jeffglousher/garden-auger-technic/README.md

# Garden auger

A printable housing for a continuous-rotation servo, with an auger for digging in the dirt. Print the parts, add the servo, and hook it up to power and controls.

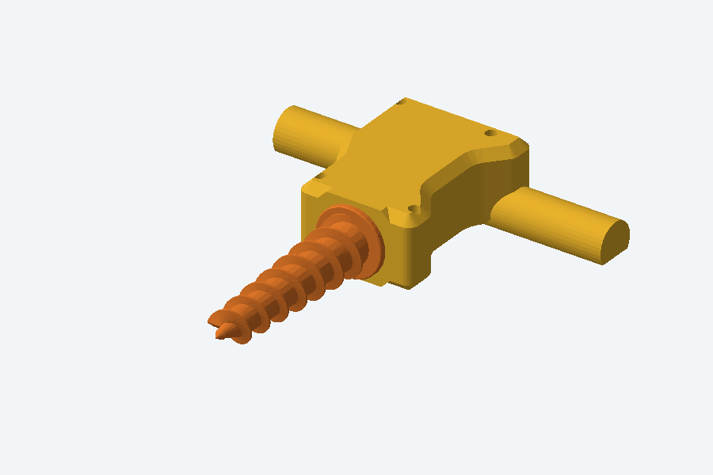
[picture p1: docs/images/turntable.gif]
Garden auger turning, with the auger rotating


## The parts

- A two-piece housing that holds the servo and drive assembly, secured with four screws.
- Rounded handles with flat bases for printing.
- A square drive adapter and replaceable wear bushing.
- A rotating dirt shield at the housing opening.
- Flush color lettering for part labels and hardware details inside the housing.
- Reinforcement around the screw holes and drive adapter.

The housing, auger and adapter use PETG. The bushing uses PLA.

## Inside the housing

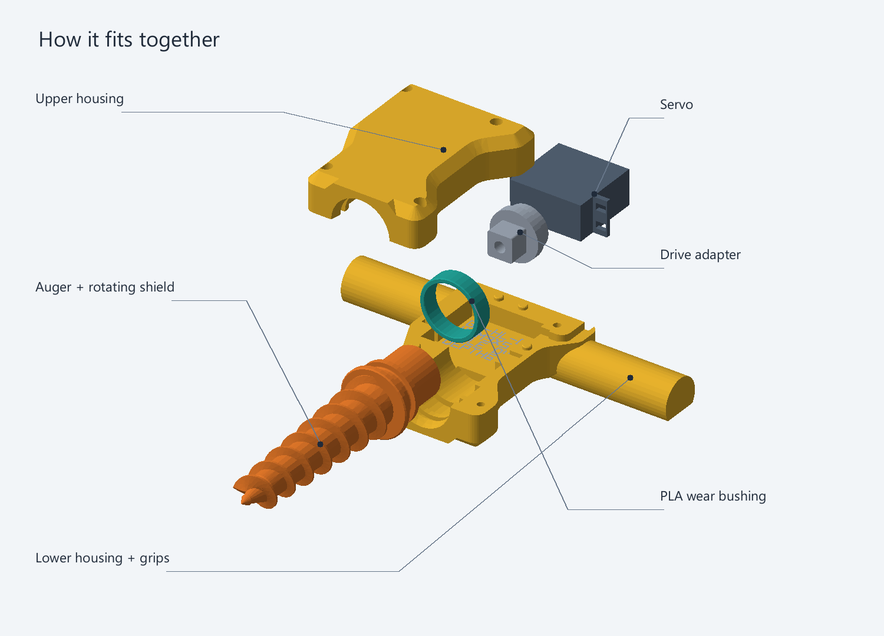
[picture p2: docs/images/exploded.png]
Exploded assembly with part labels


<details>
<summary>Watch it come apart with the drive turning</summary>

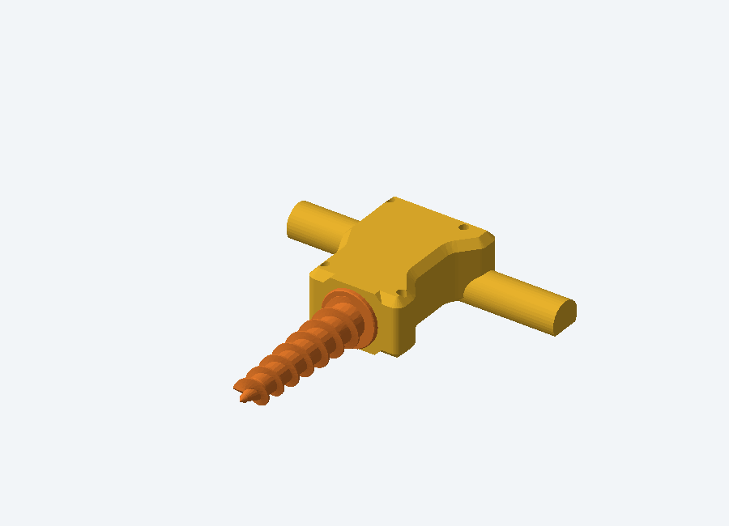
[picture p3: docs/images/exploding-drive.gif]
The housing opens while the auger and adapter rotate


</details>

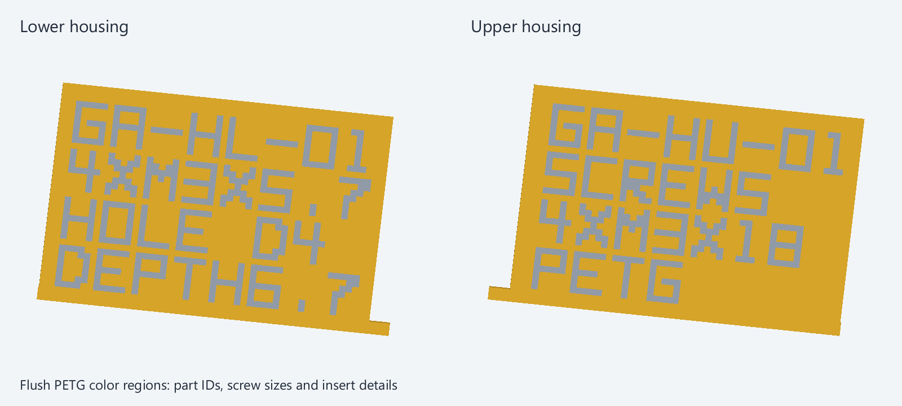
[picture p4: docs/images/inside-labels.png]
Flush part IDs and hardware details inside both housing halves


## How we made it

We designed and refined the assembly in **[Limo CAD](https://github.com/limo-cad/Limo-CAD)**, exported the parts, then prepared the print plates and local reinforcement for Bambu Studio. The CAD model and print settings are included so you can adapt the design to your own setup.

## Print plates

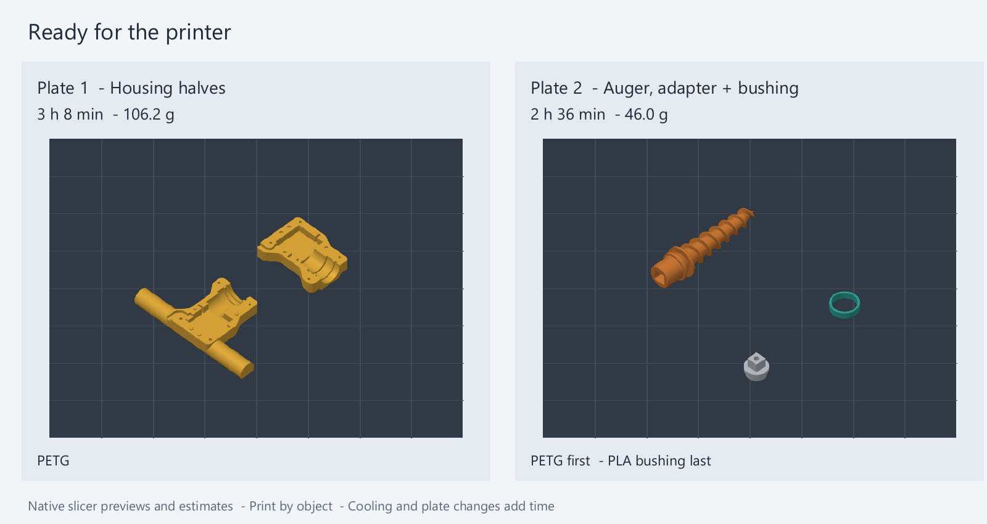
[picture p5: docs/images/print-plates.png]
Both print plates with their native slicing estimates


## Make your own

- [Editable Limo CAD model](garden-auger.limo)
- [Bambu Studio print project](print/garden-auger.3mf) · [Single-color textured lettering](print/garden-auger-single-color.3mf)
- [Individual STL files](print/parts/)
- [Larger lettering test coupons](docs/lettering-coupons.md)

[Assembly notes](docs/assembly.md) · [Design and print workflow](docs/workflow.md)
