jeffglousher/garden-auger-technic/docs/design-decisions.md

# Current design decisions

5 November 2026: [owner review feedback](../source/references/owner-design-review-20261105.json) confirms the **servo-to-adapter connection is proven and complete**. Do not reopen that acceptance from older provisional CAD reports. No new numerical torque rating or dimensions are inferred. The owner approved local reinforcement around the inserts and adapter hub, retained the matched locator fit, and declined the proposed relieved/slot locator arrangement. The current [local-strength print](../garden-auger-local-strength-assembly.3mf) uses five walls and 100% zig-zag infill in nine explicit modifier regions, with the three-wall/15% global baseline elsewhere. Both original housing shapes, all locating diameters/positions and the proven drive interface remain exact. Fresh native cylindrical witnesses and mesh sections confirm the chunky Ø5 x2.8 mm pins and at least 2.6 mm selected socket side stock. [Verification](../local-strength-verification.json) includes native modifier roundtrip, emitted local extrusion, unchanged print meshes and two-plate sequencing. Earlier drive-fit uncertainty is historical; broader joint durability and dirty trials stay in their existing issues.

30 October 2026: the owner clarified that only the orange rotating shield should shrink. Reduce its disc from 40 mm to 38 mm, preserving the current yellow housing and all other components. Nominal opening overlap is 2.2 mm; the existing 0.5 mm radial-offset allowance leaves 1.7 mm. Conditional axial clearance remains 1.1 mm. [Native before/after evidence](../disc38-review.json) compares against the committed 40 mm baseline. This is geometric coverage, not a proven dirt seal.

29 October 2026, printing simplicity requirement: prioritize simple printable solids, robust sections, continuous flat bed lands and controlled vertical bevels. Every extra lip, pocket or seal stage must justify its support and cleanup cost. [The simpler print revision](simple-print-review.md) removes the redundant fixed nose ring and shrinks the rotating flange to a plain 40 mm x3 mm disc with one0.6 mm front chamfer. It sits closer to the direct housing nose; use both matching new halves and auger because the closer disc clashes with older projecting rings. The nominal rear gap remains1.6 mm; opening overlap is3.2 mm. Horizontal auger print height drops48 to40 mm. Fitted internals, grips, flat bases, broad45-degree housing rims, hardware, cable route, adapter and bushing remain. Native support/time/material comparison uses identical saved settings; physical printing and dirty use remain qualification gates.

29 October 2026, auger entrance follow-up: [the integral rotating flange](ingress-flange-review.md) adds a ?48 mm shield ahead of the fixed yellow ridge, 3.4 mm maximum-radius overhang and 1.6 mm nominal rear clearance. A native wraparound-skirt trial trapped the upper lip during closure and was rejected. The final forward flange preserves normal clamshell closure; the housing, flight, adapter, bushing and existing fitted dimensions remain. Only the auger core gains a new revolve. This is noncontact protection, with ingress resistance and packed-soil behavior still requiring the dirty trial. Both print-by-object plates are resliced for the larger horizontal auger height; saved materials, supports, strengths and object order remain.

29 October 2026: [controlled vertical bevels](chamfer-envelope-review.md) supersede the broad R5 face rounds with **5 mm equal-leg, 45-degree chamfers** on both pocket-up housing halves. Retain rounded plan-view transitions; the vertical section controls the print underside. The circular bearing jacket also changes to flat bed lands and 45-degree shoulders so it does not retain a shallow circular underside start. Its original functional cuts, fixed bearing cover and drive datum remain. The complete D grips already start at a 56.63-degree underside tangent and remain rounded for comfort. Both sequential-print plates, materials, fitted cavities, hardware, locators and rear cable route remain; use both matching chamfered halves. Physical qualification is still open.

20 October 2026: the owner confirmed removing material from both broad top/bottom outer faces and left/right walls, while absorbing the plan-view cheek steps. [The rounded-envelope revision](rounded-envelope-review.md) uses R5 outer-face rounds, a slimmer side outline with long blended transitions and an integral bearing jacket protecting the 2.8 mm entry roof. It removes 4.80 cm³ /2.07% net housing volume while retaining fitted features, lower D grips, flat print bases, hardware, cable exit and materials. Body X envelope reduces from77 to75.3 mm; the central41.2 mm depth remains constrained by the fixed bearing seat/cover. Selected wall/contact checks and full functional/native-slice checks accompany the matching CAD/print project. No cosmetic seam scallops are restored; physical strength and fit remain open.

18 October 2026, closed-frame correction: the owner rejected curved cutouts along the inside/seam of the assembled frame. [The continuous-frame revision](solid-frame-review.md) suppresses all eight cosmetic shoulder cuts and rebuilds only the R6 outside front corners. Side walls now meet continuously; the D grips, flat print bases, locating pins, cavities, screw stacks, cable exit, materials and drive components remain. Preserve rounding on exterior corners and profiles; do not reintroduce cosmetic seam recesses. Use the matching solid-frame CAD and complete project listed in the review. Physical acceptance remains open.

18 October 2026, D-grip follow-up: [the new grip review](child-d-grip-review.md) supersedes the large paired handles and preceding layout. Both complete radius-12 D grips belong to the lower housing: 24 mm wide, 18.6 mm high, 20.04 mm flat bed land and 55 mm clear length per side across a 187 mm span. The upper is a central cover; four Ø4/Ø4.3 locators move into the case, and a local rear cheek preserves the existing cable route. Fixed internals and four screw stacks remain. Both plates now pass native by-object slicing at saved clearances, approximately 8 h 42 min /232.0 g total. The 24 mm choice needs an actual hand comfort check; a separate sample is supplied. Physical clamped stiffness, root strength, fit and dirty testing remain open. Earlier statements about handle height, locator locations and by-layer housing layout describe prior revisions.

18 October 2026: [two-plate geometry review](two-plate-geometry-review.md) supersedes the preceding full-print layout. The matching housing plate stays by layer after two native by-object collision rejections. Plate 2 uses verified sequential toolpaths, the rear auger separated from short front objects, and a wait for 55 C before the final PLA bushing. All three design areas were reviewed: R12.5 exterior relief, local X accommodation in the two outer locator sockets, retained drive/bushing fits, and four clear driver approaches. Fixed servo datums, continuous bed floors, cable route and materials remain. Physical stiffness, tightened fit, shaft engagement, threads and dirty trial remain pending.

The owner's latest direction treats the teal part as a **bushing derived from the fixed journal and housing**, releasing its former length as a requirement. The [replacement bushing](constraint-bushing-review.md) retains the radial interfaces, shortens to9.80 mm with0.55 mm end room on each side, and adds inner/outer chamfers at both ends. Housing, shaft, adapter, locating features, screws and cable route remain locked. The new single-part PLA project is the replacement candidate; earlier sleeve measurements and audits remain historical evidence rather than a requirement to preserve that sleeve's length.

On 14 October the owner requested a ring tolerance check and rounder housing sides. The [rounded candidate and audit](rounded-housing-review.md) retain functional dimensions and the sleeve: native ?28.60 bore /?34.00 outside /10.40 length agree with the existing STL. Nominal clearances are0.60 mm to the journal diameter,1.60 mm to the housing diameter and0.50 mm total axial freedom. The owner subsequently confirmed the teal sleeve seems to prevent closure. The [closure audit](../sleeve-closure-review.json) found no seat shrinkage across current CAD or scaling in the six sparse projects. The functional-bushing direction above supersedes preserving the old sleeve length; physical fit of the replacement is the next check. R4 grips/tips, R6 front corners and R9.5 side relief replace sharper exterior features. Use the separately named rounded CAD and matching print projects; earlier candidates remain evidence.

Use these decisions when rebuilding or reviewing the current assembly. On 8 October 2026 the owner reported successful physical fit and assembly of all current parts. The first dirty trial and loaded performance remain pending. Historical alternatives in Git and supplier reference files do not select a different design.

- The owner [reports that the fitment tests succeed and all current parts assemble](../source/references/servo-assembly-fit-feedback-20261008.json), superseding the earlier lower-half-only report. This resolves [physical-fit failure #2](https://github.com/jeffglousher/garden-auger-technic/issues/2); track the first dirty trial in [issue #3](https://github.com/jeffglousher/garden-auger-technic/issues/3). Keep the reviewed geometry and both matching sparse halves as the current baseline. The authorized detail revision is separate from this successful fit baseline. Assembly success does not establish loaded strength, torque, creep, wear, actual shaft engagement or usable screw thread depth.
- The owner explicitly authorized the CAD revision on 8 October 2026 after lifting the machine-use hold. The [detail revision report](clamshell-detail-review.md) records four alternating chamfered handle locators with provisional 0.30 mm diametral clearance, four identical M3 x18 housing screws and unchanged RX-M3x5.7 insert pilots, side/depth shoulder relief and a fixed external auger-entry deflector. Preserve all fitted component cavities and drive/auger/sleeve geometry. The owner tested handle flex while holding the halves together by hand; screwed-joint performance was not tested. New locator fit, hardware engagement and dirty performance remain physical gates. Both detail halves must be used together; the snug-nest pair remains the successful physical baseline.
- The [sparse upper-half Bambu copy](../garden-auger-upper-servo-sparse-test.3mf) is exported directly from the reviewed snug-nest CAD, with the same 0.28 mm layers, 0.50 mm lines, two walls, 5% rectilinear infill, three top/bottom layers, no support or prime tower. Global settings are byte-identical to the [sparse lower-half copy](../garden-auger-lower-servo-sparse-test.3mf); no conflicting object strength overrides are added. Native CAD checks the upper's pocket-up bed placement, and [native Bambu slicing](../servo-upper-sparse-print-verification.json) estimates 1 h 15 min /45.9 g with no supports. Individual bridge-quality and clearance measurements were not separately reported. Preserve original slice reports as dated evidence; the later physical assembly feedback is separate. The CAD typed metadata inspector still rejects rectilinear, so native Bambu results are the process evidence.

- The owner's [caliper readings](../source/references/servo-caliper-readings.json) supersede the drawing for this hardware: **27 mm ear underside to rear case and 38 mm main case length**. The drawing's 41.5 mm tip-to-rear, 37.5 mm case height, 20 mm width, 56 mm ear span and 2.7 mm ear thickness remain source references, not new physical readings. Measurement 4 is unavailable. Do not shift the ear/drive datum from the 27 mm reading alone: it does not establish shaft-to-ear position. Use the [snug-nest CAD test](../experiments/garden-auger-servo-snug-test.limo) and [lower-half test project](../garden-auger-lower-servo-snug-test.3mf). The rear wall remains Y194.0; centred ear slots tighten to Y162.65–165.65; rear-stop-to-wall space is 28.35 mm. Preserve the conservative 41.3 mm case plan bay pending case-to-shaft offset confirmation. It supplies clearance; the ear tips locate X and the clamshell capture faces locate Z. [Source provenance](../source/references/provenance.json) retains the original drawing unchanged.
- One PETG adapter seats directly on the servo's metal shaft, retained by its compatible center screw. Its round pilot has no printed spline teeth. There is no separate metal horn or M4 mounting pattern.
- The pilot is provisionally Ø5.70 ×3.70 mm. Select the diameter from the four physical fit coupons. The [Hitec H25T depth reference](../source/references/hitec-horn-spline-2026.pdf), printed page 75, supplies the 3.70 mm design depth; it is not a universal servo standard.
- Keep the 14 mm rounded square peg, 14.4 mm socket, Ø24 adapter boss, Ø28 ×5 mm flange and full loose PLA sleeve. The clamshell alone captures the collar and sleeve. No ring lock or clip is needed.
- Use the current test housing with its shared entrance taper, **3.00 mm axial ear slot, 56.40 mm ear-tip span and 20.40 mm case/ear capture width**. Nominal total servo movement is 0.30 mm axial and 0.40 mm in each other direction, conditional on source hardware sizes and manufactured fit. The rear adapter chamber ends at Y153.6. Preserve the screw seats and four Ø4.00 ×6.70 mm insert pilots for ruthex RX-M3×5.7 inserts. Add no geometry features or separate servo-retaining hardware.
- Use a continuous flat exterior bed face under both halves. The tightened test's servo floor is 10.40 mm, bearing floor 2.80 mm nominal, and ear-tip side stock is 4.10 mm at the native sampled centre section. Tangent native arcs blend around the ears; do not restore stepped ear bulges or the suspended 2.80 mm floor relief. Handles have 11.50 mm bed lands and 45-degree shoulders, with their rear edge aligned to the body. Their assembled depth is 41.20 mm. The model still has 71 active entries. Nominal or sampled dimensions are not global wall or strength certification.
- Preserve saved Bambu global printer, material, strength, support and purge settings. Set support generation off only for the two housing objects; the upper screw-recess roofs must bridge and need physical print verification. A native automatic-support probe confirms the lower geometry needs no supports. The housing plate requires purge-tower X180/Y142; this is a layout correction, not a process-profile change. The lower-half test file keeps its independently checked single-half tower location.
- The current entrance is Ø33.6 to Ø31.2 in the existing revolve. Check ±0.50 mm tolerance-extreme auger travel separately from ±0.30 mm nominal travel. Native envelope samples also cover the nominal servo-pocket diagonal offset of 0.566 mm. [Consistency audit](design-audit.md) records the prior validation failure and the limits of this coverage.
- Installed flange allowance is ±0.50 mm from the actual front chassis thrust face: 0.20 ear gap +0.10 ear stop +0.10 seat-to-flange +0.10 datum transfer. The conservative square stack gives 8.80–11.20 mm engagement, at least 0.80 mm tip gap and 0.50 mm hub-to-flange gap. These are conditional inspection limits, not native GD&T certification or measured print capability.
- Engage the square before nesting the assembly. The auger and loose sleeve must follow the servo drive axis. Common housing-axis clearance does not certify relative square misalignment; a native 0.30 mm independent-offset control collided. Inspect free axial sliding, alignment and rotation.
- CAD design colors and saved slicer spool colors have distinct purposes; both remain explicit in [README](../README.md). The Bambu project contains current object overrides. Portable 3MF exports carry geometry and material metadata; STLs carry only geometry.

The earlier physical failure was explained by insufficient rear space for the measured 27 mm ear-to-rear distance. The [feedback audit](../servo-fit-feedback-20261007.json) preserves the investigation before caliper readings arrived. The [rear-extension evidence](../servo-27mm-test-verification.json) reproduces the old collision and tests the separate rear extension with a conservative envelope. A native intersection also located a small rear-pad corner that refilled the enlarged pocket; the existing case cut was reordered after both rear pad joins, before the cable and fastener cuts. Add no geometry features. The auger, adapter and sleeve native meshes and materials are unchanged. The revised snug-nest assembly now passes owner fit testing, while shaft-to-ear/front-face datums remain drawing references. The drawing's 37.5 mm case height and its catalog 40.5 mm height remain inconsistent source values; the test reference is explicitly a clearance envelope, not a fully measured servo. Preserve the owner's modified lower-half Bambu template and its object/process settings. Dirty-trial behavior, usable screw depth, shaft engagement, loaded torque, creep and wear remain unconfirmed. The redundant rear-extension print and abandoned horn STEP/PDF were removed with recovery recorded in [cleanup history](../release-cleanup.json); keep older CAD and templates that still support rebuilds or evidence.

The separate CAD application team owns the 3MF feature work tracked in [Limo-CAD issues #312–#316](https://github.com/jackControls/Limo-CAD/issues/312). This repository continues to use its existing export and Bambu preparation scripts until those capabilities are implemented and verified.

New experiment findings are filed as [assembly animation #346](https://github.com/jackControls/Limo-CAD/issues/346), [named-view camera #347](https://github.com/jackControls/Limo-CAD/issues/347), [hole inference #348](https://github.com/jackControls/Limo-CAD/issues/348), [cable routing #349](https://github.com/jackControls/Limo-CAD/issues/349), [wall thickness #350](https://github.com/jackControls/Limo-CAD/issues/350) and [fit stacks #351](https://github.com/jackControls/Limo-CAD/issues/351). Our own packaging script's reset of user object settings is [project issue #1](https://github.com/jeffglousher/garden-auger-technic/issues/1); the related user feedback is attached to [3MF handoff #316](https://github.com/jackControls/Limo-CAD/issues/316#issuecomment-6035859200). The [issue index](../experiments/upstream-issue-index.json) records evidence, categories and links. Keep findings in issues. As requested by the owner on 8 October 2026, repository changes now go through PRs and are merged immediately after validation. CAD application implementation still waits until the owner confirms [Bevy finalization](https://github.com/jackControls/Limo-CAD/issues/38). Observed application bugs need reproduction against that finalized build before a fix is claimed; current experiments remain external project tooling.

The cable exits the rear face toward the controls through a 6 ×8 mm split-seam route with one tangent R8 trial bend. The side outlet and its exterior bulge are superseded by the user's rear-routing preference. The rear outlet is centered at X28/Y206.5 and clears the screw at X16/Y196.8. The old straight route ended inside a handle, and a later pad join partly filled its boot bay. Reuse and reorder the existing cable cut after all housing joins. Keep the connector outside. Bundle, boot, seam entry and minimum bend radius remain trial assumptions requiring physical fit. The [native cable experiment](../cable-route-verification.json) tests continuous Ø4/Ø5 swept envelopes and rejects Ø6.2, without adding a cable to print exports or claiming flexible-wire mechanics.
