jeffglousher/garden-auger-technic/docs/servo-fit-review.md

# Servo fit review — 7 October 2026

## Current snug-nest test

**Next physical print uses [the matching sparse upper-half copy](../garden-auger-upper-servo-sparse-test.3mf).** The owner [reports the lower half seems OK](../source/references/servo-lower-fit-feedback-20261007.json) and requests the other side with the same dimensions. This upper is exported directly from body 26 of the reviewed snug-nest CAD; no CAD geometry is modified. It uses the lower sparse project's identical saved global process, printer and filament bytes: 0.28 mm layers, 0.50 mm lines, two walls, 5% rectilinear and three top/bottom layers, no supports or prime tower. Native CAD checks one pocket-up upper half on its outer bed face and native Bambu estimates **1 h 15 min /45.9 g**, with zero support toolpaths or filament changes. [Upper verification](../servo-upper-sparse-print-verification.json) records native export/placement equality, a closed connected solid, package hashes and preserved files. Inspect screw-recess bridges physically; matching-half closure and complete assembly fit remain pending.

The [sparse lower-half copy](../garden-auger-lower-servo-sparse-test.3mf) preserves every model/bed-transform byte from the stronger reviewed lower copy and removes strength overrides so Global settings apply. Native Bambu estimates 1 h 12 min /45.3 g with no support or prime tower. The same lower geometry's stronger profile estimates 3 h 26 min /109.2 g. [Lower native slice proof](../servo-sparse-print-verification.json) records these results and the CAD inspector's unsupported-rectilinear limitation. Native slicing also found and verified a correction to the helper's OPC relationship serialization; this changed package spelling only.

The previous review checked clearance but allowed unnecessary movement. Independent native probes using the measured 38 mm case length and 27 mm rear length showed about 0.90 mm total X travel, 0.80 mm Z travel and 0.40 mm Y travel in the rear-extension test, conditional on the drawing's ear envelope and shaft-to-case offset. The 41.30 mm body clearance bay does not itself locate the smaller case. Ear outer ends and clamshell capture faces must do that job.

The [current CAD test](../experiments/garden-auger-servo-snug-test.limo) reuses its two existing pocket cuts:

- Axial ear slots: **3.00 mm**, Y162.65–165.65 around source ear faces Y162.8–165.5. Nominal total axial movement is **0.30 mm**.
- Ear outer-tip capture: **56.40 mm**, X−38.2 to +18.2 around the source 56 mm span. Nominal total lateral movement is **0.40 mm**.
- Case/ear capture between halves: **20.40 mm**, Z±10.2 around the source 20 mm width. Nominal total capture movement is **0.40 mm**. The continuous flat floor gains 0.20 mm stock, becoming **10.40 mm** locally; exterior/handle geometry is unchanged.
- Rear ear stop to rear wall: **28.35 mm**, leaving **1.35 mm** behind the measured 27 mm rear length at the rearward stop. The rear wall remains Y194.0. Keep the case cut after both rear pad joins so they cannot refill its corner.
- The conservative 41.30 mm case plan bay remains clearance space. Its 3.30 mm excess over the measured 38 mm case is not the servo's travel allowance. A tighter body bay would require the actual case-to-shaft/ear offset; do not invent that datum.

Native exact checks clear the independent solid-ear probe at X/Z±0.19 mm and Y±0.14 mm, and reject X/Z±0.21 mm and Y±0.16 mm. Separate principal-axis angular samples about the ear-centre pivot clear ±0.1° and reject ±1°; they do not establish maximum angular play or a combined six-DOF contact envelope. Nine coupled assembly offset poses and 24 auger rotation/end-float samples pass. The lower half is one closed connected native-export mesh. The print presentation matches its Bambu bed placement and passes native envelope preflight. The available section tool returns material intervals excluding voids; this is sampled geometry, not a strength or global minimum-wall calculation.

The [raw native review](../servo-snug-review.json) retains face keys, tool outputs, build hashes, settings inspection and limitations. [Ear-nest section](../renders/servo-snug-ear-nest.svg), [floor section](../renders/servo-snug-servo-floor.svg), [square socket](../renders/servo-snug-square-socket.svg), [adapter seat](../renders/servo-snug-adapter-seat.svg) and [PLA bushing](../renders/servo-snug-pla-bushing.svg) are unmodified native section diagrams.

The square remains 14.0/R1 into 14.4/R1.2, with 10 mm nominal engagement, 2 mm tip room and 1.6 mm flange gap. Journal/bushing remain Ø28/Ø28.6; the full PLA ring is Ø34 in a Ø35.6 housing chamber. Collar end float remains 0.6 mm; sleeve end float remains 0.5 mm. Four native insert pilots remain Ø4.0×6.7 mm for RX-M3×5.7 inserts. The adapter retains its Ø5.7×3.7 trial pilot, Ø24 boss, Ø28 flange, 2.6 mm seat-to-head-seat stack and Ø3.4/Ø6.4 passage/access. Native faces confirm these values, and all four non-housing body meshes are unchanged. Retain the conservative existing installed-position acceptance limits; their hardware datums still need physical confirmation.

**Print next: [the matching sparse upper-half Bambu test](../garden-auger-upper-servo-sparse-test.3mf).** Pair it with the revised sparse lower half already tested by the owner. The [stronger-profile lower copy](../garden-auger-lower-servo-snug-test.3mf) has the same reviewed lower geometry with its saved strength overrides retained. All three test projects were natively sliced; their estimates and package hashes are recorded above. The owner's saved [original lower-half template](../garden-auger-lower-fit-test.3mf), preserved in commit `fb259e4`, contains historical geometry that failed fit. File names and modification times do not select a print candidate. Final capture requires both matching revised halves. These small clearances are trial design values, not measured printer capability. Only 27 and 38 mm are new hardware readings; measurement 4 is unavailable, and 41.5 mm remains a drawing reference. The 20 mm width, 56 mm ear span, 2.7 mm ear thickness and shaft offsets also remain source references. The reference deliberately remains a clearance envelope rather than a fully measured servo. No clip, separate servo clamp or new hardware is introduced.

## Physical feedback before further prints

Record the exact project printed and report these observations in [project issue #2](https://github.com/jeffglousher/garden-auger-technic/issues/2):

1. Servo seating and play: does the rear case clear the wall and do both ears seat fully? Describe axial, lateral and across-seam movement separately.
2. Matching-half closure: with a revised upper half, do the mating faces close fully without forcing the servo? A lower-half-only test leaves this check pending; an older upper half does not verify revised capture.
3. Adapter alignment and seating: does the square engage and slide freely with the adapter seated on the servo? Actual shaft engagement and usable screw thread depth remain unconfirmed; report them separately from housing fit.
4. Auger rotation: does the assembled auger turn freely and retain collar/sleeve end float without binding?
5. Cable routing: does the actual boot and bundle fit the rear exit without pinching when the halves close, with the connector outside?

Keep issue #2 open pending physical feedback. Obtain that feedback before declaring production ready or printing dense replacements. Native checks are sampled geometry evidence; they do not establish manufactured fit, strength or complete GD&T compliance. Request additional calipers only when an observed problem requires them, using clearly numbered marked images and without inventing shaft-relative offsets or measurement uncertainty.

## Earlier corrections — historical

**Physical-test update: the owner measures 27 mm ear underside to rear case, versus 24.7 mm in the drawing.** The production housing has only 26.0 mm from its rear ear stop to its rear wall. The correction below is historical. The [original feedback audit](../servo-fit-feedback-20261007.json), [caliper readings](../source/references/servo-caliper-readings.json) and [rear-clearance checks](../servo-27mm-test-verification.json) preserve the measured failure and first separate 2.3 mm rear-extension test. That test is superseded by the snug-nest test above.

The model was wrong. The 24.7 mm dimension in your diagram starts at the **underside/rear face of the mounting ear**. The servo reference and housing used its opposite face, moving the ears and pockets 2.7 mm rearward. The same error in both parts made the previous clearance check falsely pass.

Seating the drawing-dimensioned servo in those old pockets placed its rear face 1.2 mm beyond the cavity. That correction restored the drawing datums, cleared the larger catalog case length and accounted for the resulting adapter-position stack. **The auger, square adapter, PLA sleeve and four fit coupons remained byte-identical to that previous release. The new physical fit failure requires further investigation before reprinting either housing half.**

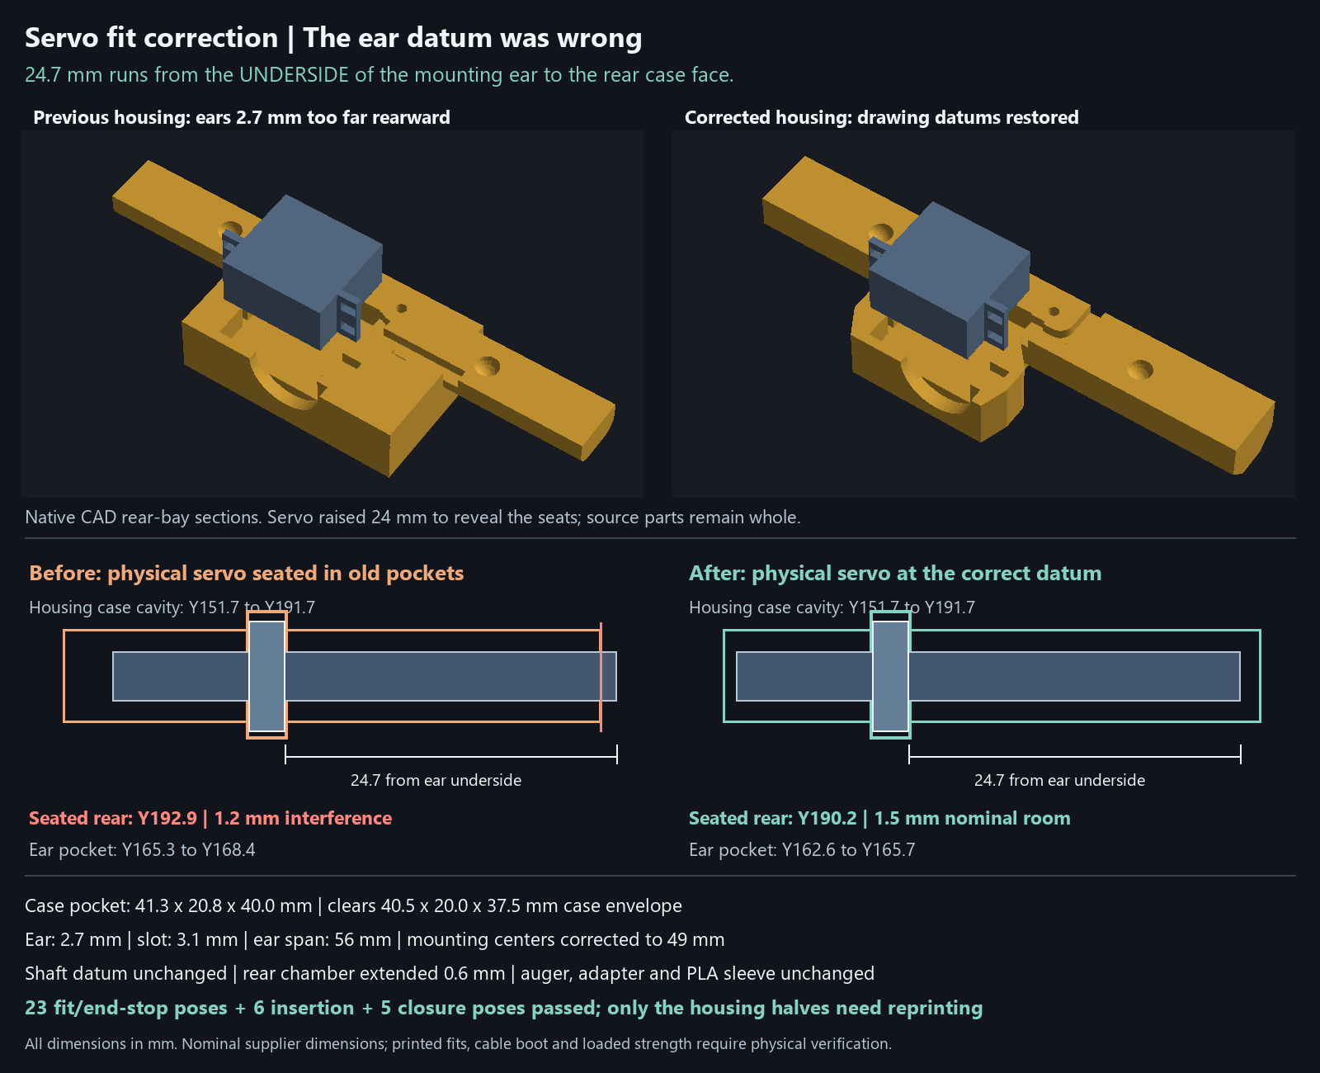
[picture p19: renders/housing-preprint-review.png]
Native CAD and dimensioned before/after comparison


## Dimensional authority and correction

The [original supplied image](../source/references/user-servo-fit-diagram.png) is retained unchanged with its SHA-256 in [source provenance](../source/references/provenance.json). It labels the 270° variant; the retained 360° supplier image has the same mechanical datums. The requested INJS035-360 drive remains the selected servo. The detailed mechanical drawing controls axial datums; the catalog's separate 40.5 ×20 ×40.5 summary does not override the explicitly drawn 37.5 mm case height and 41.5 mm tip-to-rear distance.

Every shown mechanical dimension was checked:

- Case plan: drawing 40 ×20 mm; the larger 40.5 mm catalog length is used conservatively. The cavity is **41.3 ×20.8 mm**, giving 0.4 mm clearance on each side of the larger case envelope.
- Shaft tip to rear case: **41.5 mm**; case axial height **37.5 mm**. Their difference is **4.0 mm nominal tip-to-case-front separation**. The reference contains no invented stationary nose.
- Ear underside to rear case: **24.7 mm**; ear thickness **2.7 mm**. With the shaft tip at world Y148.7, case faces are Y152.7/Y190.2 and ear faces are **Y162.8/Y165.5**.
- Corrected housing ear pockets: **Y162.6–165.7**, 3.1 mm wide axially, with 0.2 mm nominal clearance on each ear face. Previous pockets were Y165.3–168.4.
- Case cavity axial span: **Y151.7–191.7**, 40.0 mm. This already had sufficient total length at the correct datum: 1.0 mm nominal front room and **1.5 mm nominal rear room**, or 1.3 mm rear room at the nominal rearward ear-travel limit. Moving the ear seat restores the available length behind it from 23.5 to **26.2 mm**, exceeding the required 24.7 mm.
- Ear overall span: **56 mm**. Reference mounting-slot centers corrected from 52 to **49 mm** apart. The shaft is **10 mm from the right case edge**, centered across the 20 mm width. Slot widths/radii are not dimensioned; their conservative reference cut envelopes are retained. The fit inspection fills the ears solid, so those holes cannot hide a collision.

The two housing halves receive the same corrected case and ear cuts. The existing cut features are reused; no extra retaining hardware or grooves are added. The later exterior-thinning revision reuses these corrected pockets and removes eight obsolete entries, leaving **73 active history entries**. Materials, colors and assembly poses are preserved.

## Mating surfaces and tolerance stack

The adapter, auger and sleeve are unchanged. The existing Ø29.6 rear chamber ends at **Y153.6**, 0.6 mm farther rearward, to accommodate the corrected installation allowance. Adapter rear clearance is **1.2 mm nominal /0.5 mm conditional minimum** under the audited allowance below. Boss radial clearance is 2.8/2.2 mm; flange radial clearance is 0.8/0.2 mm.

The consistency audit adds the omitted **0.10 mm datum-transfer allowance** to the former 0.40 mm budget. Inspect the installed flange **27.40 ±0.50 mm behind the actual front chassis thrust stop**: 0.20 mm ear gap +0.10 mm ear-stop extrema +0.10 mm seat-to-flange extrema +0.10 mm transfer to the printed thrust face. World Y141.1 is the nominal CAD flange location, not a physical inspection datum. Common drive-axis radial offset must be no more than 0.50 mm; relative square alignment is a separate requirement.

Critical printed dimensions and functional-face extrema require ±0.10 mm acceptance; this includes surface form at the contact extrema. Collar/sleeve length and capture-span controls also apply. These are inspection requirements, not measured printer capability, supplier tolerances or native GD&T certification. The audited conservative square stack gives **8.8–11.2 mm engagement**, **at least 0.8 mm peg-tip clearance**, and **at least 0.5 mm hub-to-flange clearance**. The 14 mm/R1 peg and 14.4 mm/R1.2 socket retain at least 0.10 mm flat clearance per side under the profile controls only when their mating datums align. Engage the square first and let the auger and loose sleeve follow the servo axis before closing the housing.

The integral collar retains both thrust stops and 0.6 mm nominal total end float, conditional 0.4–0.8 mm. The loose PLA sleeve retains 0.5 mm nominal float, conditional 0.3–0.7 mm. The [consistency audit](design-audit.md) widens only the entrance end of the existing flight taper from Ø33.2 to **Ø33.6** to cover the full axial tolerance budget and diagonal offsets. The Ø31.2 collar-stop opening stays unchanged. The split-seam cable path is now 6 mm wide ×8 mm high with one tangent trial R8 turn to the rear face toward the controls. [Routing evidence](../cable-route-verification.json) checks assumed cable envelopes; cable-boot dimensions and acceptable bend radius are not shown in the diagram.

## Hardware and materials

- Four **ruthex RX-M3×5.7** heat-set inserts, Ø4.6 ×5.7 mm, use unchanged **Ø4.00 ×6.70 mm** pilots. The full cable-boot bay leaves at least **3.07 mm sampled surrounding wall after allowance** at the closest rear insert. Install flush with the split face.
- Housing screws remain **two M3×12 front and two M3×18 rear**. Nominal insert engagement is 4.0/5.3 mm. Passages and insert mouths remain open.
- The adapter retains its **Ø5.70 ×3.70 mm trial pilot**, Ø24 boss, Ø28 ×5 flange, 2.60 mm seating web, Ø3.4 center passage and Ø6.4 head access. The nominal trial center screw is **M3×6**, with 3.4 mm nominal insertion and 3.1–3.7 mm conditional insertion. A usable shaft-hole depth of at least 4.0 mm is required; internal thread depth and factory screw length are not shown in the diagram. Native printed-part screw clearance is verified; actual bottoming and thread engagement remain physical checks.
- CAD/portable export: housing **PETG yellow #E5AE3C**, auger **PETG orange #D57E37**, adapter **PETG gray #BEC3CA**, sleeve **PLA teal #37AAA1**.
- Bambu's saved spool palette remains **#034638, #FF671F, #FFFFFF, #DCF478** with PETG Basic /PLA Glow profiles. Housing: 6 walls, 30% gyroid, 6 top/bottom layers. Auger: 6 walls, 40% gyroid, 6 top/bottom layers. Adapter: 6 walls, 100% infill. Existing tree supports and PLA interfaces are retained.

## Evidence and delivery

The subsequent [direct CAD tool review](cad-tool-validation.md) distinguishes native tool results from separately derived tolerance bounds. Its [inspection project](../garden-auger-fit-inspection.limo) contains associative nominal measurements; its [raw results](../cad-tool-validation.json) retain the tool's warnings and limitations.

The [independent servo fit regression](../servo-fit-verification.json) recreates the old failure from literal drawing dimensions, rather than reusing production parameters. It confirms the old erroneous reference passed, while the correct envelope collided with both halves. The corrected native solids pass **23 fit/end-stop checks**, **6 lower-half insertion poses** and **5 upper-half closure poses**. The two beyond-limit poses correctly encounter the ear stops. The final document contains no inspection probe or temporary screw body.

The [component review](../preprint-review.json) separates **45 nominal housing-only motion poses** from five native conservative flight-envelope samples at +0.50 mm travel and six full coupled assembly poses. It retains the intentionally failed 0.30 mm relative-square-offset control. The [adapter review](../adapter-housing-verification.json) checks nine installed-position samples. Canonical meshes, closed connected print solids, native schema-7 desktop round trips, material/pose preservation and the seven unchanged non-housing STLs are recorded in [release verification](../direct-drive-verification.json), [nesting verification](../housing-nesting-verification.json) and [Bambu layout verification](../bambu-latest-verification.json). [Native Bambu slice verification](../bambu-slice-verification.json) records the refreshed four-plate check. These checks do not replace a native motion sweep or GD&T validator, which the available tool does not provide.

These historical artifacts are retained for provenance: [earlier editable CAD](../garden-auger-direct-drive.nbcad), [complete Bambu project](../garden-auger-bambu-latest.3mf), [lower housing STL](../print-parts/direct-drive/petg-housing-lower.stl) and [upper housing STL](../print-parts/direct-drive/petg-housing-upper.stl). Their housing geometry failed physical fit. [All-part CAD views](../renders/direct-drive-all-parts.png) and [exploded assembly](../renders/direct-drive-exploded.png) show that earlier assembly. Use the reviewed snug-nest CAD and matching sparse upper-half project at the top of this review for the next test.

The corrected geometry matches the shown mechanical dimensions. Physical verification still applies to unshown cable-boot and thread details, actual printed fits, and loaded torque/creep/wear. Those checks do not reopen the confirmed dimensions in your drawing.

The current exterior revision restores a continuous printable floor, blends the ear exterior and supports the grips from the bed. Case/ear pockets, drive seats and screw-head planes remain unchanged. The updated native fit checks use this saved source. See [print evidence and bridge limits](../housing-print-verification.json).
