jeffglousher/garden-auger-technic/source/horn-1906-0025-0032/spec-sheet.pdf

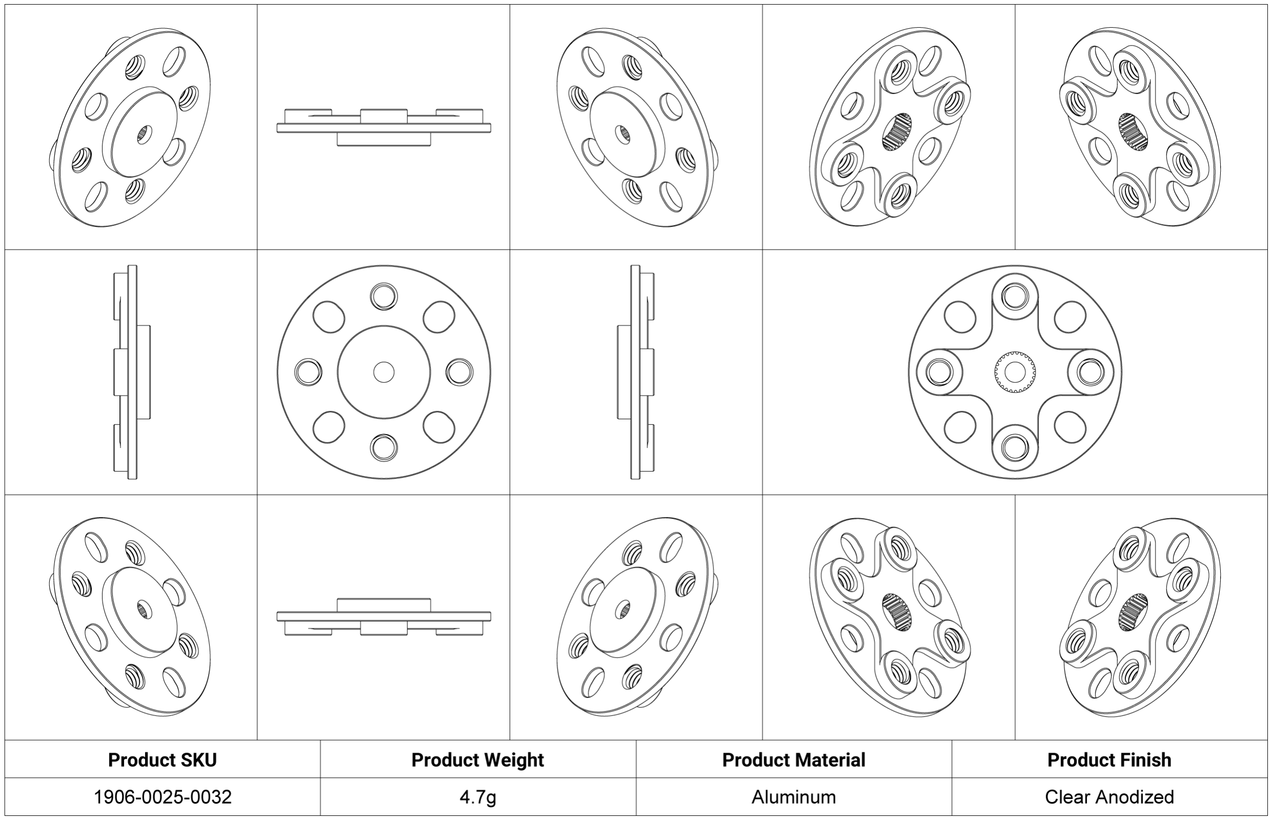
[picture p23: page 1]
