jeffglousher/garden-auger-technic/renders/auger-exploded.png

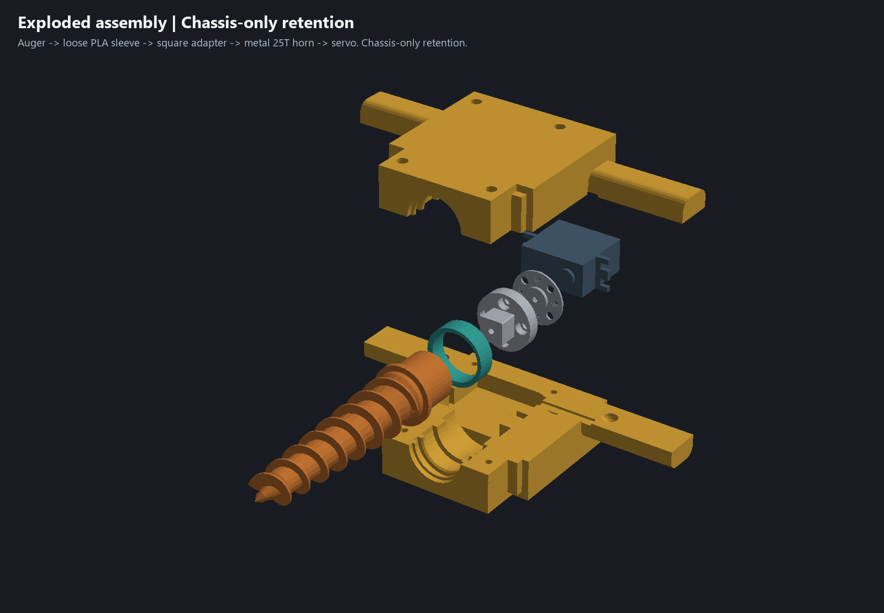
renders/auger-exploded.png
