jeffglousher/garden-auger-technic/renders/bambu-studio-latest.jpg

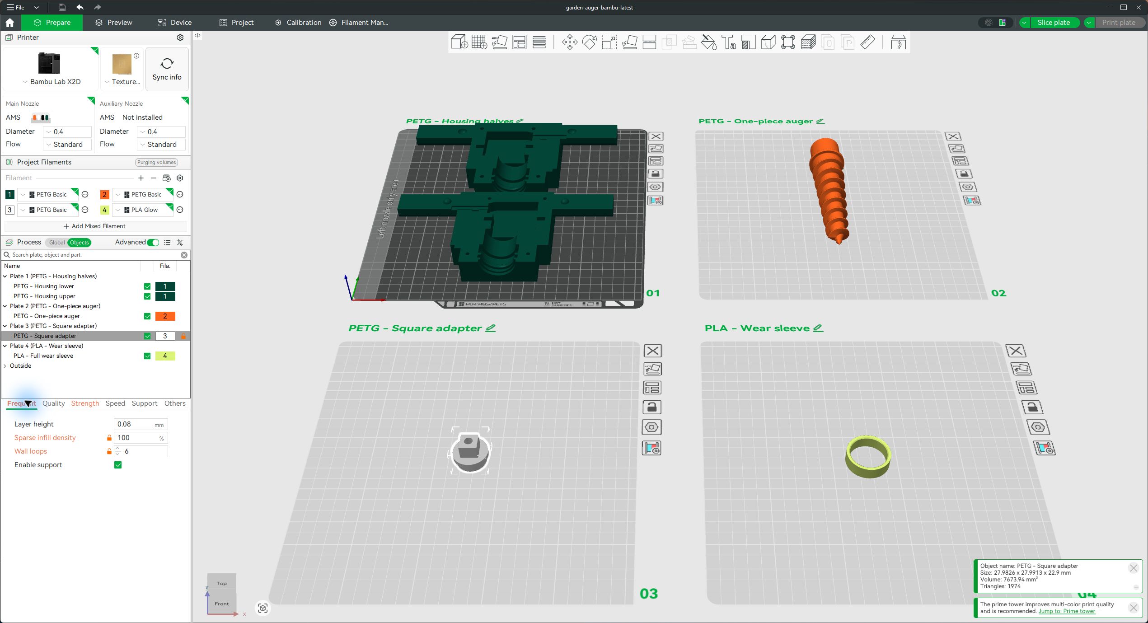
renders/bambu-studio-latest.jpg
