jeffglousher/garden-auger-technic/renders/bambu-studio-review.jpg

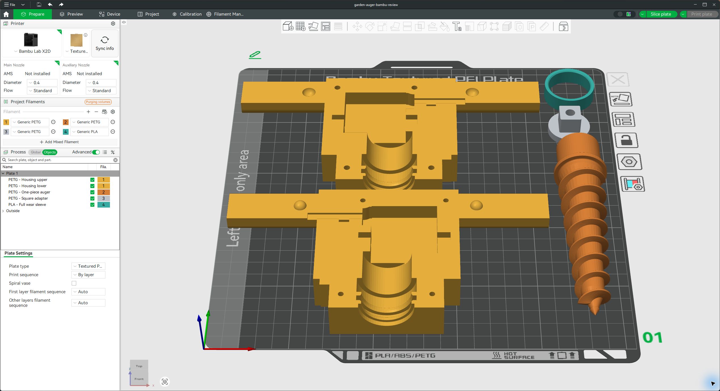
renders/bambu-studio-review.jpg
