jeffglousher/garden-auger-technic/renders/cad-cable-route-isometric.png

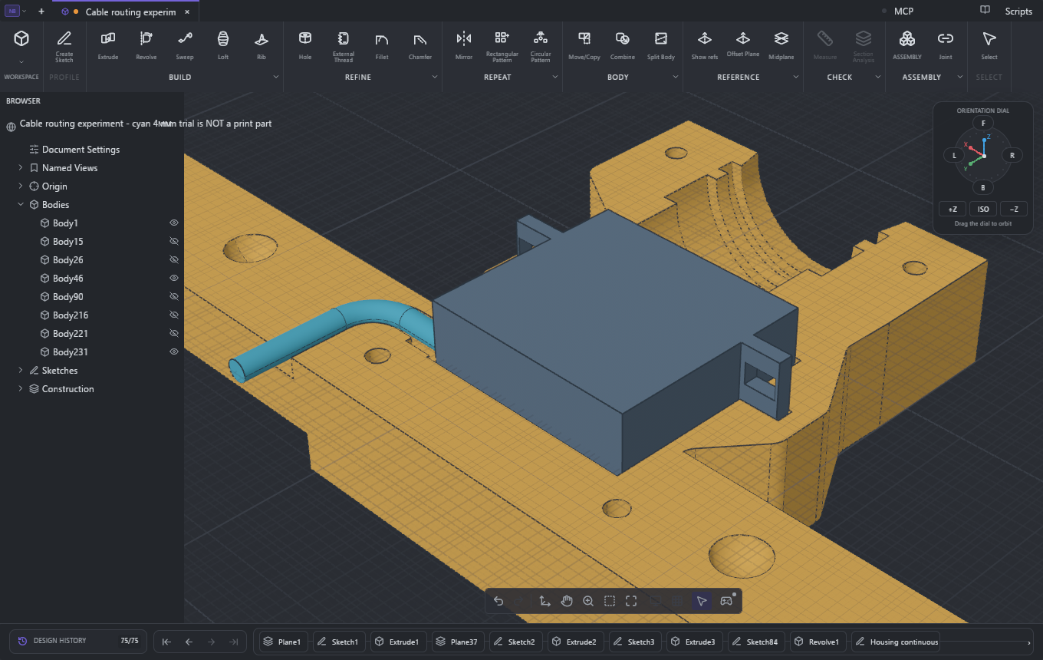
renders/cad-cable-route-isometric.png
