jeffglousher/garden-auger-technic/renders/cad-cable-route-top.png

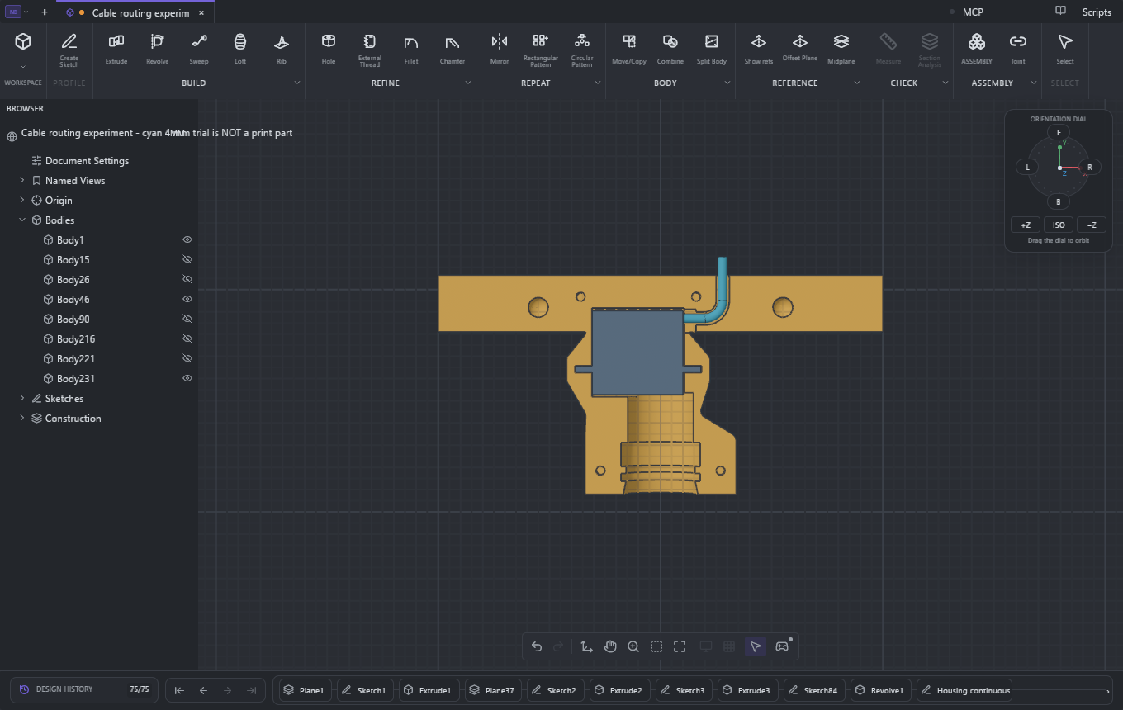
renders/cad-cable-route-top.png
