jeffglousher/garden-auger-technic/renders/cad-depth/adapter-front.png

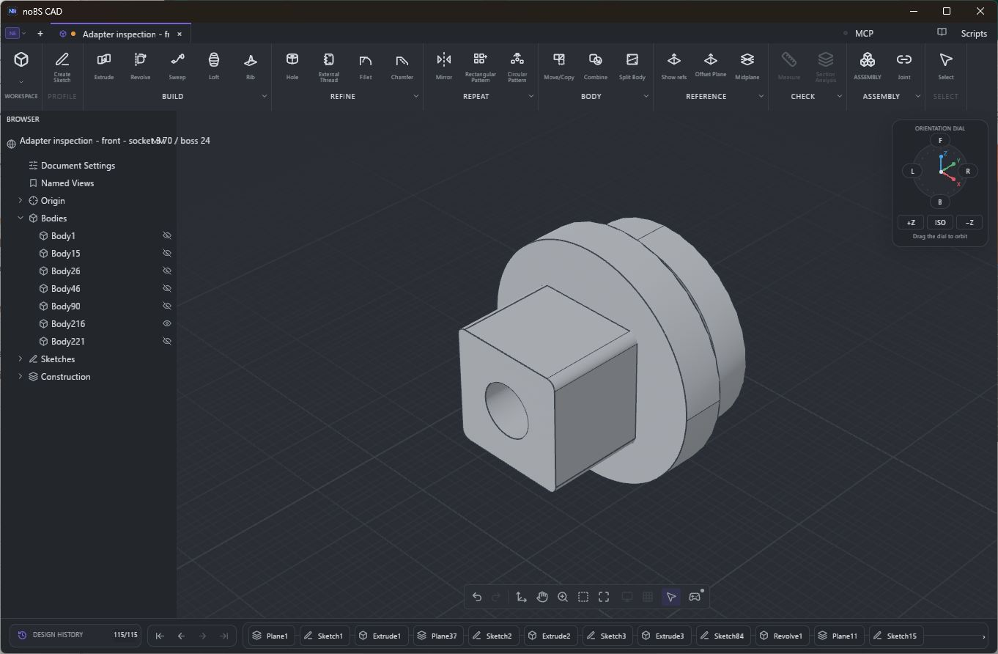
renders/cad-depth/adapter-front.png
