jeffglousher/garden-auger-technic/renders/cad-depth/adapter-rear.png

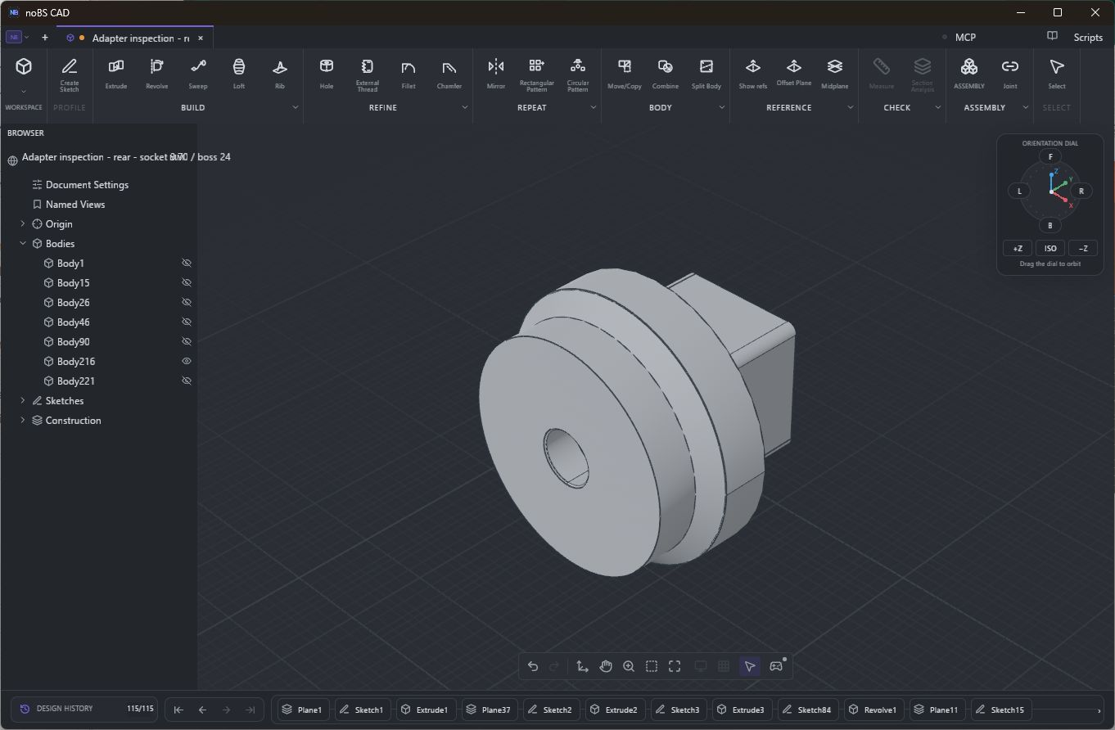
renders/cad-depth/adapter-rear.png
