jeffglousher/garden-auger-technic/renders/cad-depth/adapter-revision.png

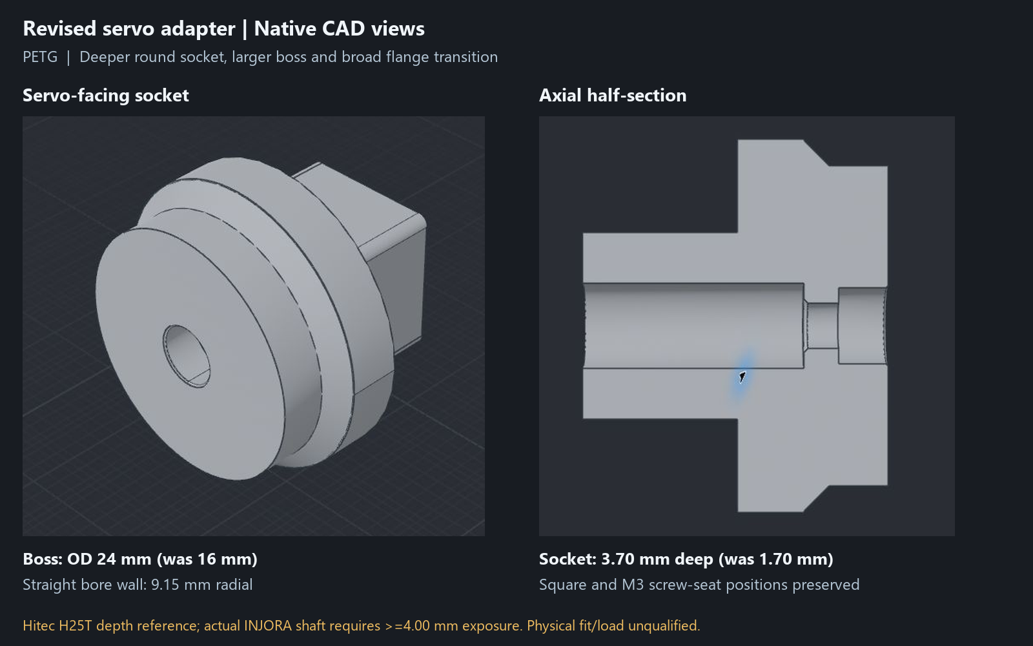
renders/cad-depth/adapter-revision.png
