jeffglousher/garden-auger-technic/renders/cad-depth/adapter-section.jpg

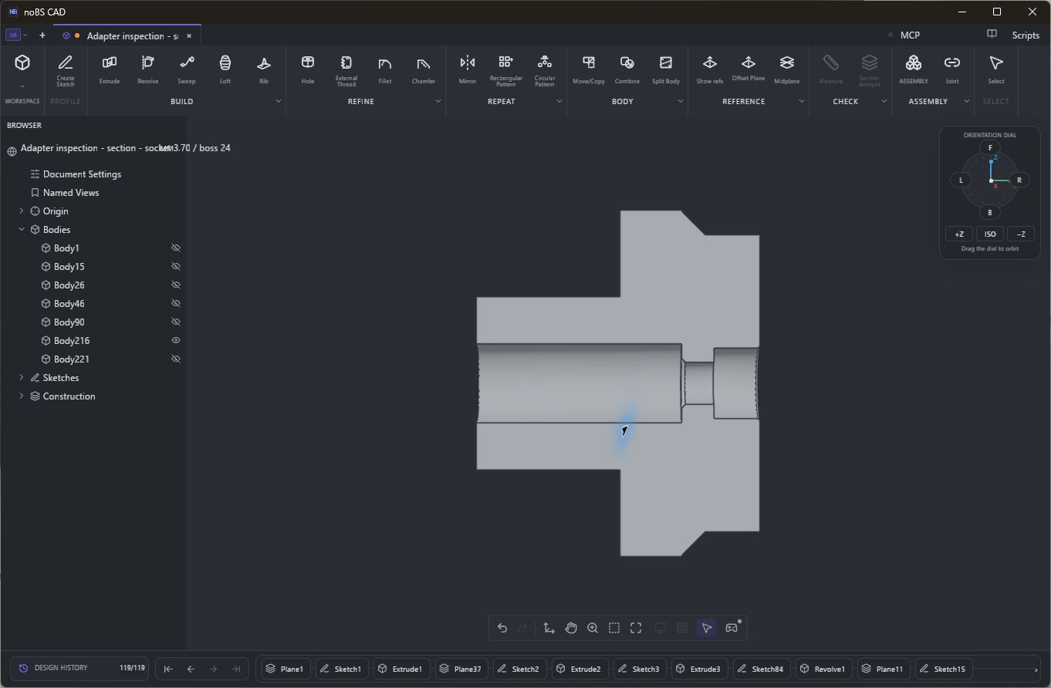
renders/cad-depth/adapter-section.jpg
