jeffglousher/garden-auger-technic/renders/cad-exploded.png

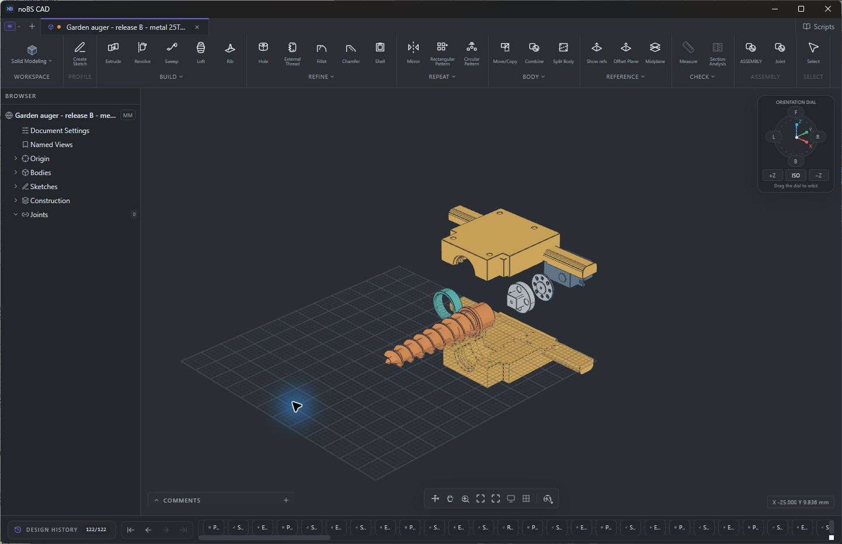
renders/cad-exploded.png
