jeffglousher/garden-auger-technic/renders/cad-housing-underside.png

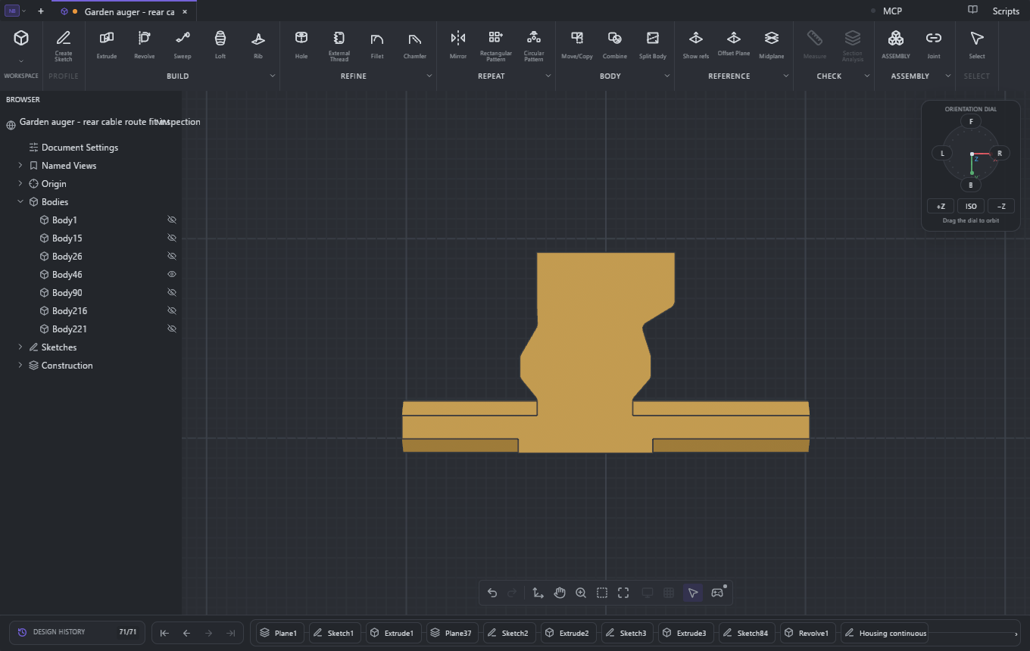
renders/cad-housing-underside.png
