jeffglousher/garden-auger-technic/renders/cad-mating/01-square-drive.png

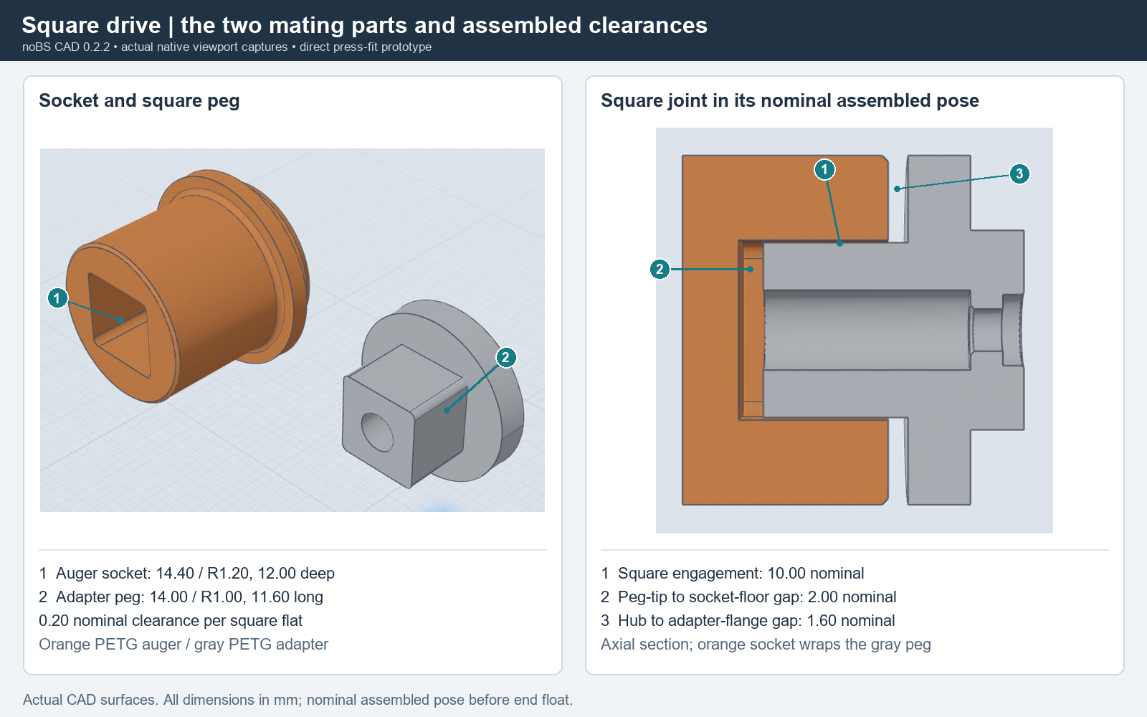
renders/cad-mating/01-square-drive.png
