jeffglousher/garden-auger-technic/renders/cad-mating/02-servo-and-screw.png

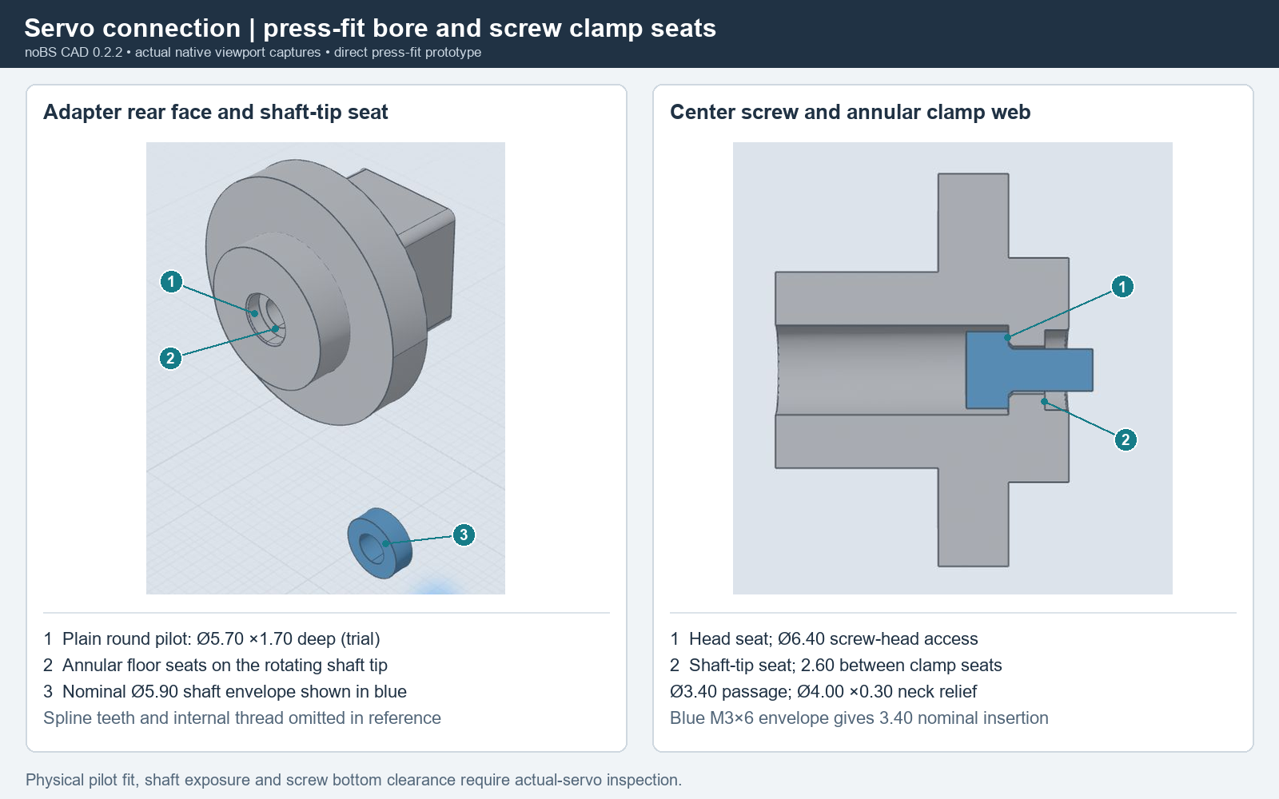
renders/cad-mating/02-servo-and-screw.png
