jeffglousher/garden-auger-technic/renders/cad-mating/03-bearing-and-capture.png

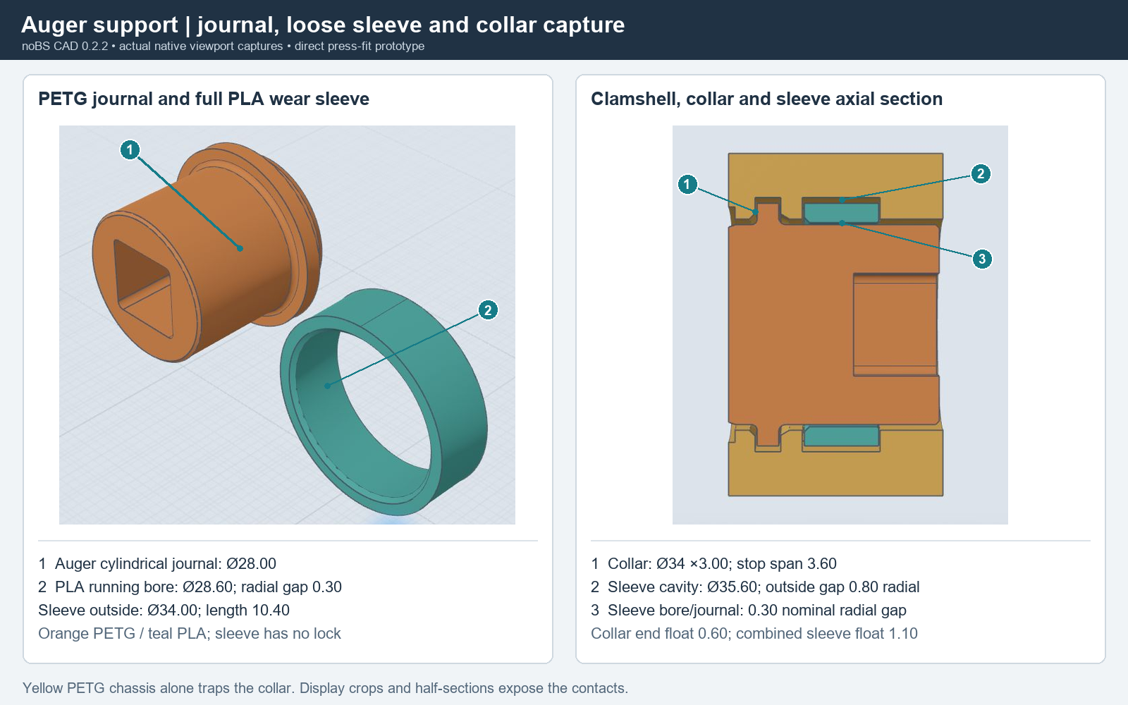
renders/cad-mating/03-bearing-and-capture.png
