jeffglousher/garden-auger-technic/renders/cad-mating/04-clamshell-and-inserts.png

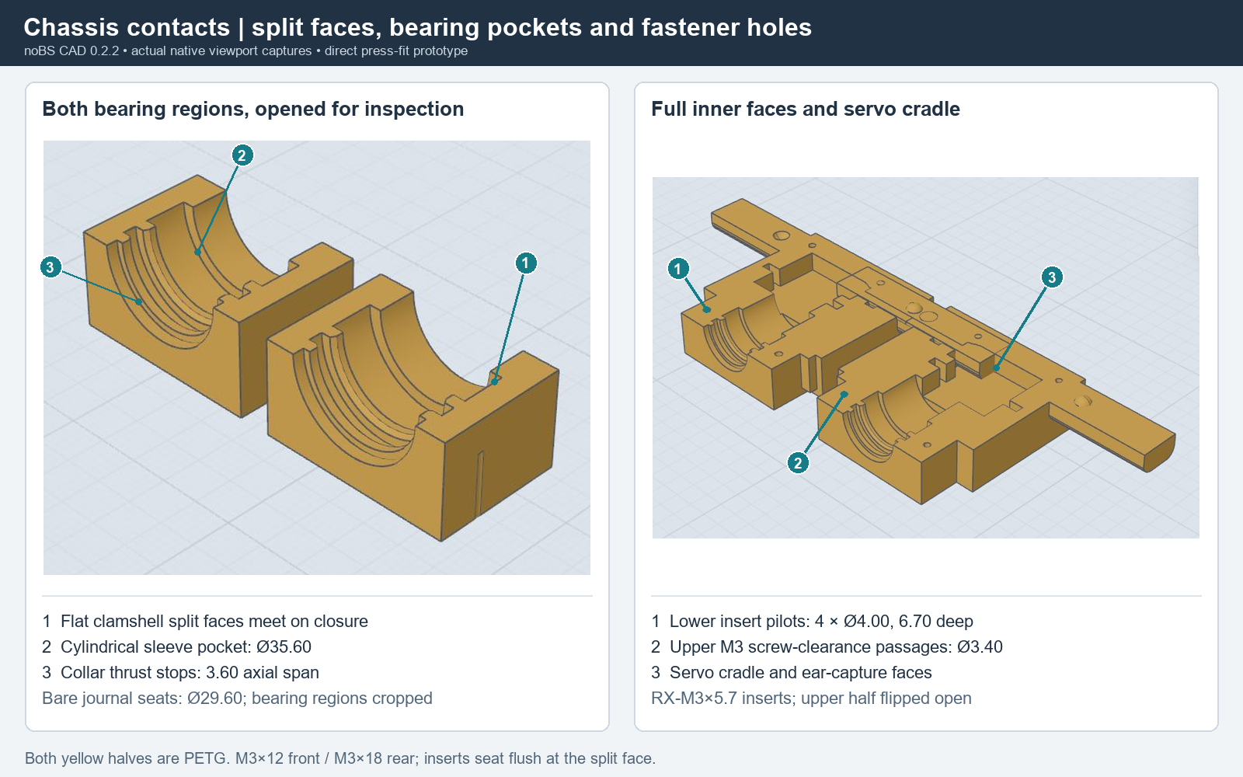
renders/cad-mating/04-clamshell-and-inserts.png
