jeffglousher/garden-auger-technic/renders/cad-mating/capture-native.png

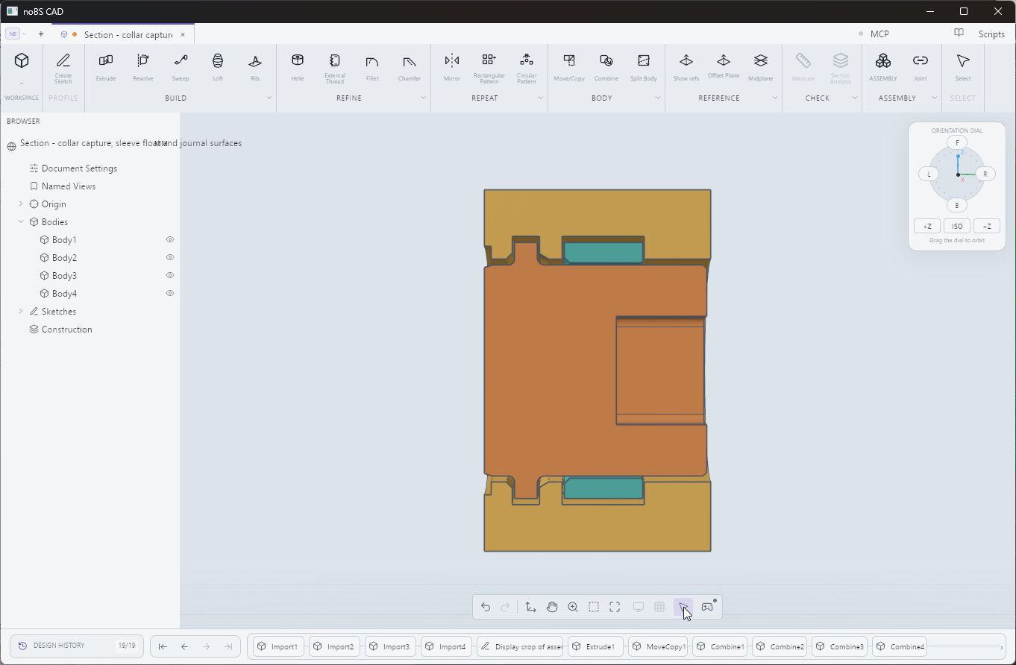
renders/cad-mating/capture-native.png
