jeffglousher/garden-auger-technic/renders/cad-mating/chassis-native.png

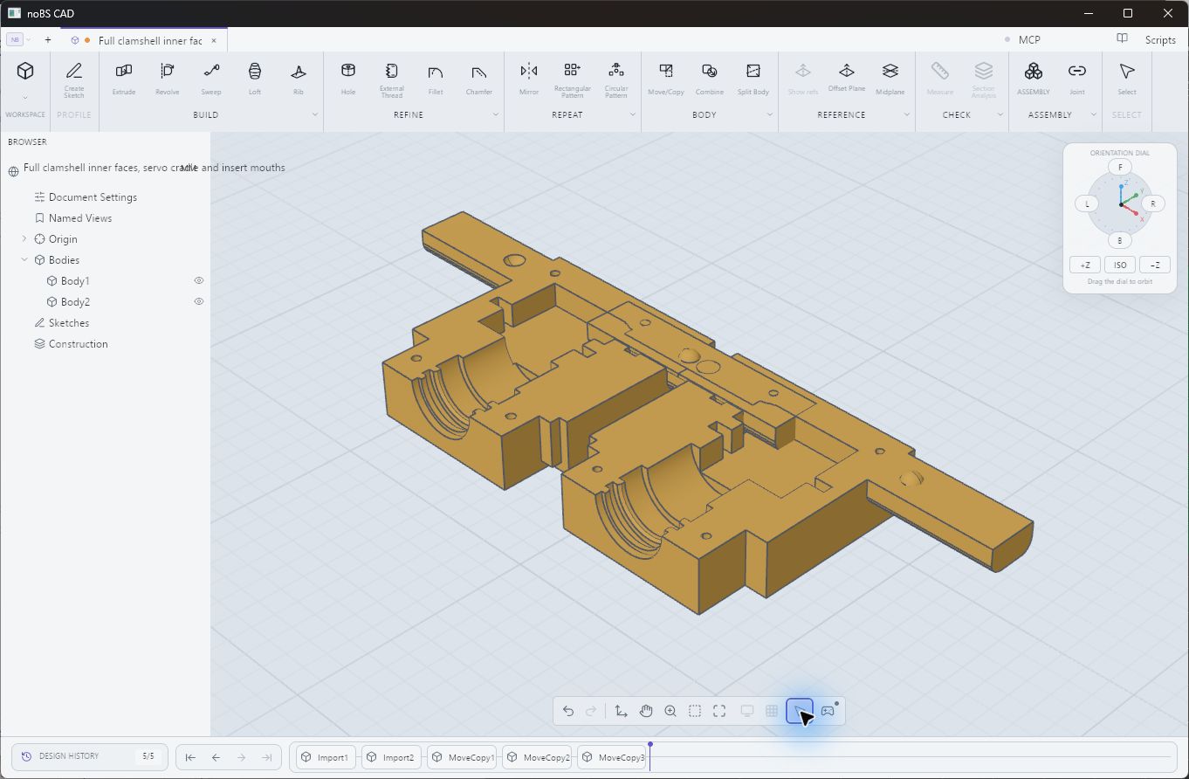
renders/cad-mating/chassis-native.png
