jeffglousher/garden-auger-technic/renders/cad-mating/contact-sheet.png

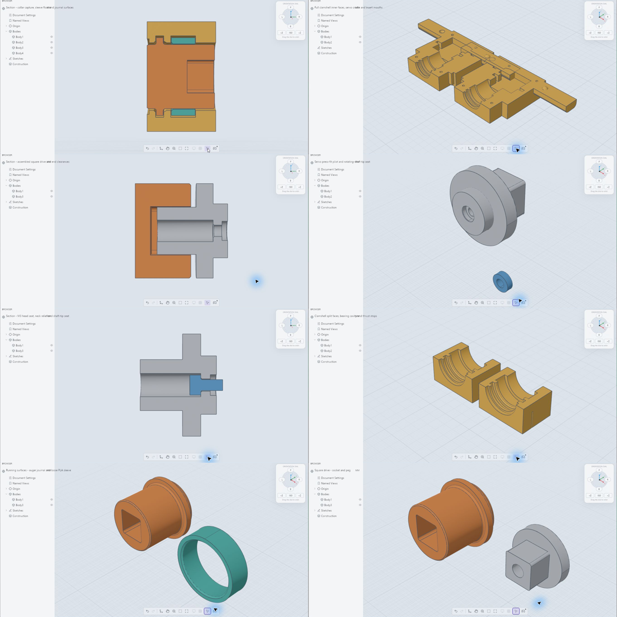
renders/cad-mating/contact-sheet.png
