jeffglousher/garden-auger-technic/renders/cad-mating/drive-native.png

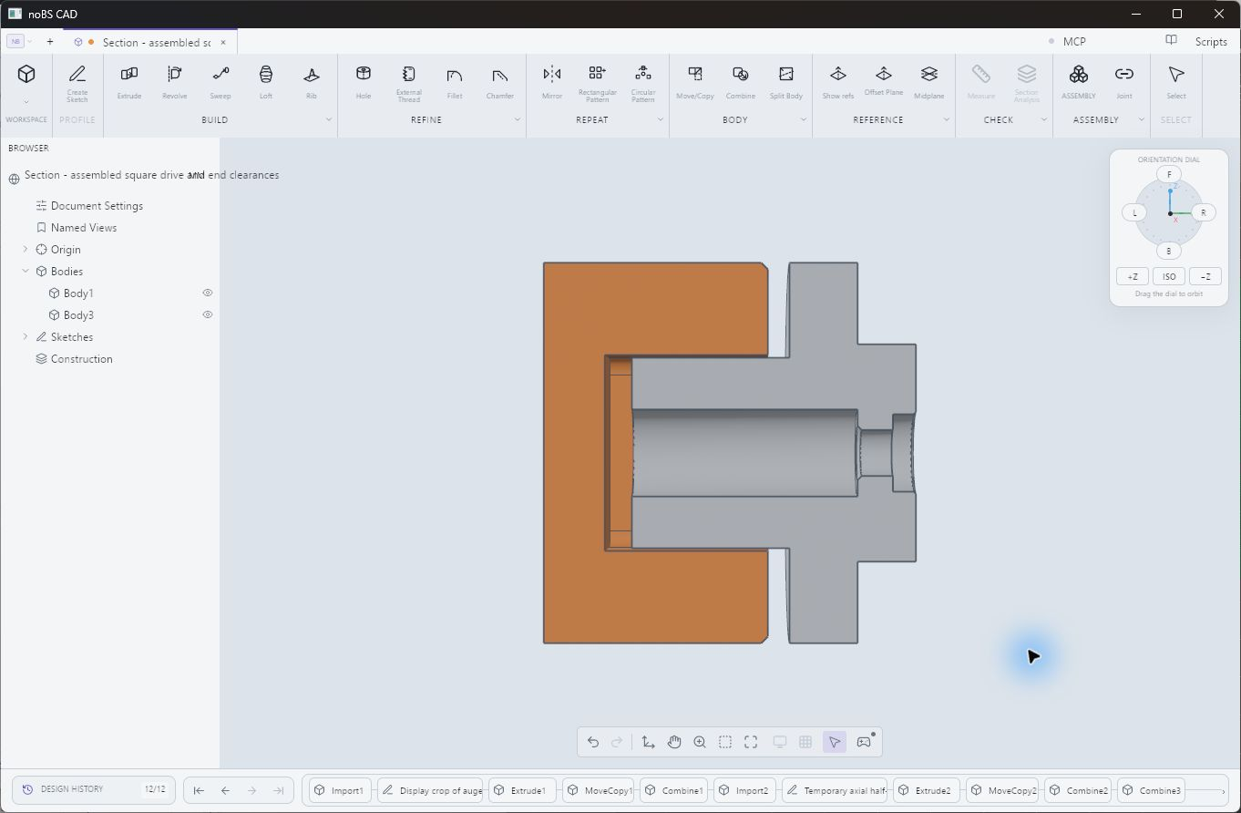
renders/cad-mating/drive-native.png
