jeffglousher/garden-auger-technic/renders/cad-mating/pilot-native.png

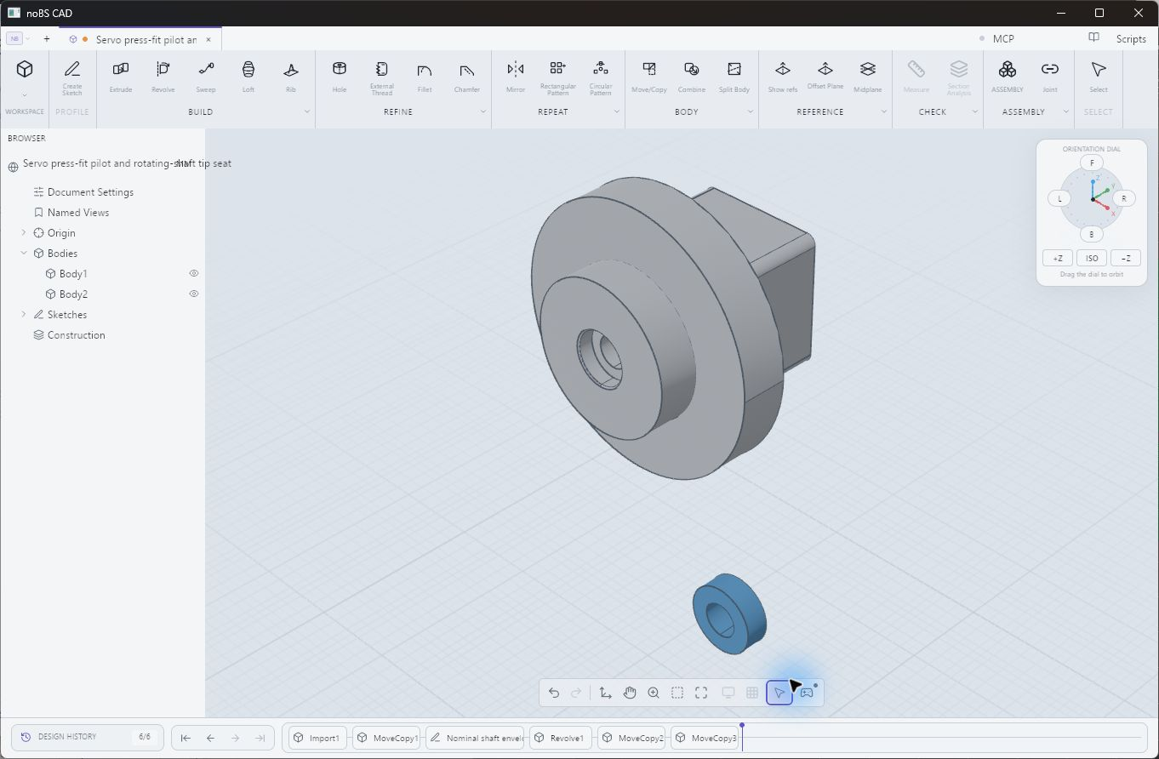
renders/cad-mating/pilot-native.png
