jeffglousher/garden-auger-technic/renders/cad-mating/screw-native.png

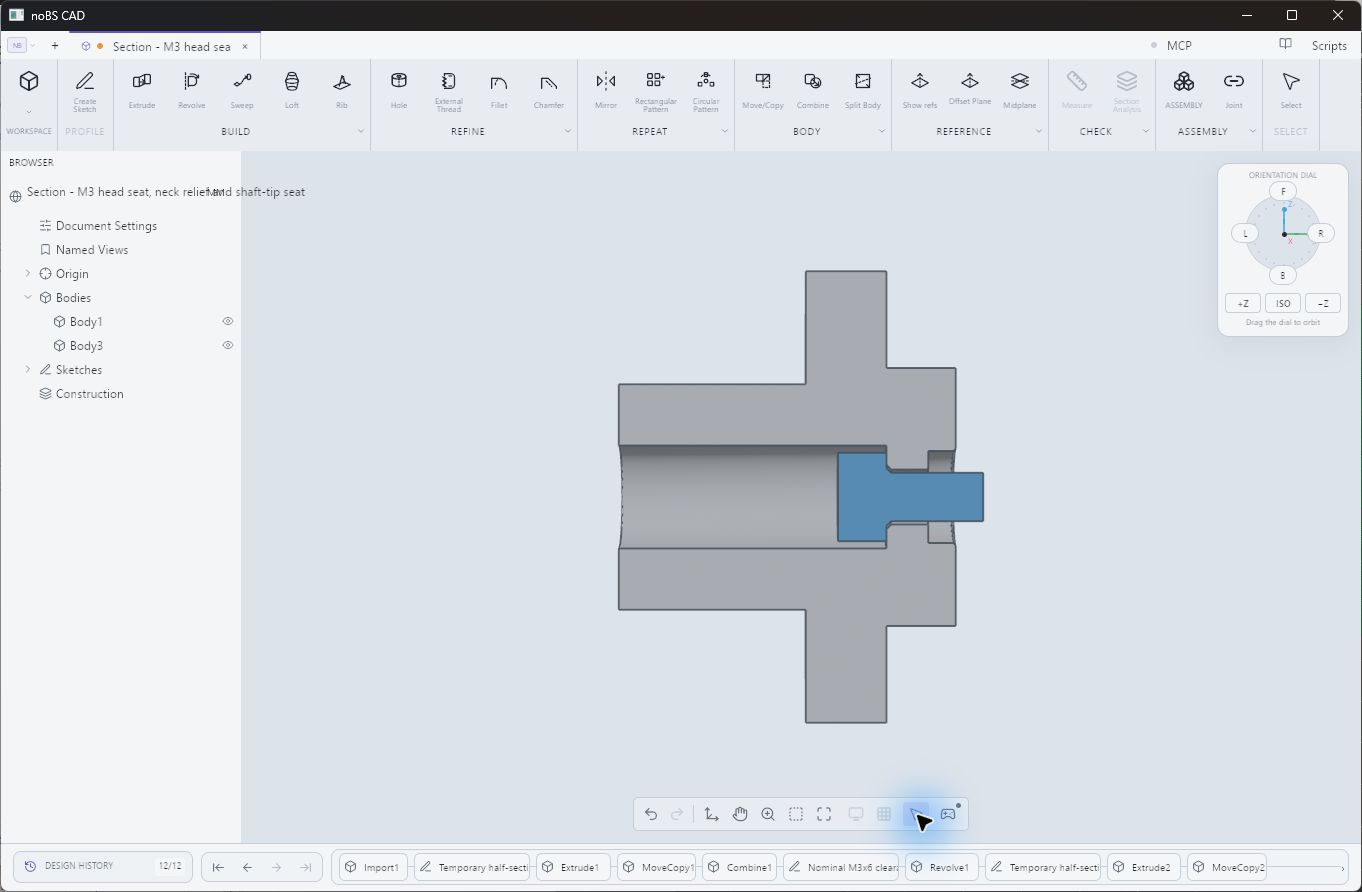
renders/cad-mating/screw-native.png
