jeffglousher/garden-auger-technic/renders/cad-mating/shells-native.png

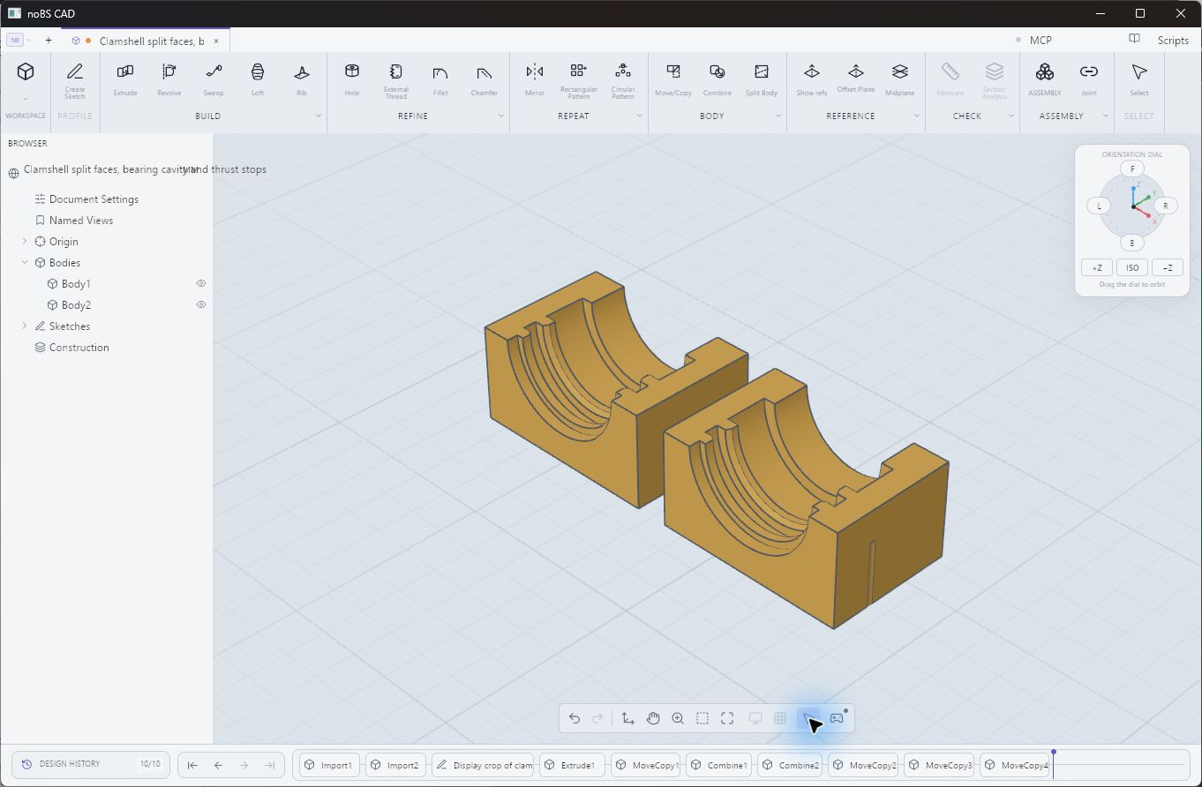
renders/cad-mating/shells-native.png
