jeffglousher/garden-auger-technic/renders/cad-mating/sleeve-native.png

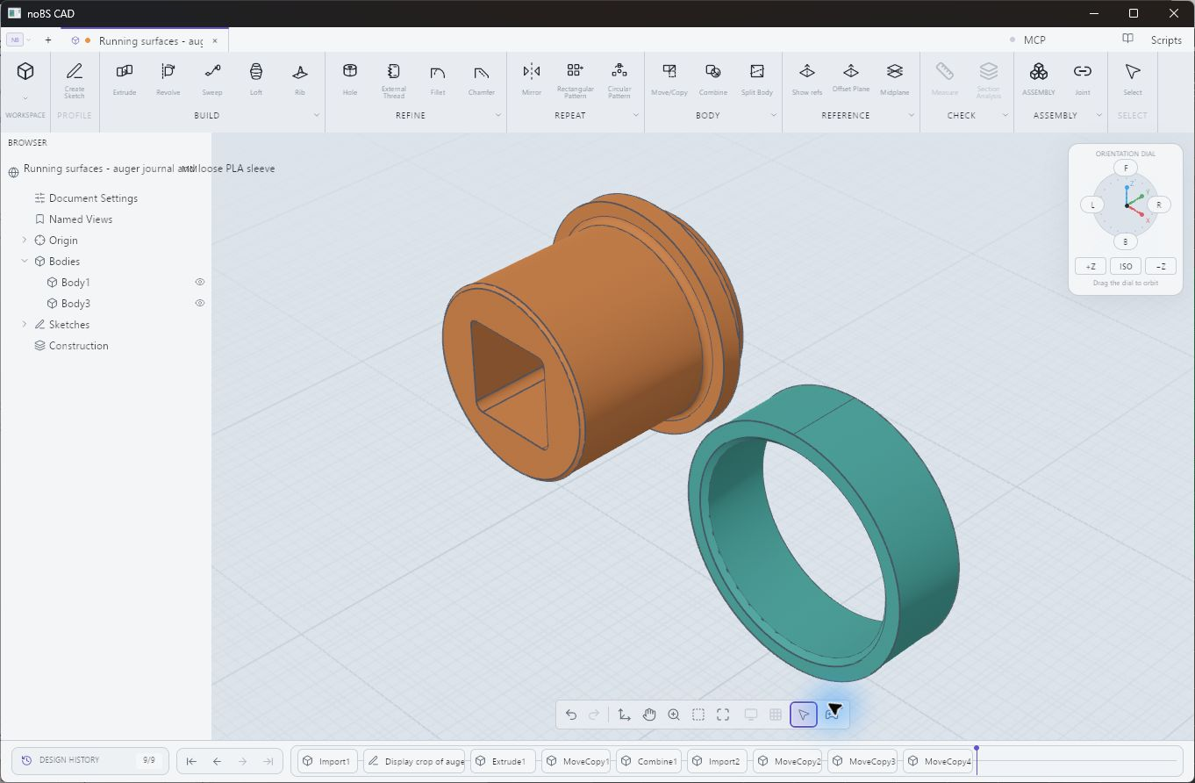
renders/cad-mating/sleeve-native.png
