jeffglousher/garden-auger-technic/renders/cad-mating/square-native.png

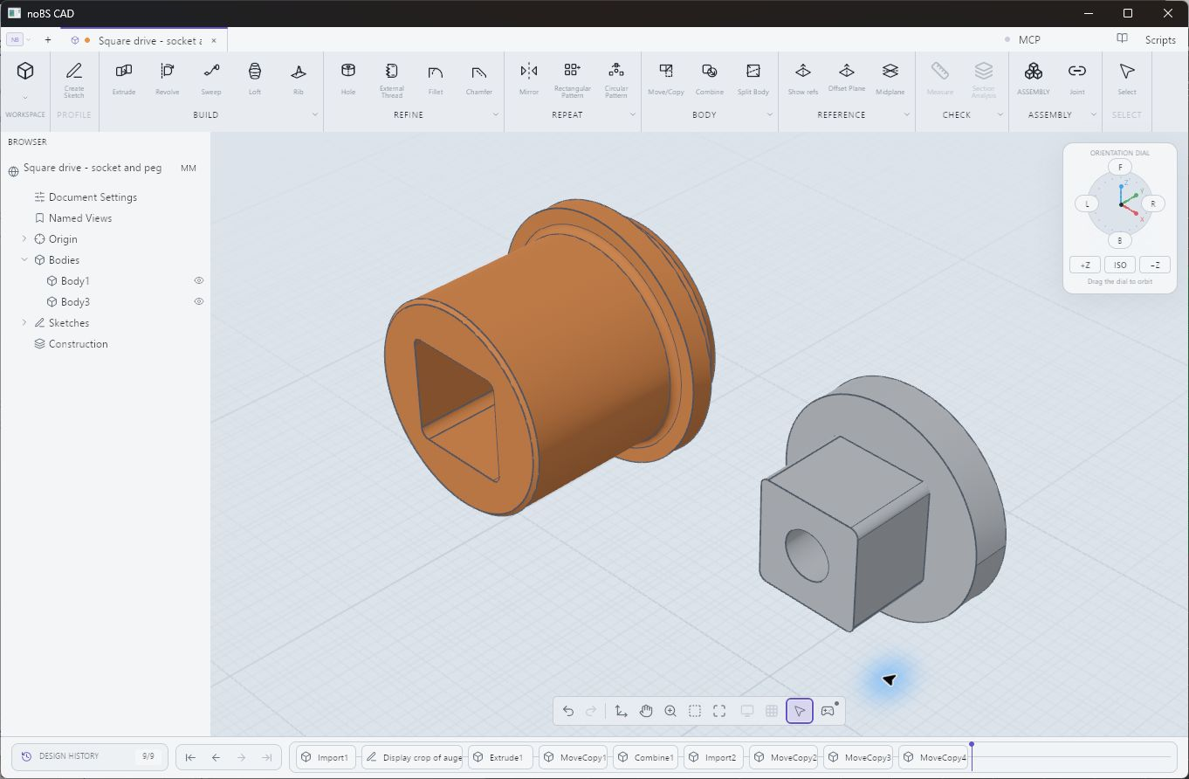
renders/cad-mating/square-native.png
