jeffglousher/garden-auger-technic/renders/cad-opened.png

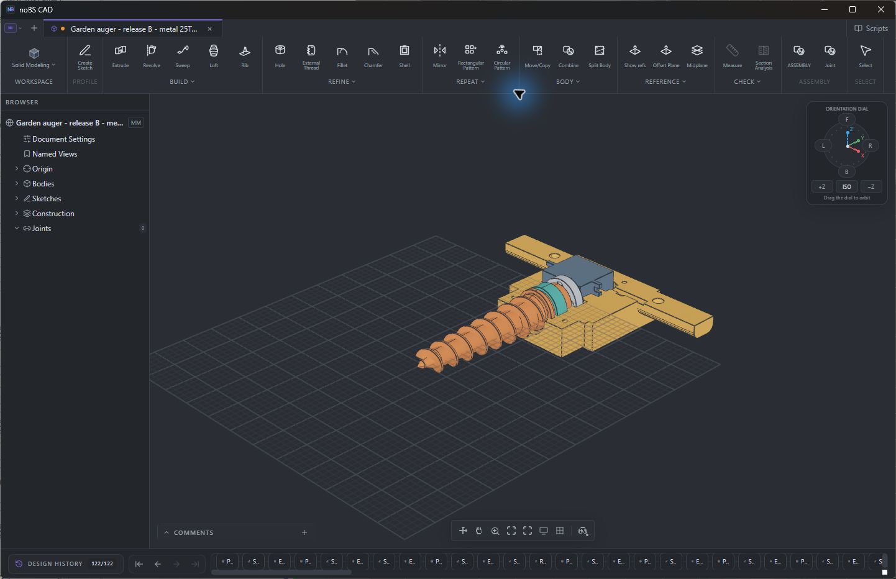
renders/cad-opened.png
