jeffglousher/garden-auger-technic/renders/cad-section.png

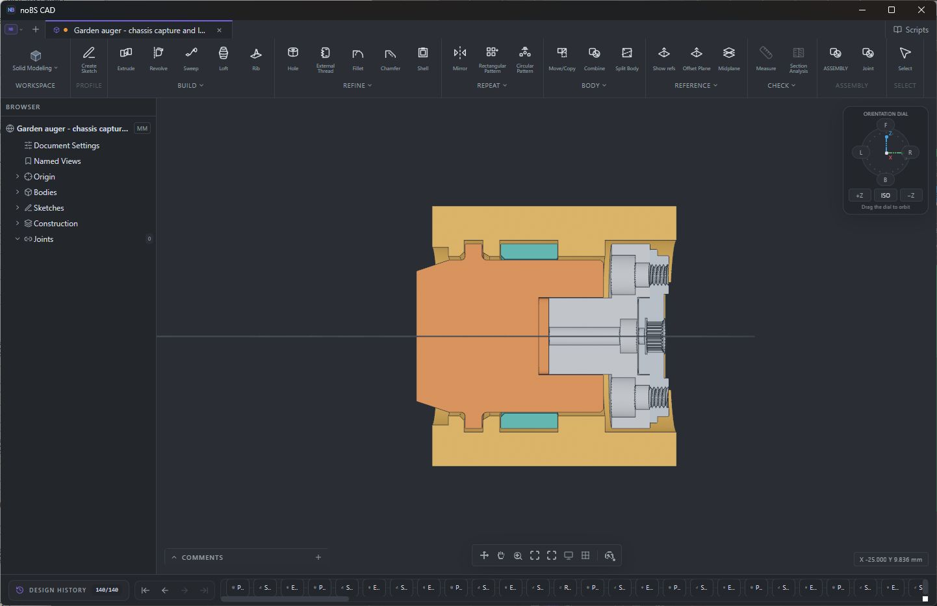
renders/cad-section.png
