jeffglousher/garden-auger-technic/renders/captured-drive-detail.png

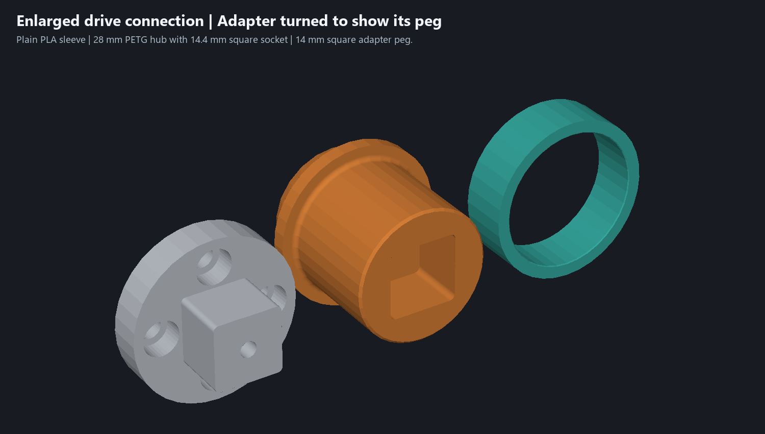
renders/captured-drive-detail.png
