jeffglousher/garden-auger-technic/renders/captured-seat.png

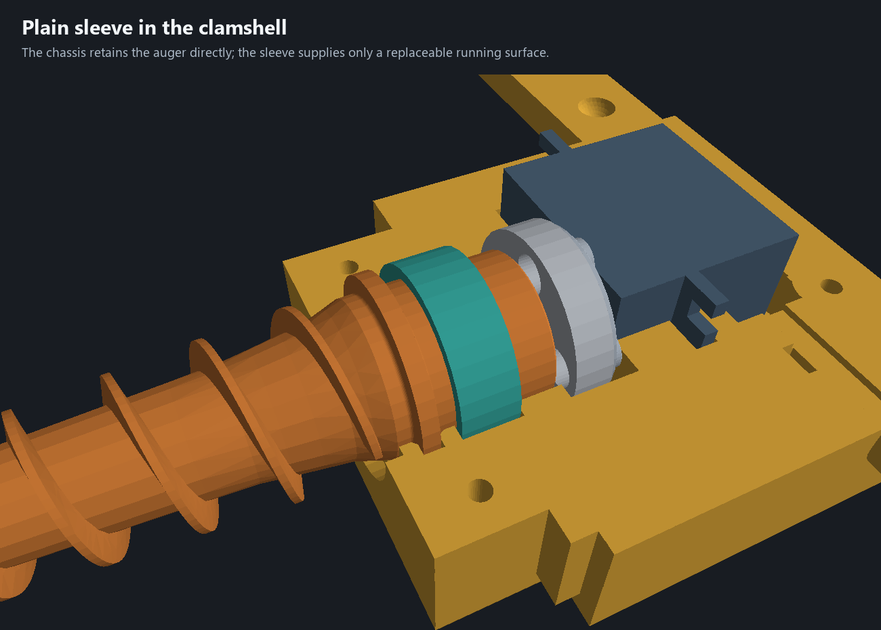
renders/captured-seat.png
