jeffglousher/garden-auger-technic/renders/clamshell-nested.png

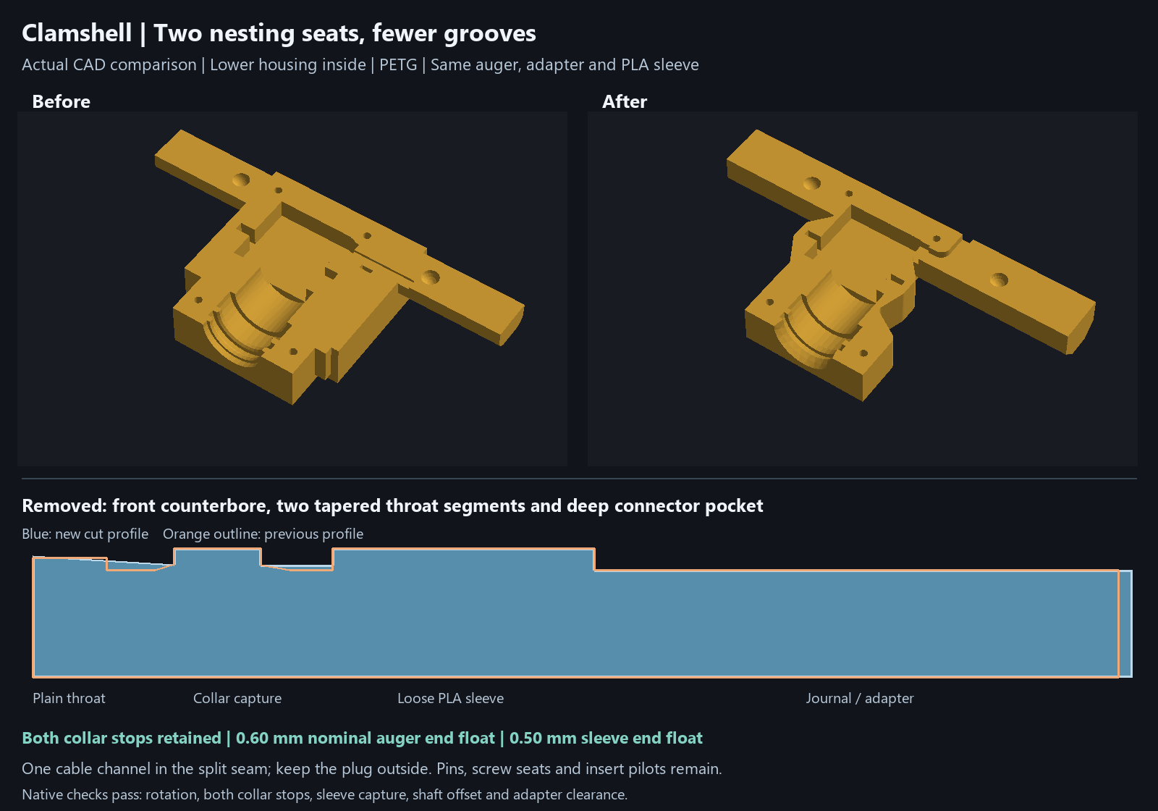
renders/clamshell-nested.png
