jeffglousher/garden-auger-technic/renders/clamshell-simplified.png

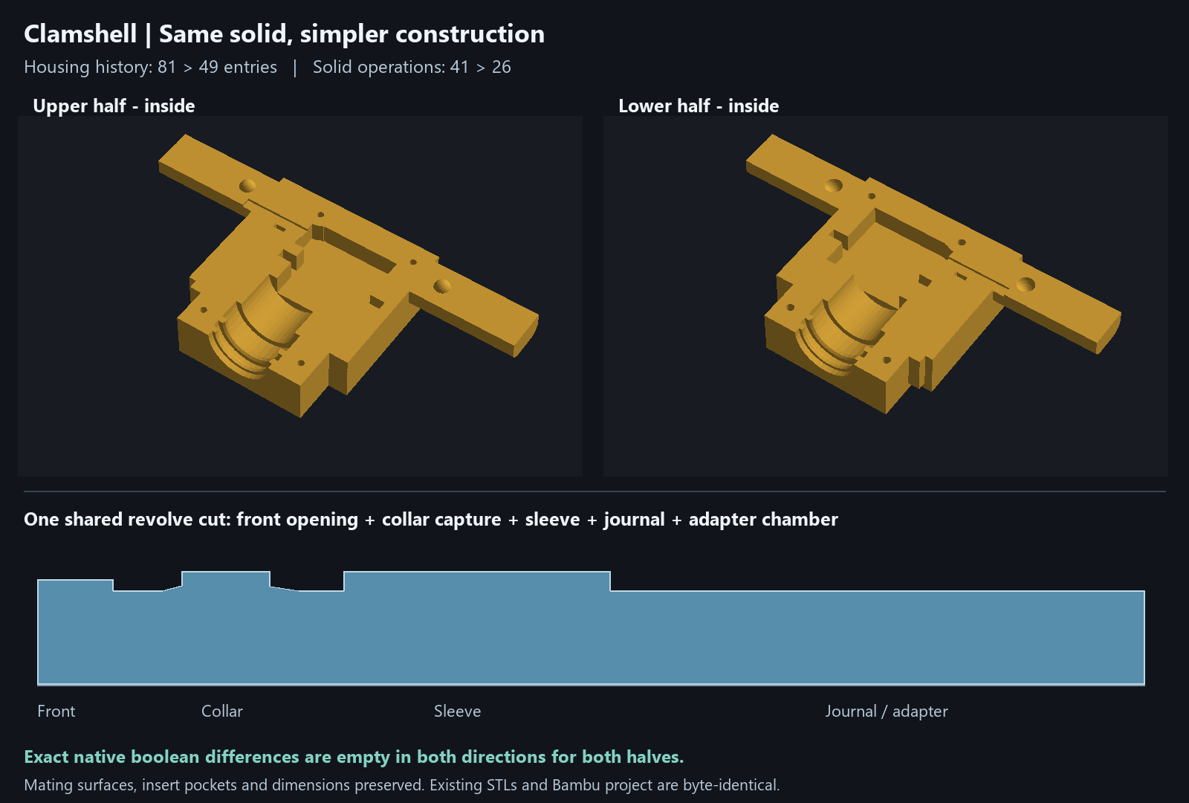
renders/clamshell-simplified.png
