jeffglousher/garden-auger-technic/renders/constraint-bushing/seated-section.png

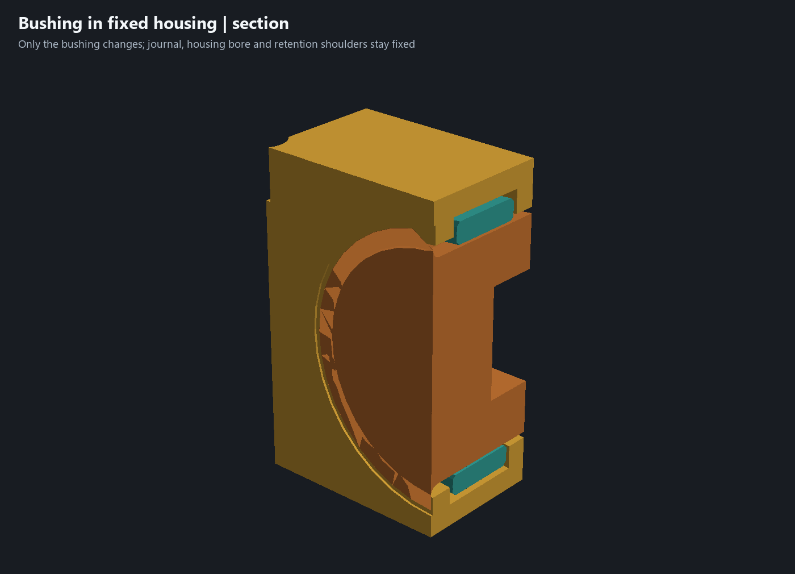
renders/constraint-bushing/seated-section.png
