jeffglousher/garden-auger-technic/renders/direct-drive-adapter.png

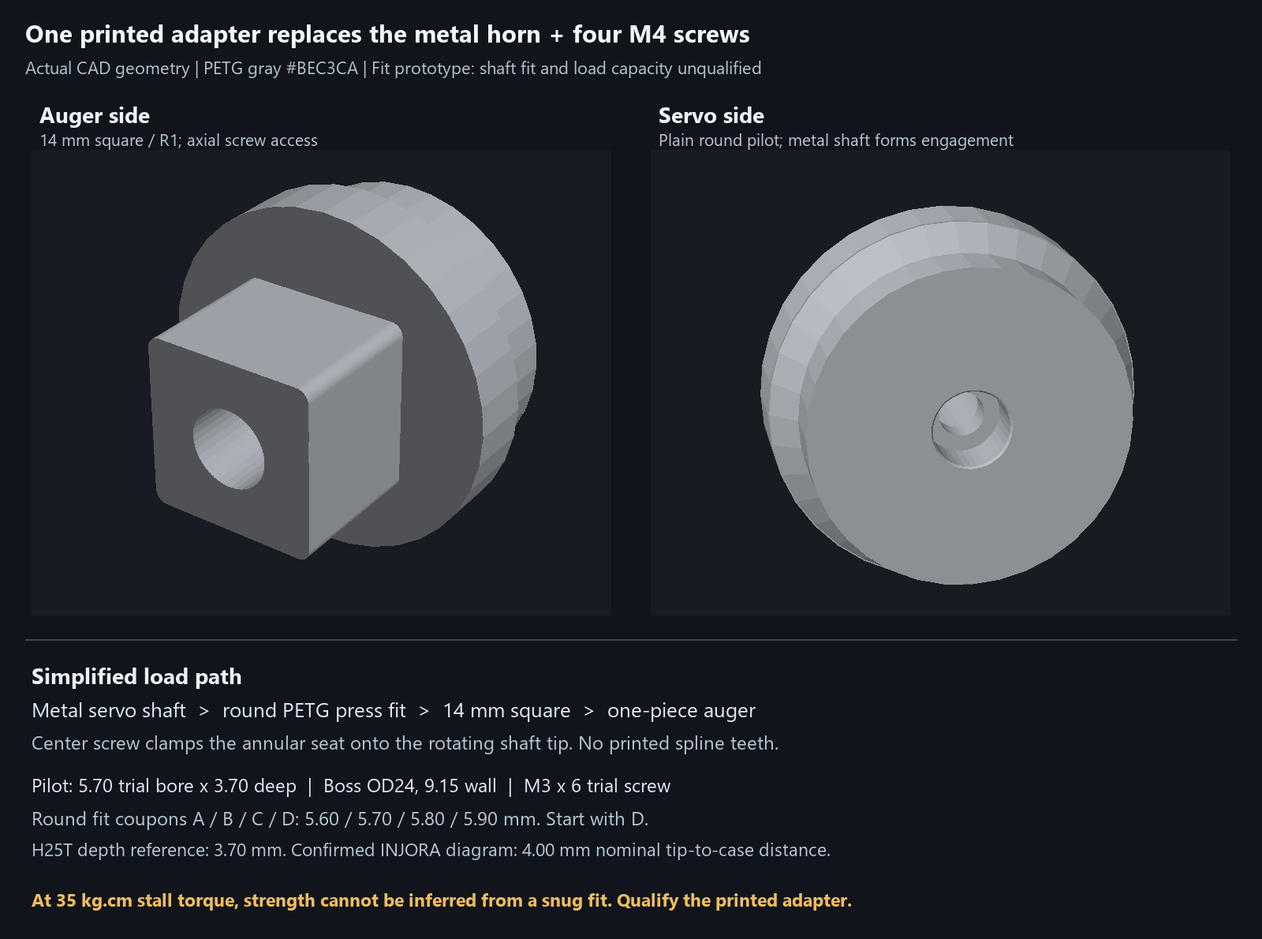
renders/direct-drive-adapter.png
