jeffglousher/garden-auger-technic/renders/direct-drive-exploded.png

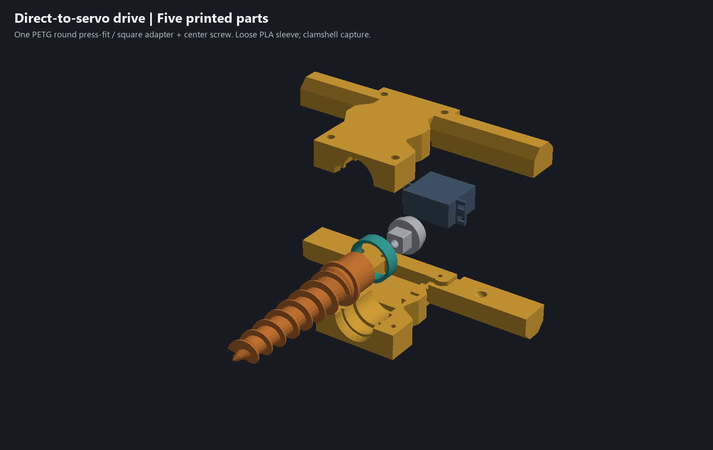
renders/direct-drive-exploded.png
