jeffglousher/garden-auger-technic/renders/direct-drive-screw-check.png

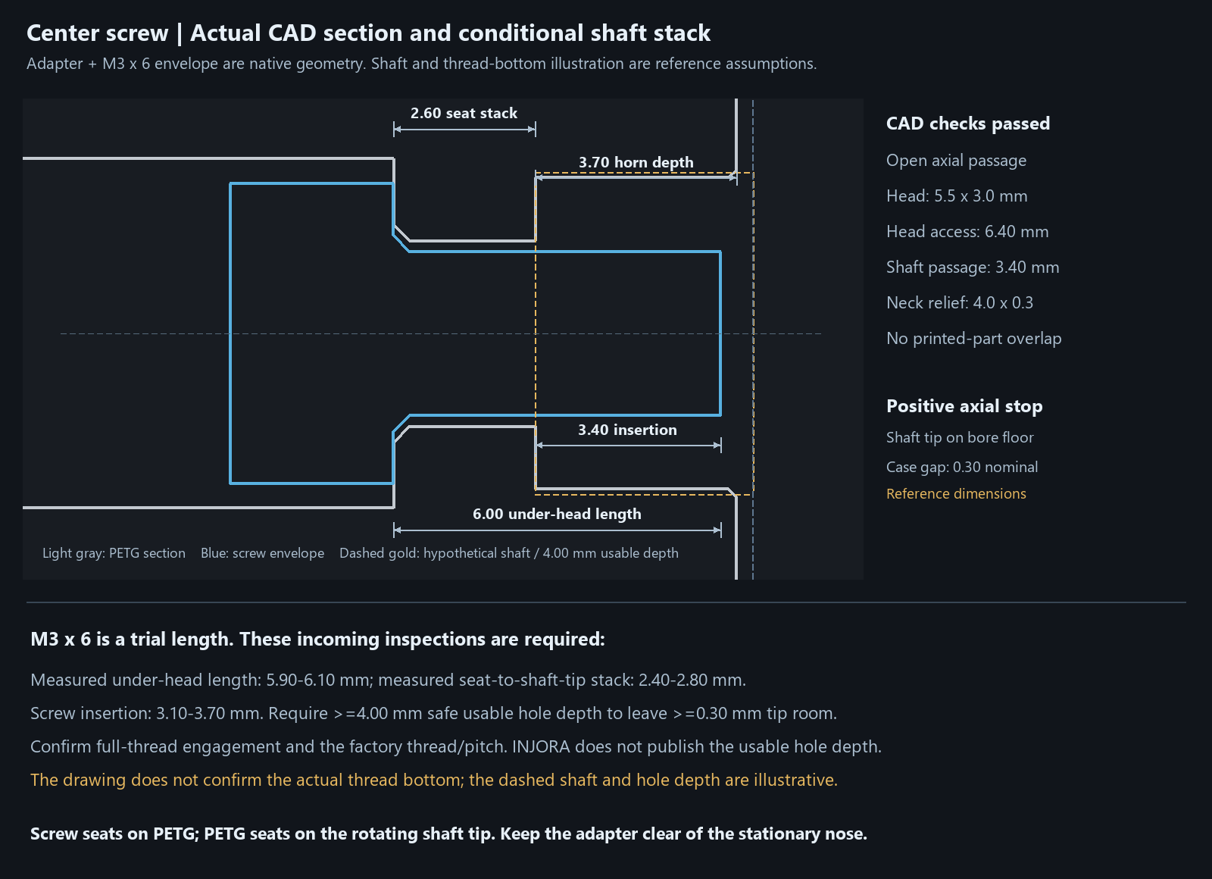
renders/direct-drive-screw-check.png
