jeffglousher/garden-auger-technic/renders/labeled/plate-1.png

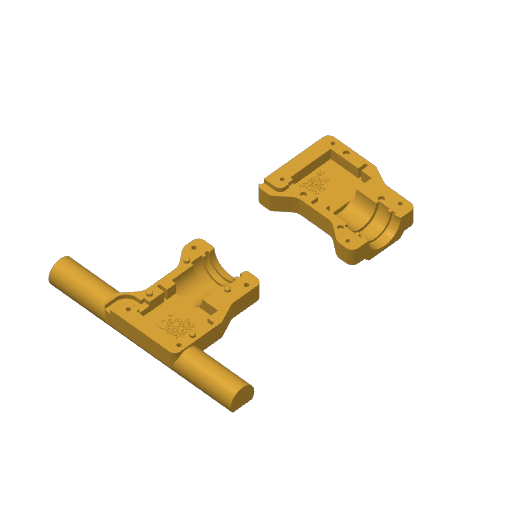
renders/labeled/plate-1.png
