jeffglousher/garden-auger-technic/renders/middle-review/adapter.png

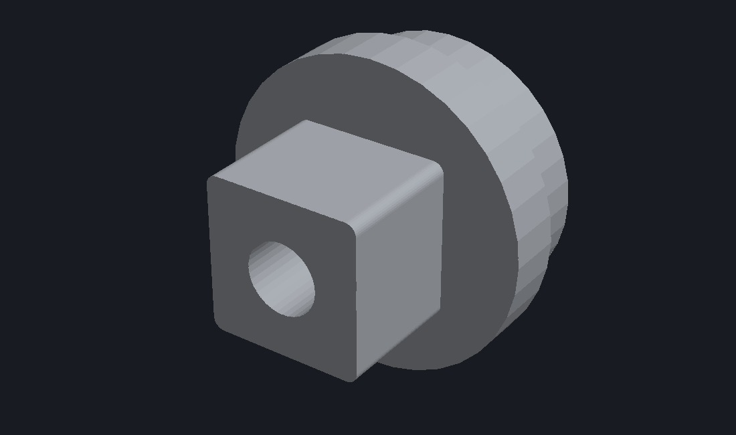
renders/middle-review/adapter.png
