jeffglousher/garden-auger-technic/renders/middle-review/auger.png

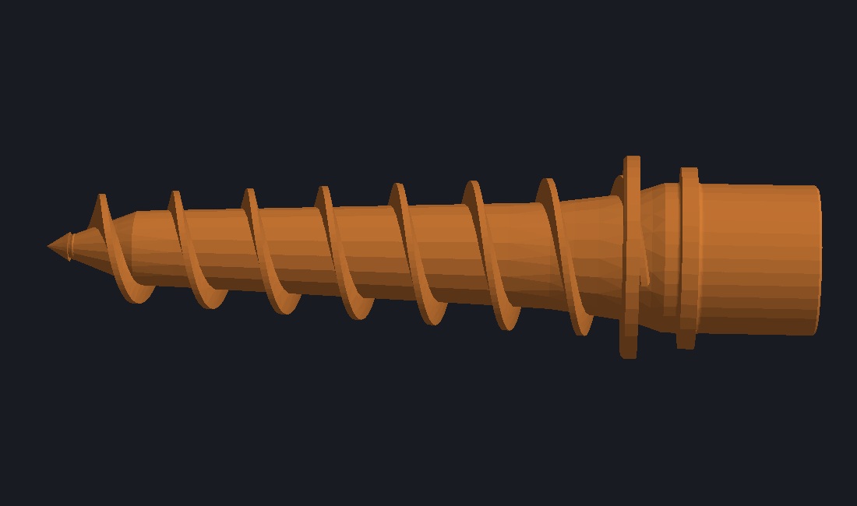
renders/middle-review/auger.png
