jeffglousher/garden-auger-technic/renders/middle-review/bushing.png

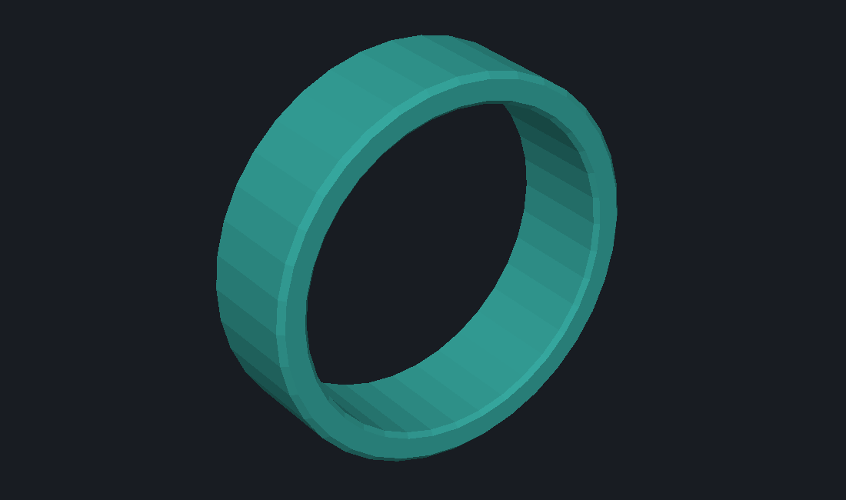
renders/middle-review/bushing.png
