jeffglousher/garden-auger-technic/renders/middle-review/cutaway.png

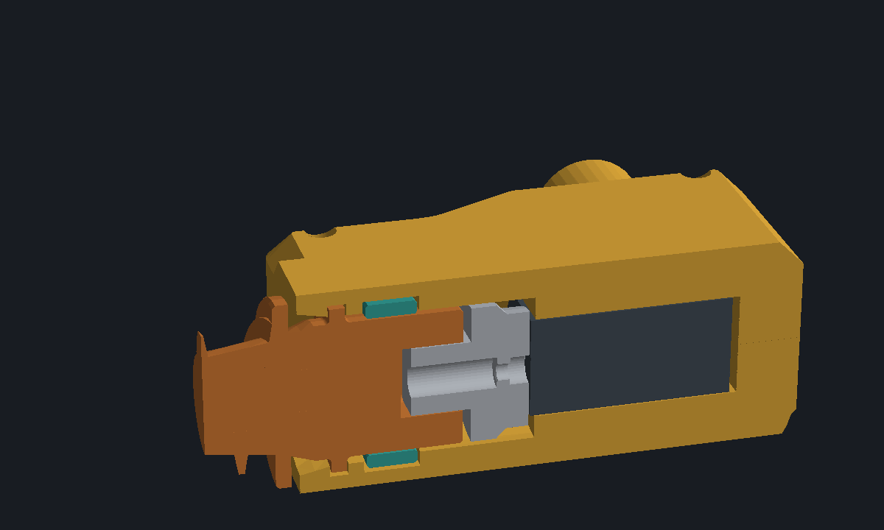
renders/middle-review/cutaway.png
