jeffglousher/garden-auger-technic/renders/middle-review/exploded.png

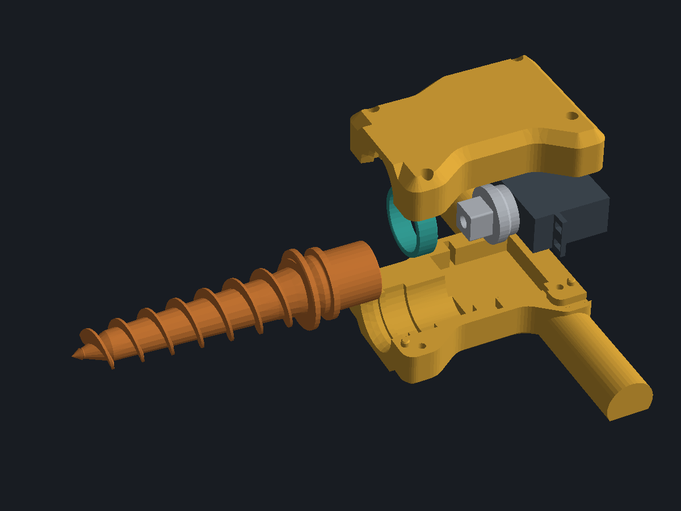
renders/middle-review/exploded.png
