jeffglousher/garden-auger-technic/renders/middle-review/servo-reference.png

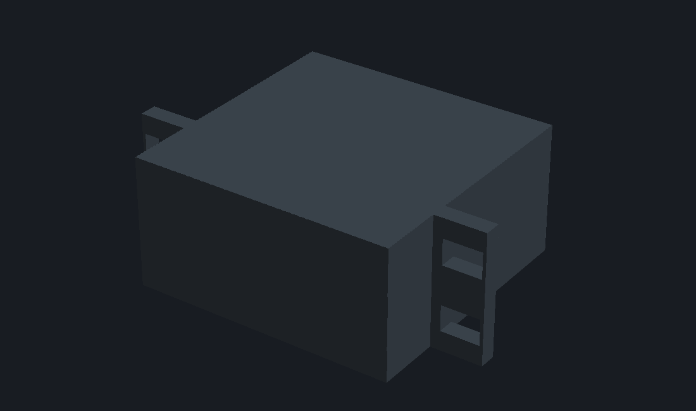
renders/middle-review/servo-reference.png
