jeffglousher/garden-auger-technic/renders/rounded-housing/locators.png

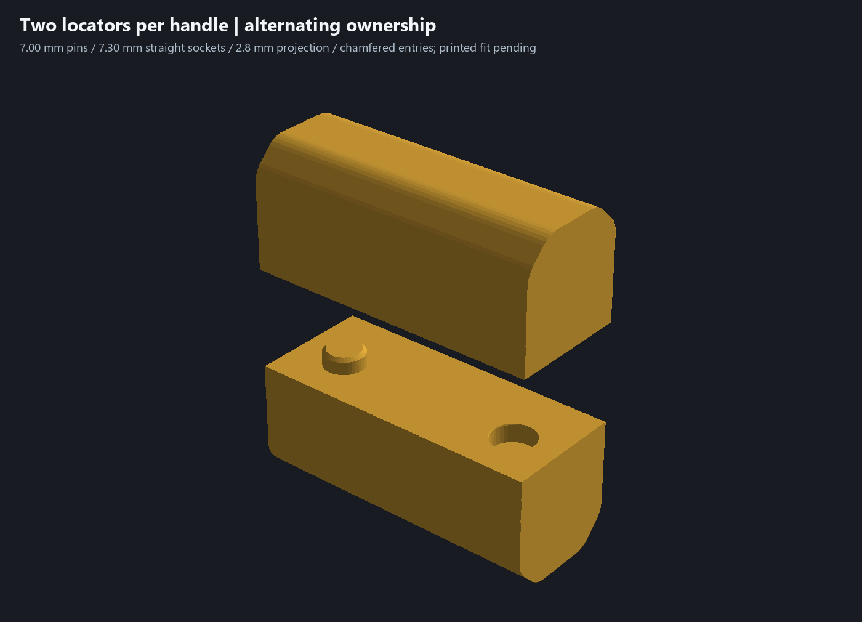
renders/rounded-housing/locators.png
