jeffglousher/garden-auger-technic/renders/servo-caliper-request-20261007.png

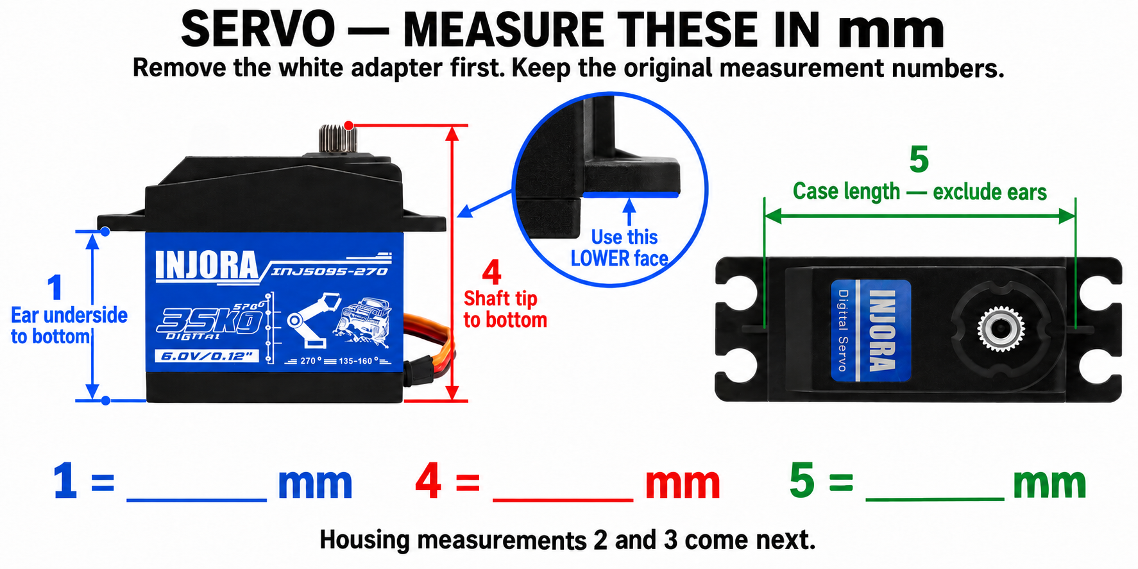
renders/servo-caliper-request-20261007.png
