jeffglousher/garden-auger-technic/renders/square-mating-dimensions.png

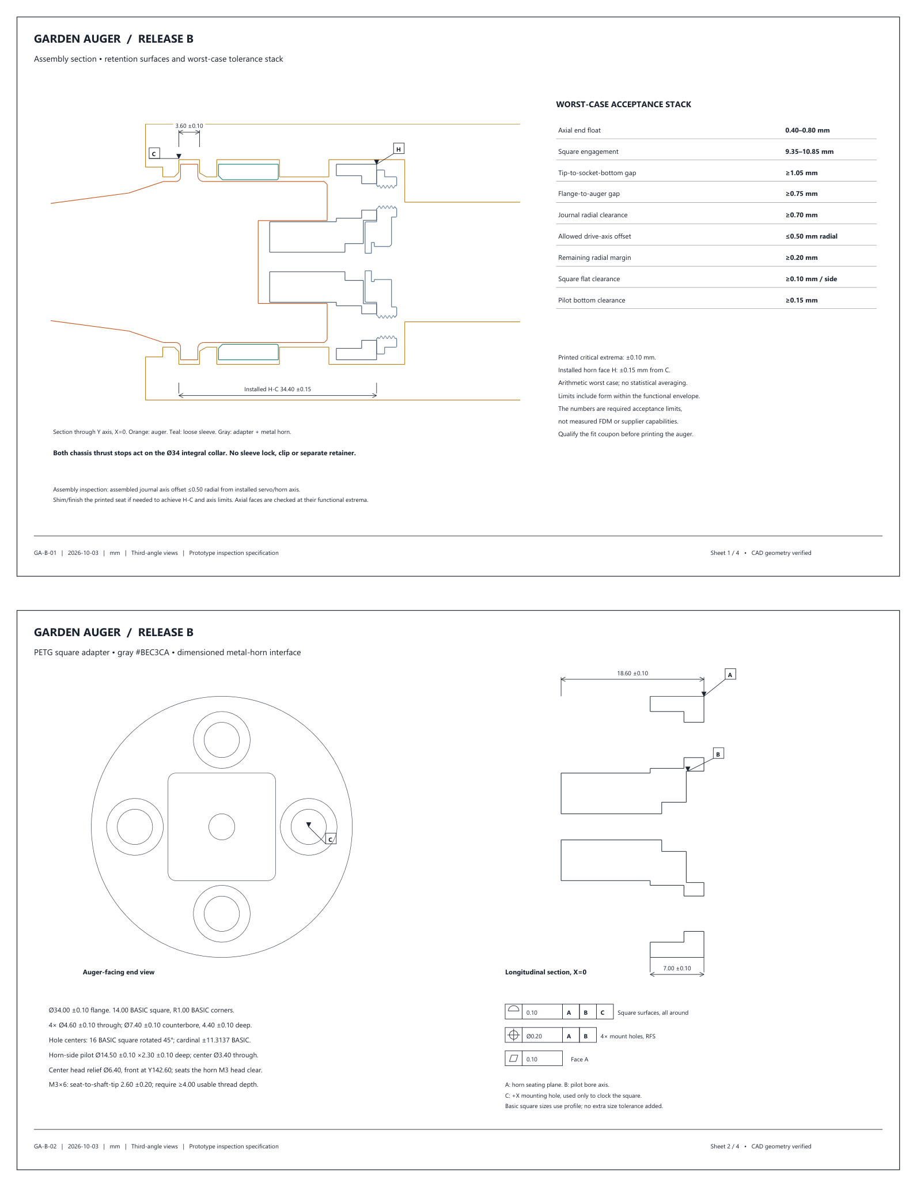
renders/square-mating-dimensions.png
