jeffglousher/garden-auger-technic/source/references/injora-injs035-360-dimensions.jpg

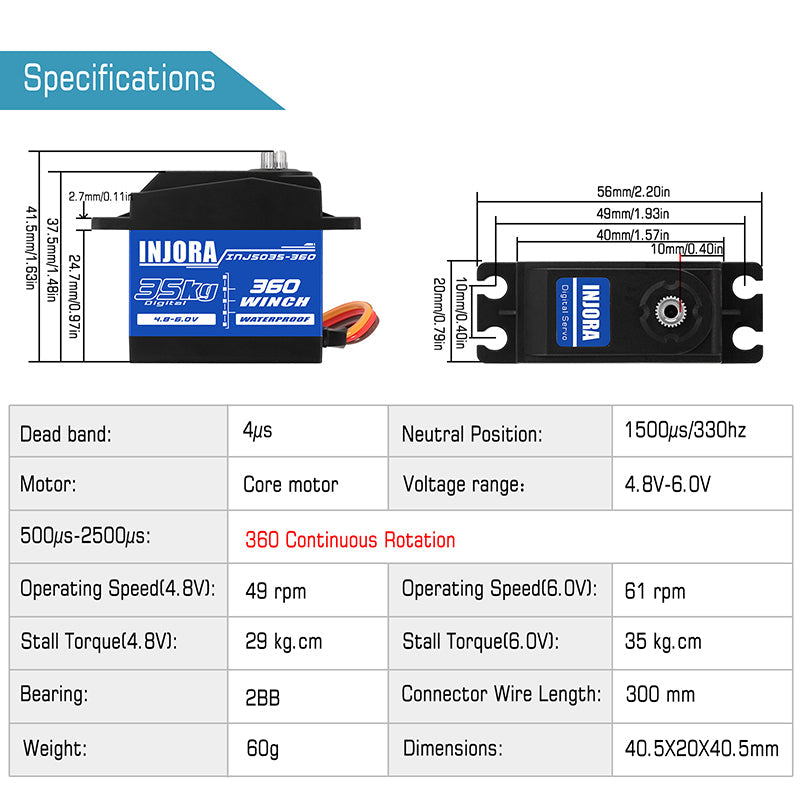
source/references/injora-injs035-360-dimensions.jpg
