jeffglousher/garden-auger-technic/source/references/user-servo-fit-diagram.png

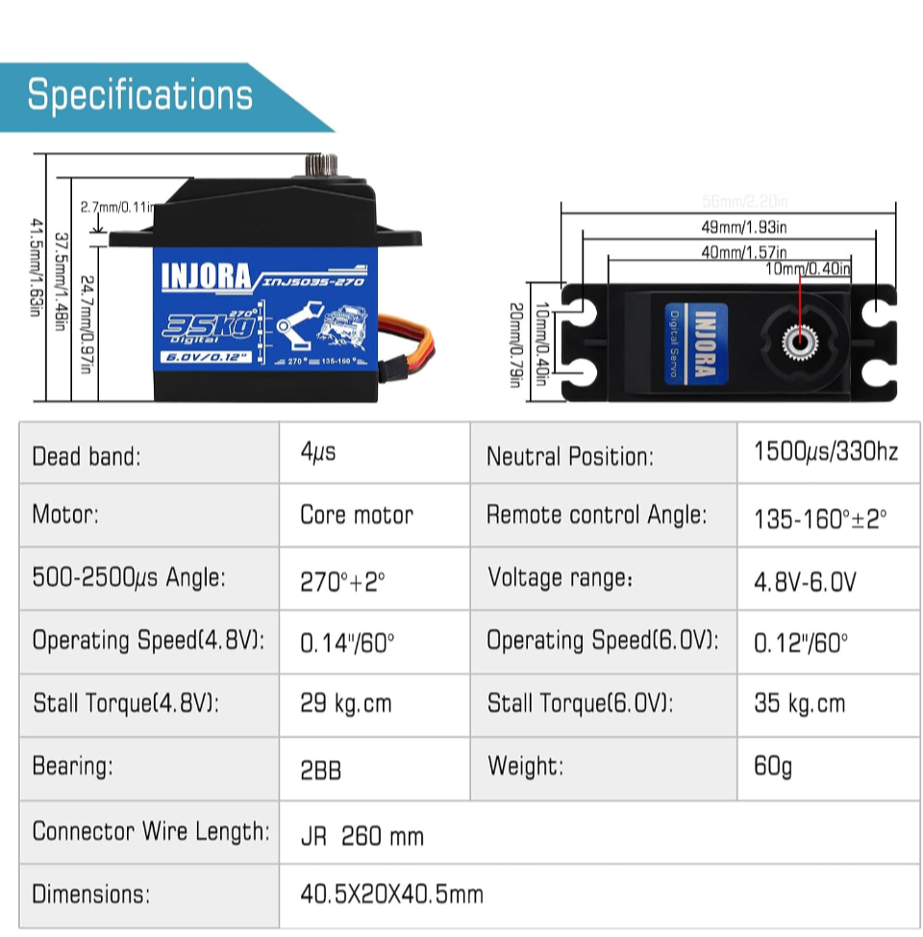
source/references/user-servo-fit-diagram.png
