jeffglousher/garden-auger-technic/renders/auger-all-parts.png

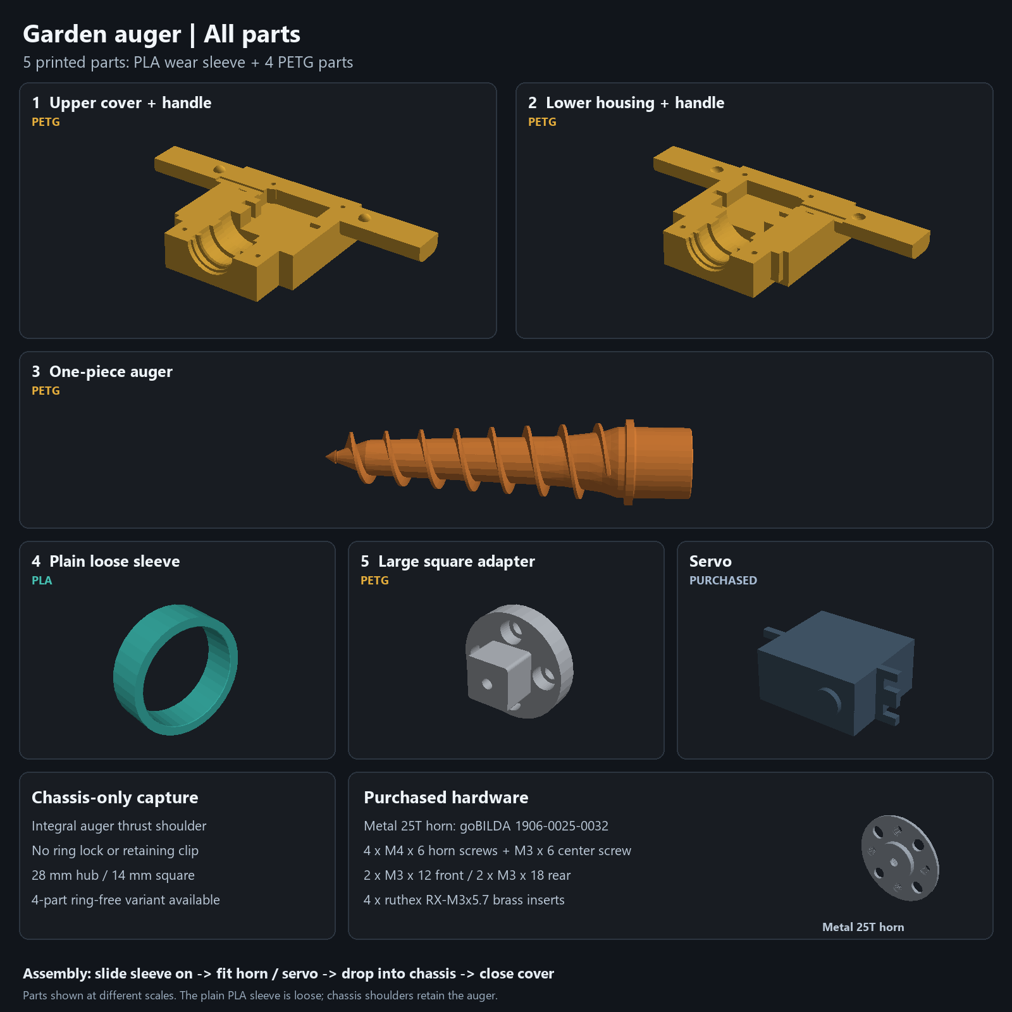
renders/auger-all-parts.png
