jeffglousher/garden-auger-technic/garden-auger-local-strength-assembly.3mf

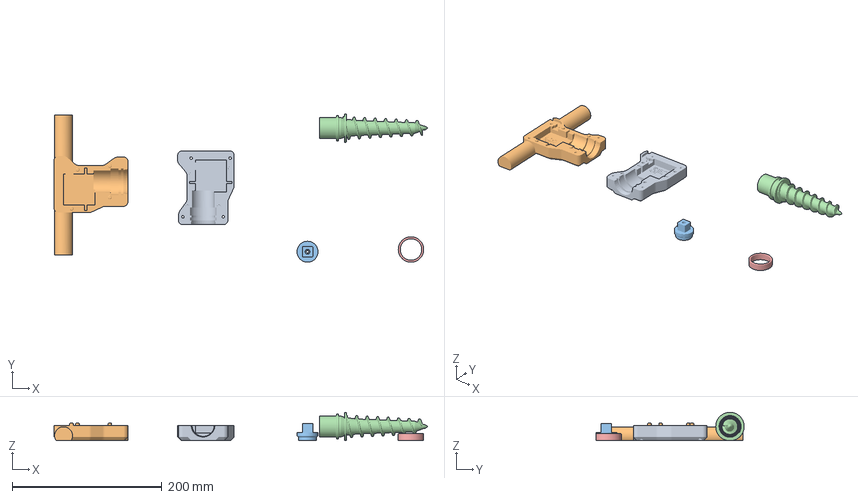
[picture p71: CAD file, 2026-11-05]
garden-auger-local-strength-assembly.3mf
498.9 x 198.0 x 38.0 mm
PETG - Housing upper
PETG - Housing lower
PETG - Square adapter
PETG - One-piece auger
PLA - Constraint-fit bushing
