jeffglousher/garden-auger-technic/print-parts/pla-full-wear-sleeve.stl

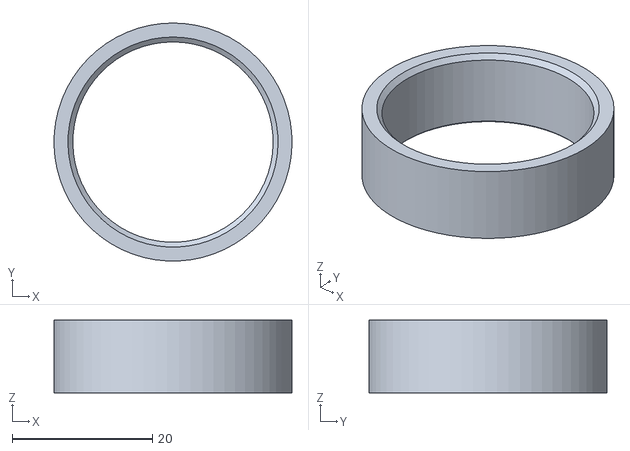
[picture p72: CAD file, 2026-10-04]
print-parts/pla-full-wear-sleeve.stl
34.0 x 34.0 x 10.4
