jeffglousher/garden-auger-technic/garden-auger-ingress-flange-assembly.3mf

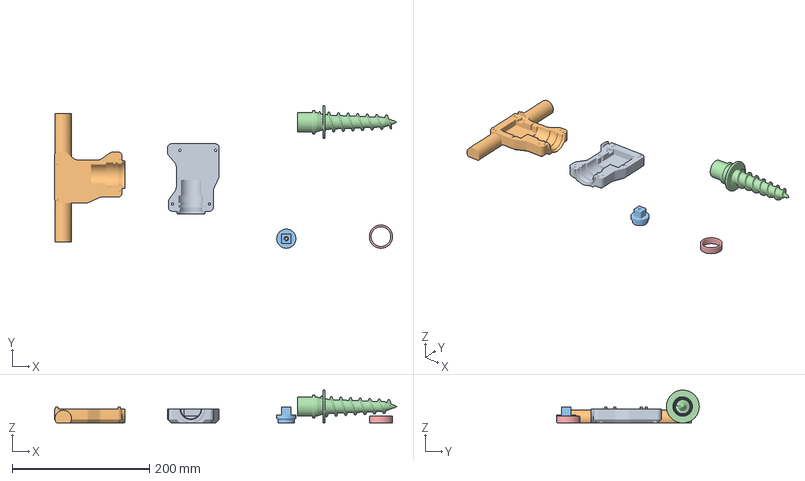
[picture p73: CAD file, 2026-10-30]
garden-auger-ingress-flange-assembly.3mf
498.9 x 208.0 x 48.0 mm
PETG - Housing upper
PETG - Housing lower
PETG - Square adapter
PETG - One-piece auger
PLA - Constraint-fit bushing
