jeffglousher/garden-auger-technic/garden-auger-chamfer-envelope-assembly.3mf

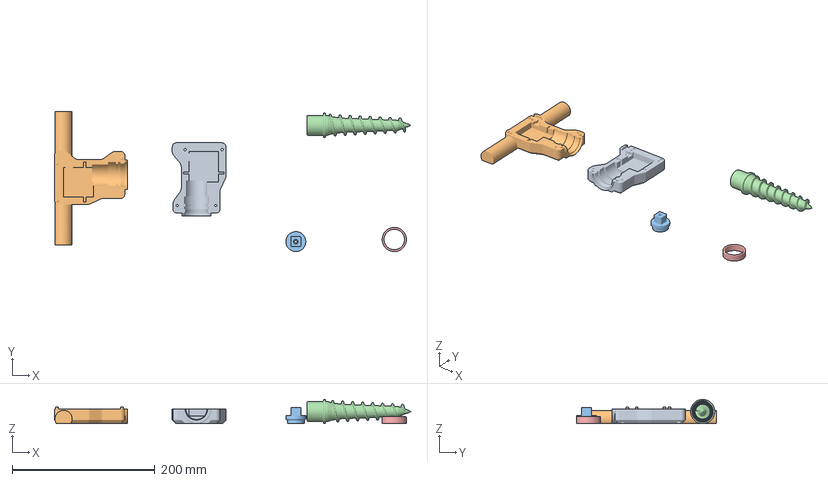
[picture p74: CAD file, 2026-10-30]
garden-auger-chamfer-envelope-assembly.3mf
498.9 x 196.5 x 34.0 mm
PETG - Housing upper
PETG - Housing lower
PETG - Square adapter
PETG - One-piece auger
PLA - Constraint-fit bushing
