jeffglousher/garden-auger-technic/garden-auger-child-d-grip-assembly.3mf

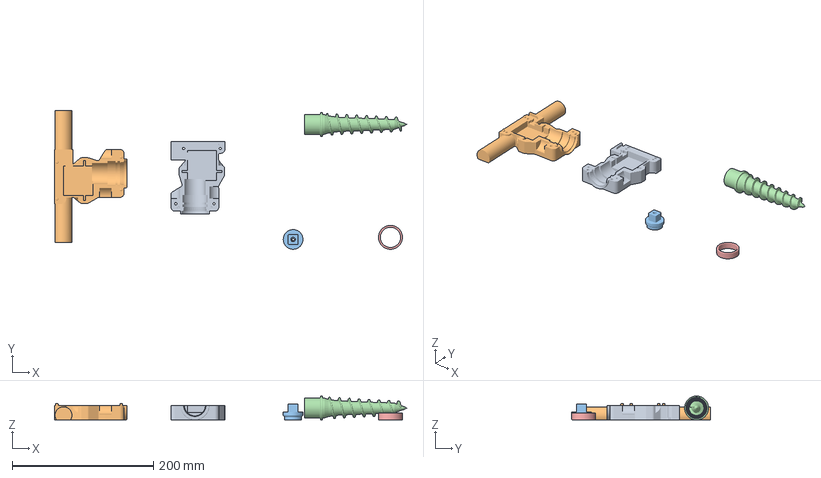
[picture p75: CAD file, 2026-10-18]
garden-auger-child-d-grip-assembly.3mf
498.9 x 196.5 x 34.0 mm
PETG - Housing upper
PETG - Housing lower
PETG - Square adapter
PETG - One-piece auger
PLA - Constraint-fit bushing
