jeffglousher/garden-auger-technic/garden-auger-two-plate-assembly.3mf

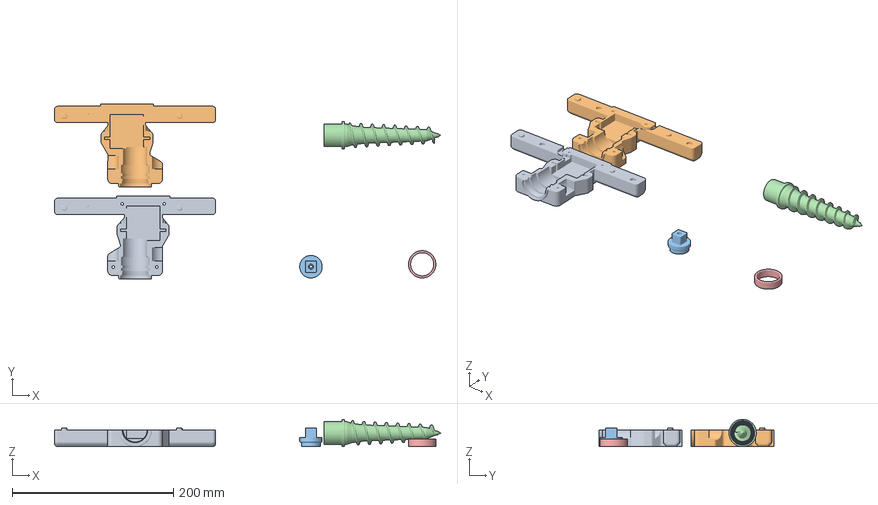
[picture p76: CAD file, 2026-10-18]
garden-auger-two-plate-assembly.3mf
478.9 x 216.6 x 34.0 mm
PETG - Housing upper
PETG - Housing lower
PETG - Square adapter
PETG - One-piece auger
PLA - Constraint-fit bushing
