jeffglousher/garden-auger-technic/print-parts/chamfer-envelope-assembly/petg-housing-lower.stl

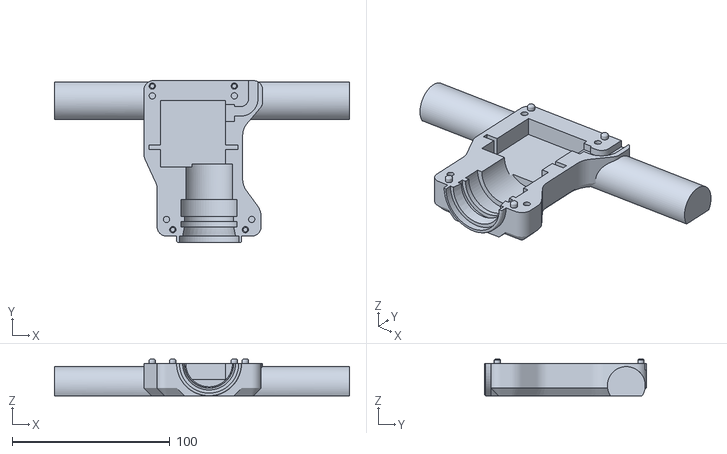
[picture p77: CAD file, 2026-10-30]
print-parts/chamfer-envelope-assembly/petg-housing-lower.stl
187.0 x 102.6 x 23.4
