jeffglousher/garden-auger-technic/print-parts/current-assembly/petg-housing-upper.stl

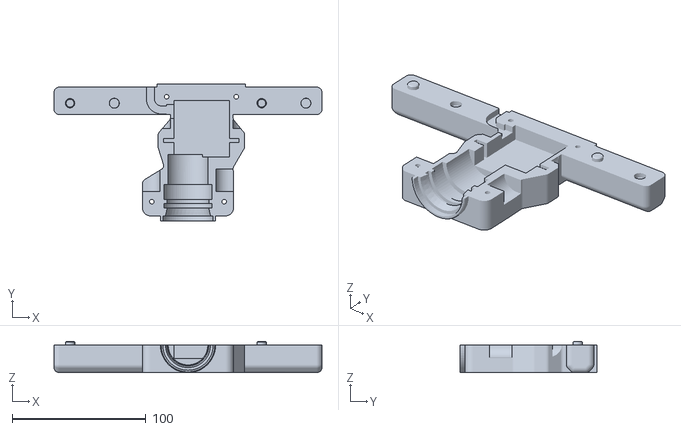
[picture p78: CAD file, 2026-10-16]
print-parts/current-assembly/petg-housing-upper.stl
200.0 x 102.6 x 23.4
