jeffglousher/garden-auger-technic/print-parts/direct-drive/petg-housing-lower.stl

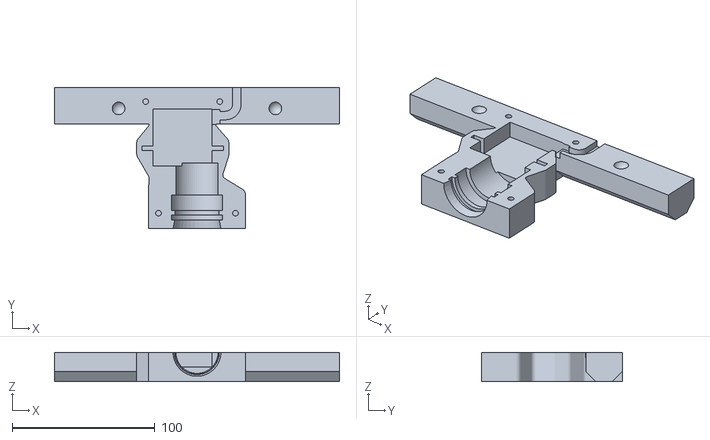
[picture p79: CAD file, 2026-10-06]
print-parts/direct-drive/petg-housing-lower.stl
200.0 x 98.6 x 20.6
