jeffglousher/garden-auger-technic/print-parts/ingress-flange-assembly/petg-one-piece-auger.stl

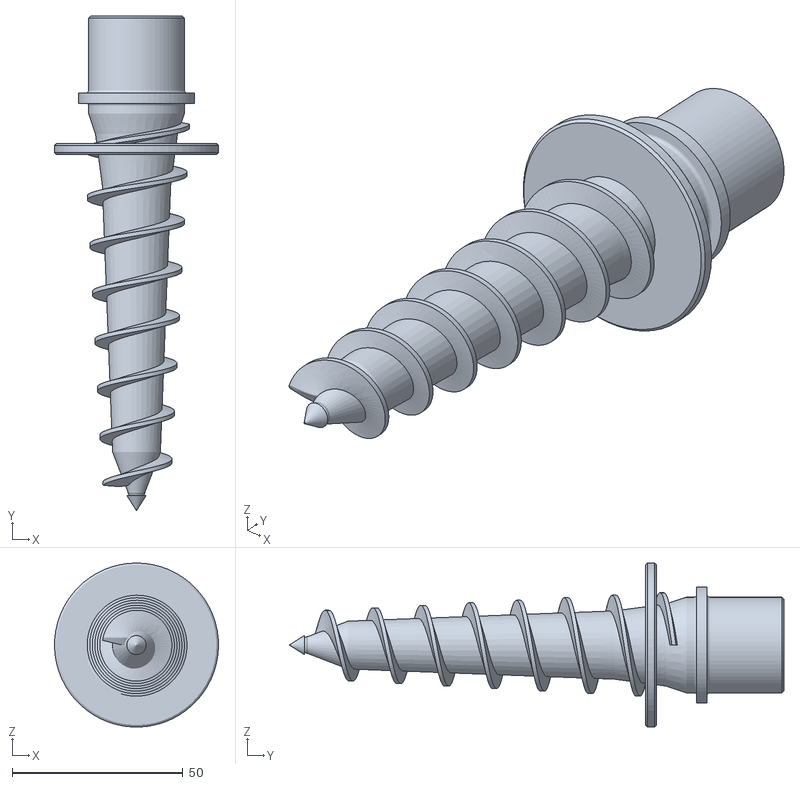
[picture p80: CAD file, 2026-10-30]
print-parts/ingress-flange-assembly/petg-one-piece-auger.stl
48.0 x 144.7 x 48.0
