jeffglousher/garden-auger-technic/print-parts/labeled-assembly/petg-housing-upper.stl

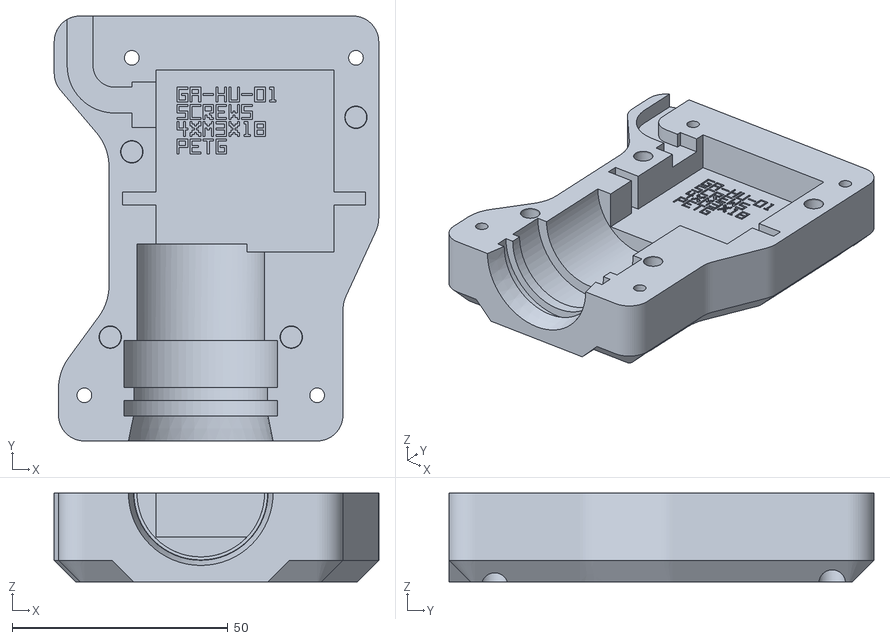
[picture p81: CAD file, 2026-11-04]
print-parts/labeled-assembly/petg-housing-upper.stl
75.3 x 98.6 x 20.6
