jeffglousher/garden-auger-technic/print-parts/locator-fit-assembly/petg-housing-lower.stl

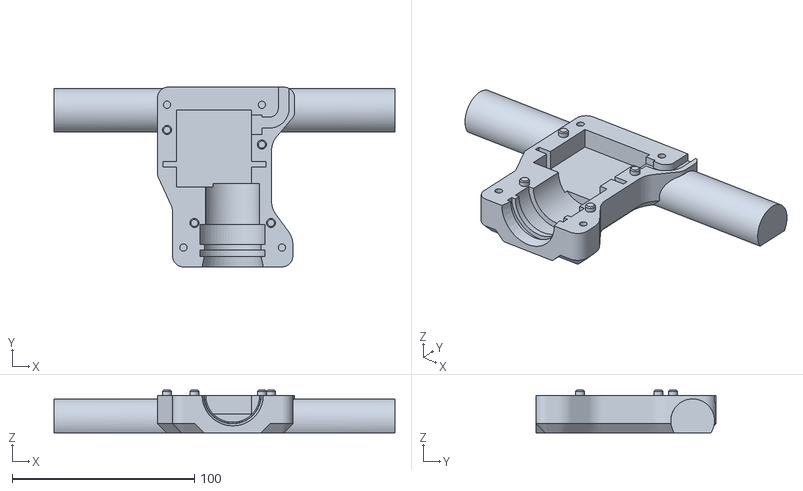
[picture p82: CAD file, 2026-11-03]
print-parts/locator-fit-assembly/petg-housing-lower.stl
187.0 x 98.6 x 23.4
