jeffglousher/garden-auger-technic/print-parts/no-ring/petg-one-piece-auger.stl

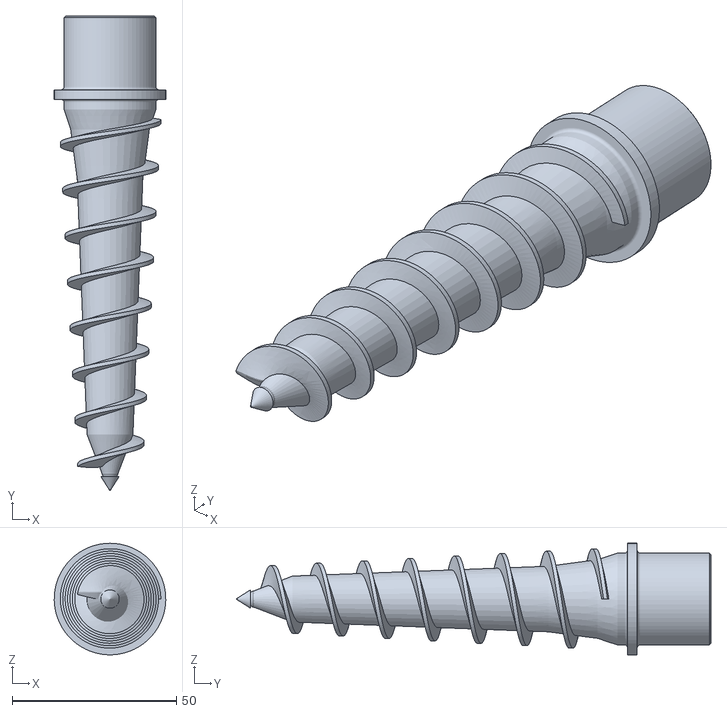
[picture p83: CAD file, 2026-10-04]
print-parts/no-ring/petg-one-piece-auger.stl
34.0 x 144.7 x 34.0
