jeffglousher/garden-auger-technic/print-parts/relieved-assembly/petg-housing-lower.stl

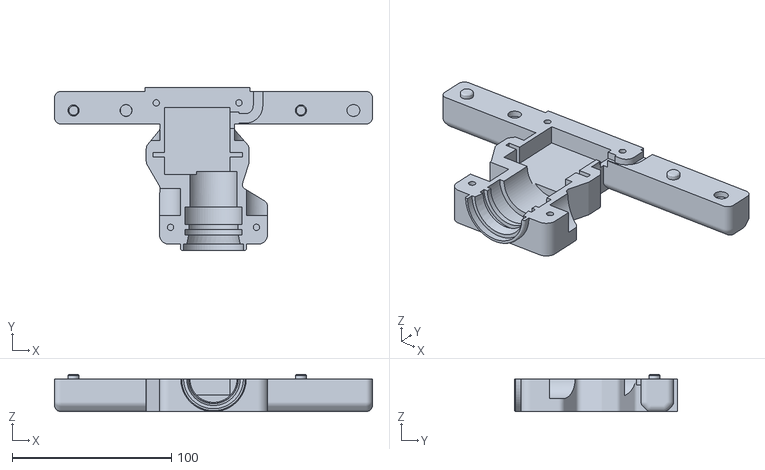
[picture p84: CAD file, 2026-10-18]
print-parts/relieved-assembly/petg-housing-lower.stl
200.0 x 102.6 x 23.4
