jeffglousher/garden-auger-technic/print-parts/rounded-envelope-assembly/petg-housing-upper.stl

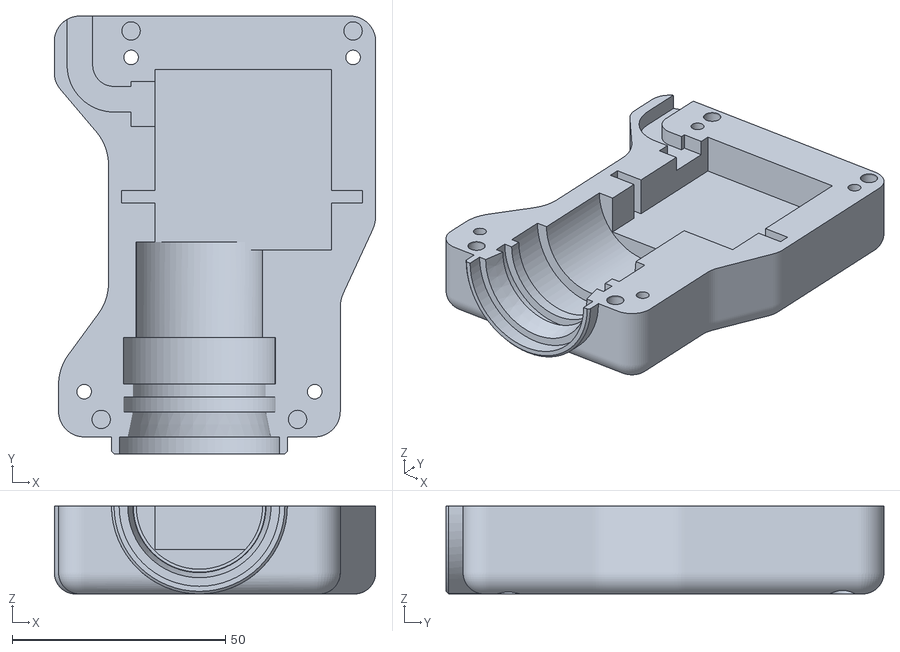
[picture p85: CAD file, 2026-10-20]
print-parts/rounded-envelope-assembly/petg-housing-upper.stl
75.3 x 102.6 x 20.6
