jeffglousher/garden-auger-technic/print-parts/simple-print-assembly/petg-one-piece-auger.stl

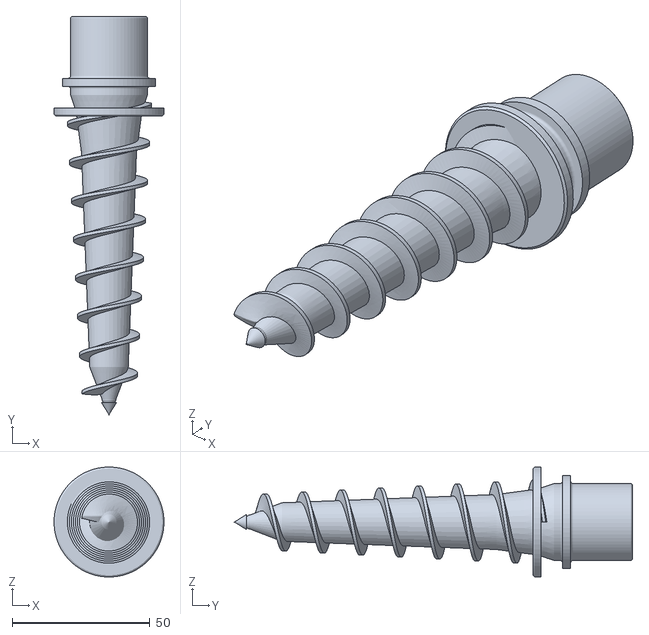
[picture p86: CAD file, 2026-10-30]
print-parts/simple-print-assembly/petg-one-piece-auger.stl
40.0 x 144.7 x 40.0
