jeffglousher/garden-auger-technic/print-parts/solid-frame-assembly/petg-housing-upper.stl

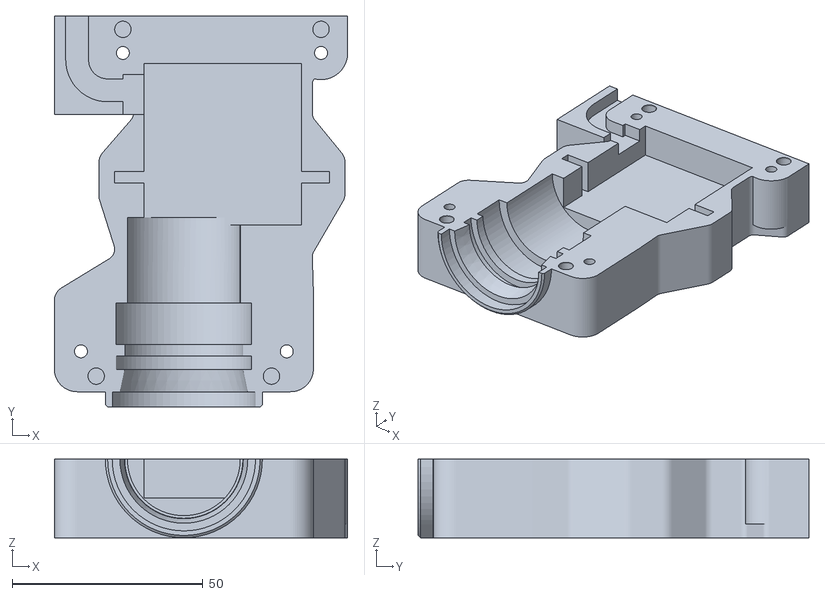
[picture p87: CAD file, 2026-10-19]
print-parts/solid-frame-assembly/petg-housing-upper.stl
77.0 x 102.6 x 20.6
