jeffglousher/garden-auger-technic/print/garden-auger-lettering-finish-ams-coupons.3mf

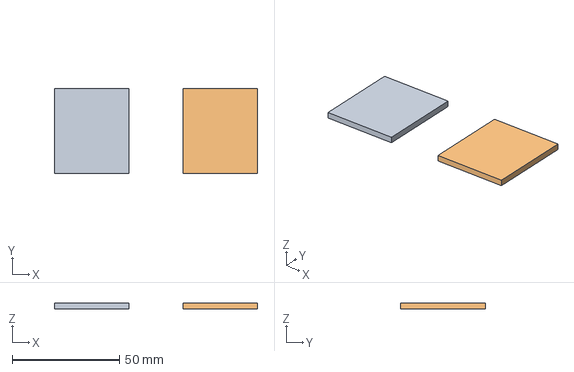
[picture p88: CAD file, 2026-11-09]
print/garden-auger-lettering-finish-ams-coupons.3mf
94.6 x 39.5 x 2.72 mm
8 mm - 105 percent top flow
8 mm - 105 percent top flow and background ironing
