jeffglousher/garden-auger-technic/print/parts/housing-lower.stl

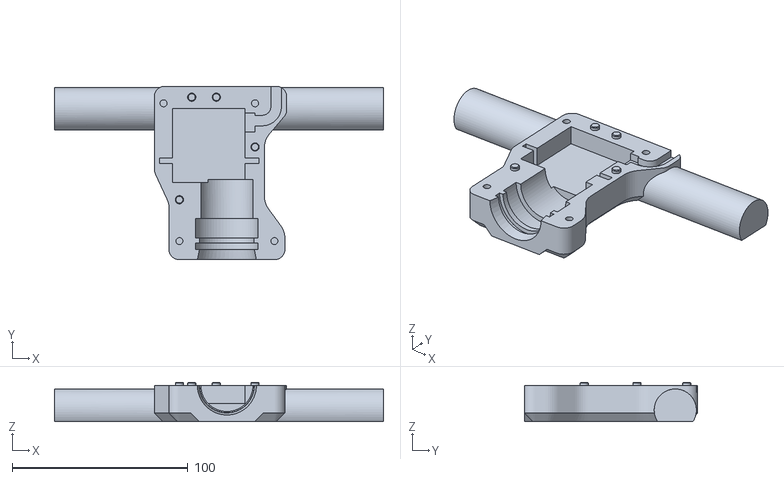
[picture p89: CAD file, 2026-11-08]
print/parts/housing-lower.stl
187.0 x 98.6 x 22.4
