jeffglousher/garden-auger-technic/source/auger.STEP

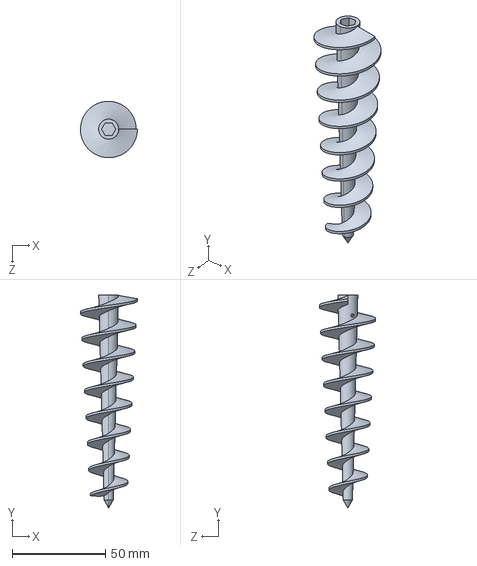
[picture p90: CAD file, 2026-09-26]
source/auger.STEP
30.6 x 114.3 x 30.3 mm
