jeffglousher/garden-auger-technic/source/horn-1906-0025-0032/1906-0025-0032.STEP

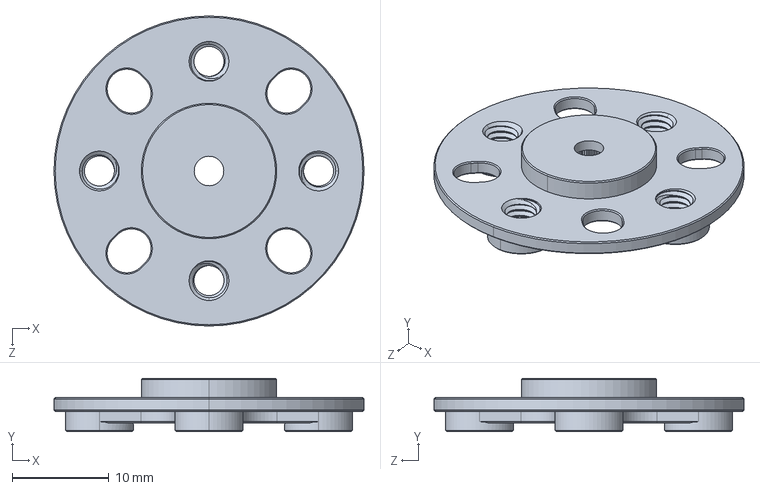
[picture p91: CAD file, 2026-10-04]
source/horn-1906-0025-0032/1906-0025-0032.STEP
32.0 x 5.50 x 32.0 mm
