jeffglousher/garden-auger-technic/print-parts/direct-drive/petg-housing-upper.stl

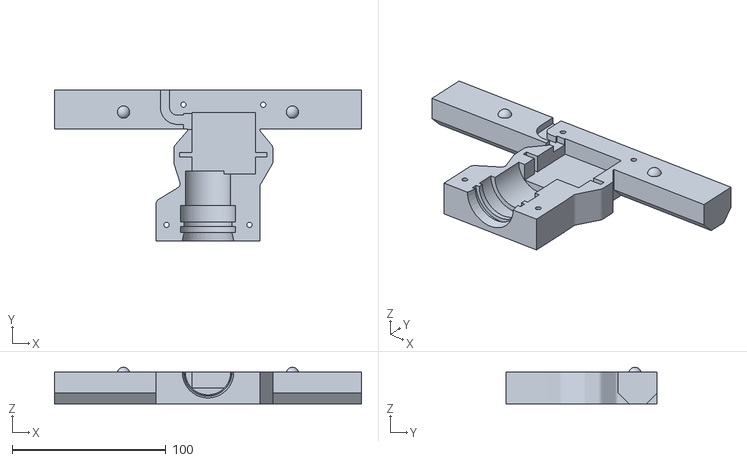
[picture p92: CAD file, 2026-10-06]
print-parts/direct-drive/petg-housing-upper.stl
200.0 x 98.6 x 23.8
