jeffglousher/garden-auger-technic/print-parts/no-ring/petg-square-adapter.stl

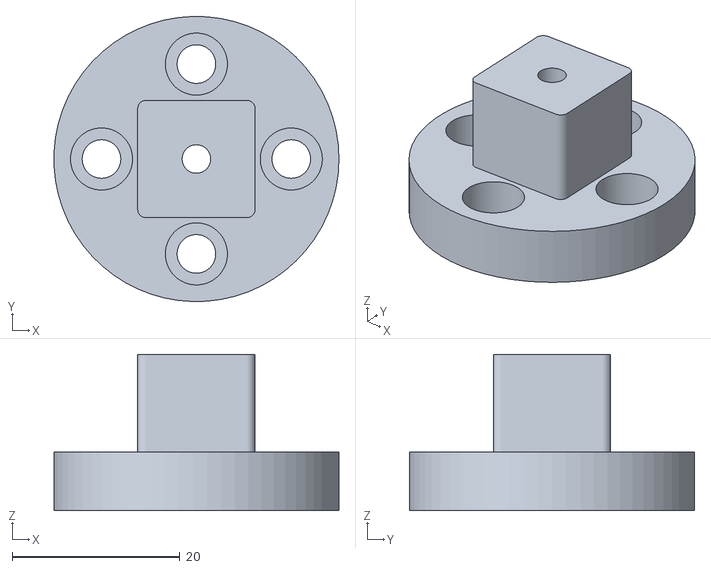
[picture p93: CAD file, 2026-10-04]
print-parts/no-ring/petg-square-adapter.stl
34.0 x 34.0 x 18.6
