jeffglousher/garden-auger-technic/source/coupler.STEP

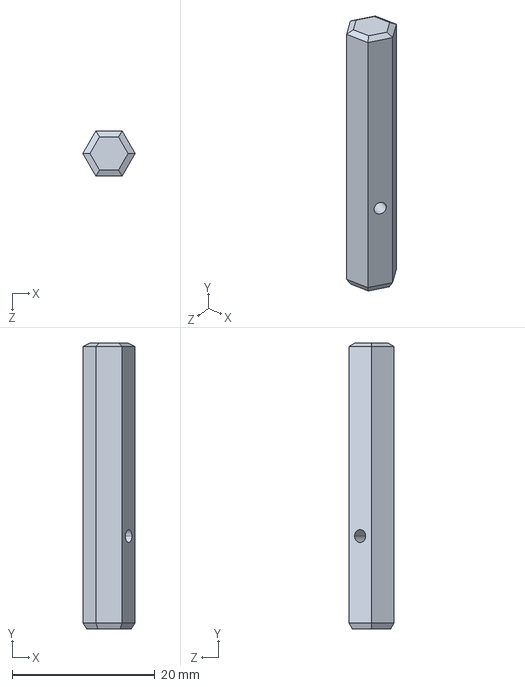
[picture p94: CAD file, 2026-09-26]
source/coupler.STEP
7.33 x 40.0 x 6.35 mm
