jeffglousher/garden-auger-technic/print-parts/direct-drive/press-fit-a-5.60.stl

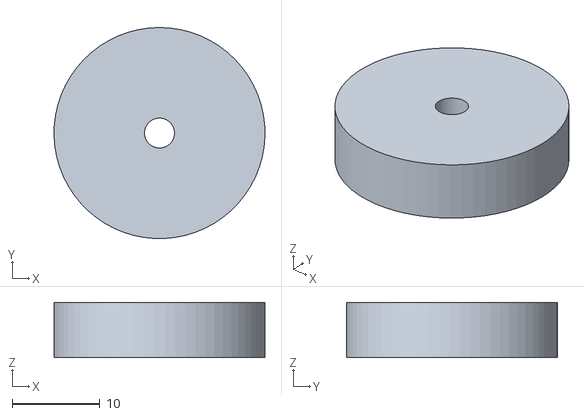
[picture p95: CAD file, 2026-10-04]
print-parts/direct-drive/press-fit-a-5.60.stl
24.0 x 24.0 x 6.30
