jeffglousher/garden-auger-technic/print-parts/no-ring/petg-housing-lower.stl

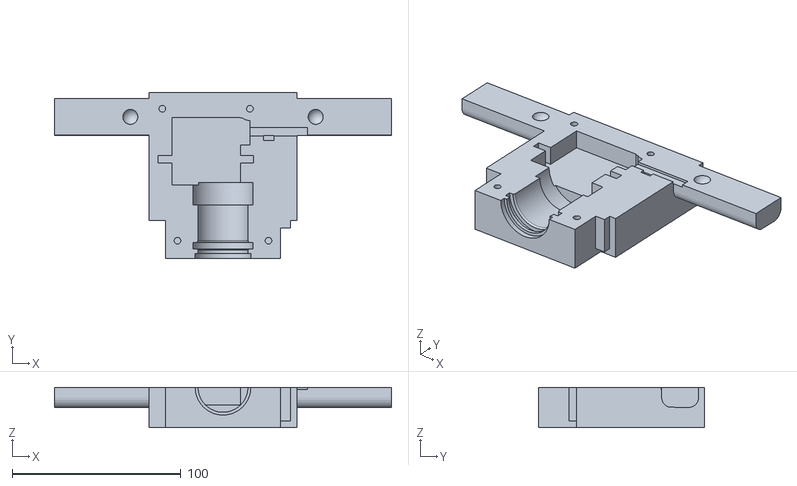
[picture p96: CAD file, 2026-10-04]
print-parts/no-ring/petg-housing-lower.stl
200.0 x 98.6 x 24.0
