jeffglousher/garden-auger-technic/print/garden-auger-lettering-single-color-coupons.3mf

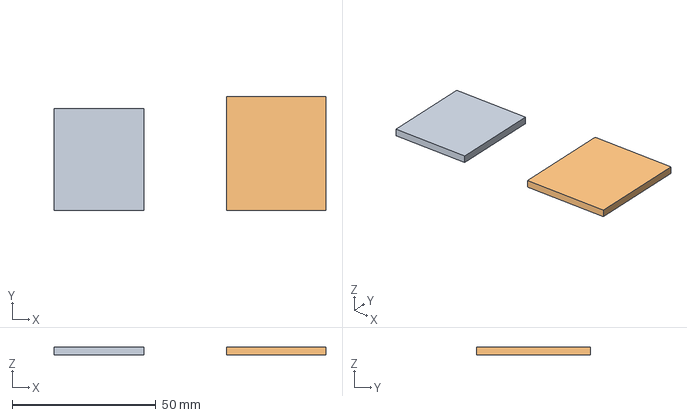
[picture p97: CAD file, 2026-11-08]
print/garden-auger-lettering-single-color-coupons.3mf
94.6 x 39.5 x 2.72 mm
7 mm heavy text
8 mm heavy text
