jeffglousher/garden-auger-technic/print/parts/bushing.stl

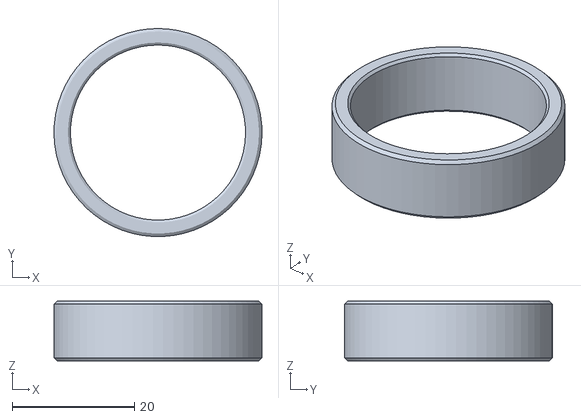
[picture p98: CAD file, 2026-11-05]
print/parts/bushing.stl
34.0 x 34.0 x 9.80
