jeffglousher/garden-auger-technic/print-parts/no-ring/petg-housing-upper.stl

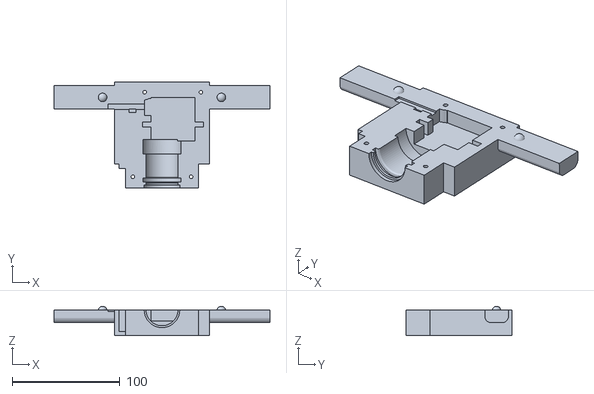
[picture p99: CAD file, 2026-10-04]
print-parts/no-ring/petg-housing-upper.stl
200.0 x 98.6 x 27.2
