jeffglousher/garden-auger-technic/print-parts/direct-drive/petg-square-adapter.stl

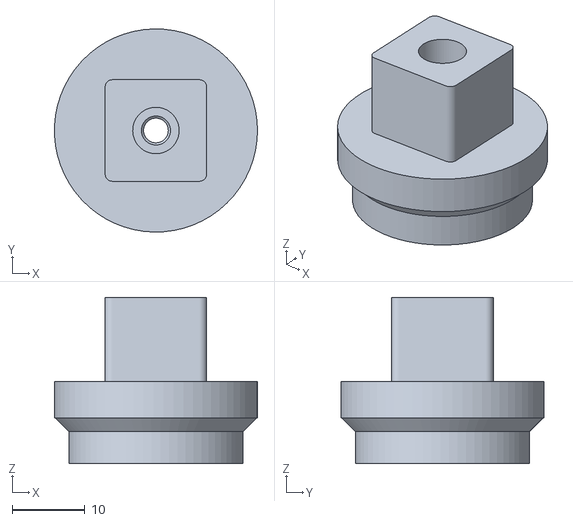
[picture p100: CAD file, 2026-10-04]
print-parts/direct-drive/petg-square-adapter.stl
28.0 x 28.0 x 22.9
