jeffglousher/garden-auger-technic/print/garden-auger-coupons.3mf

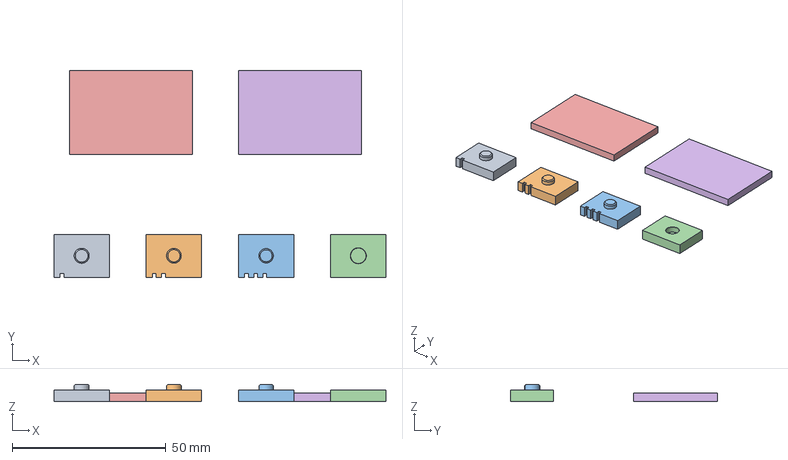
[picture p101: CAD file, 2026-11-08]
print/garden-auger-coupons.3mf
108.0 x 67.2 x 5.60 mm
1 notch pin - diameter 4.9 mm
2 notch pin - diameter 4.8 mm
3 notch pin - diameter 4.7 mm
Common 5.00 mm socket
Same-color PETG writing
Contrast PETG writing
