jeffglousher/garden-auger-technic/garden-auger-bambu-latest.3mf

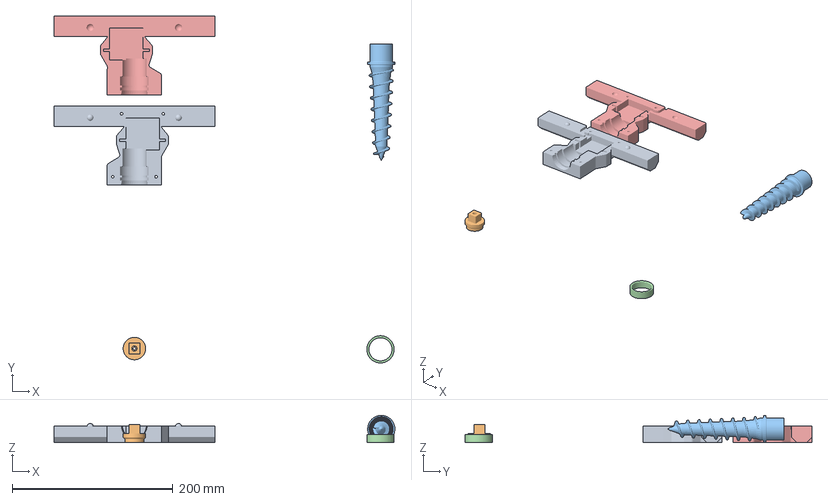
[picture p102: CAD file, 2026-10-06]
garden-auger-bambu-latest.3mf
424.2 x 431.8 x 34.0 mm
PETG - Housing upper
PETG - Square adapter
PETG - One-piece auger
PLA - Full wear sleeve
PETG - Housing lower
