jeffglousher/garden-auger-technic/garden-auger-press-fit.3mf

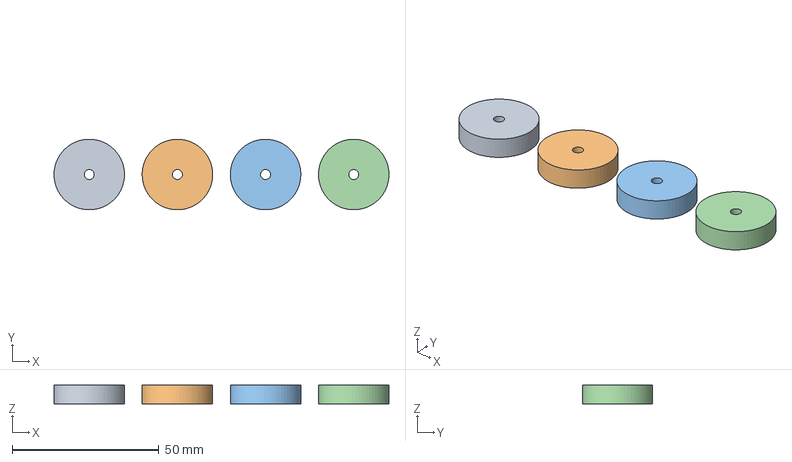
[picture p104: CAD file, 2026-10-05]
garden-auger-press-fit.3mf
114.0 x 24.0 x 6.30 mm
PETG - Round press fit A - bore 5.60
PETG - Round press fit B - bore 5.70
PETG - Round press fit C - bore 5.80
PETG - Round press fit D - bore 5.90
