jeffglousher/garden-auger-technic/garden-auger-fit-check.3mf

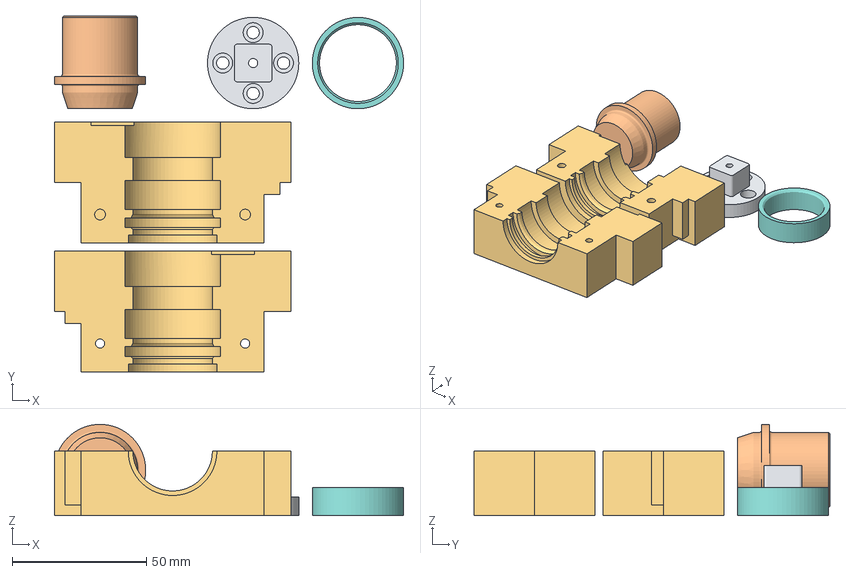
[picture p105: CAD file, 2026-10-04]
garden-auger-fit-check.3mf
130.0 x 132.5 x 34.0 mm
PETG - Housing upper
PETG - Housing lower
PETG - Journal fit coupon
PETG - Square adapter
PLA - Full wear sleeve
