jeffglousher/garden-auger-technic/garden-auger-slice.3mf

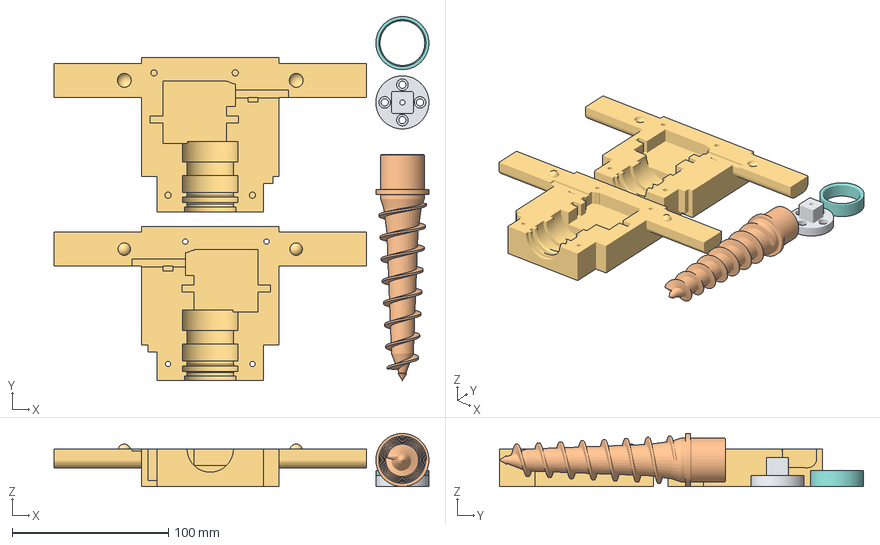
[picture p106: CAD file, 2026-10-04]
garden-auger-slice.3mf
240.0 x 233.0 x 34.0 mm
PETG - Housing upper
PETG - Housing lower
PETG - One-piece auger
PETG - Square adapter
PLA - Full wear sleeve
