jeffglousher/garden-auger-technic/garden-auger-no-ring.3mf

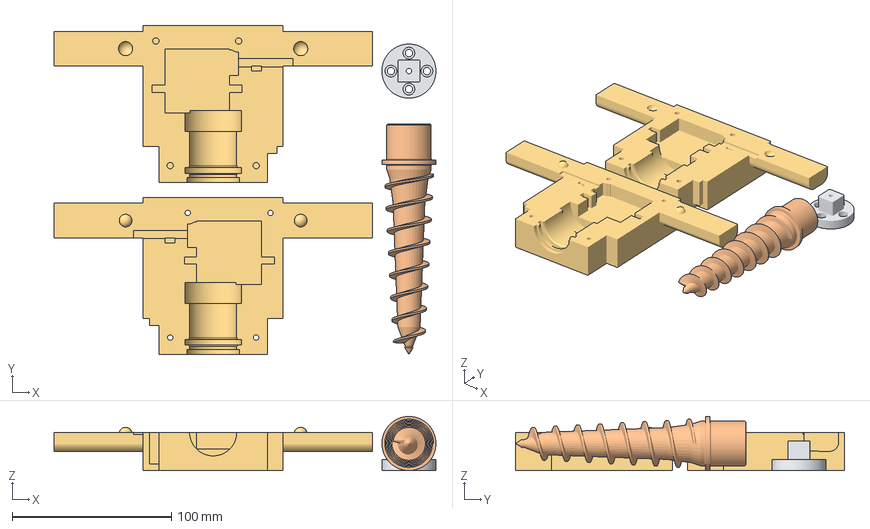
[picture p107: CAD file, 2026-10-04]
garden-auger-no-ring.3mf
240.0 x 206.6 x 34.0 mm
PETG - Housing upper
PETG - Housing lower
PETG - One-piece auger
PETG - Square adapter
