jeffglousher/garden-auger-technic/garden-auger-bambu-review.3mf

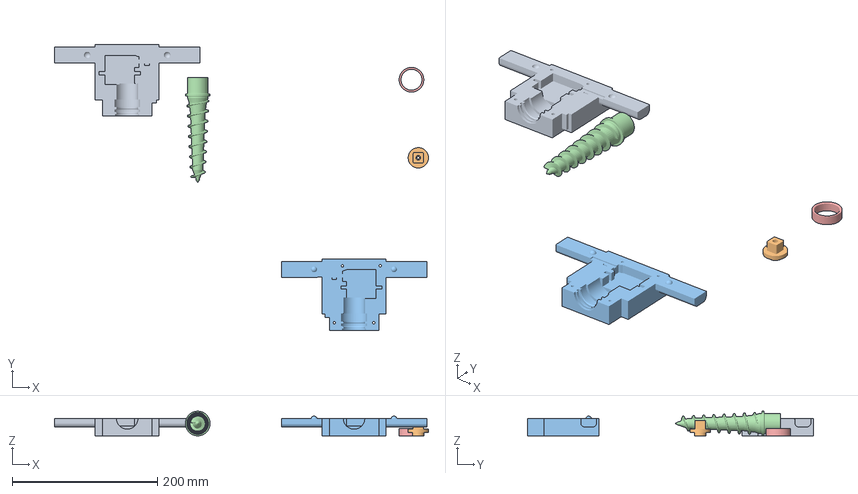
[picture p108: CAD file, 2026-10-04]
garden-auger-bambu-review.3mf
514.5 x 393.3 x 34.0 mm
PETG - Housing lower
PETG - Square adapter
PETG - Housing upper
PETG - One-piece auger
PLA - Full wear sleeve
