jeffglousher/garden-auger-technic/(list of files, cad)

Other CAD files:
garden-auger-three-wall-assembly.3mf
garden-auger-locator-fit-assembly.3mf
garden-auger-simple-print-assembly.3mf
print-parts/relieved-assembly/petg-housing-upper.stl
print/garden-auger-lettering-finish-single-color-coupons.3mf
print/parts/housing-upper.stl
print-parts/direct-drive/press-fit-c-5.80.stl
print/garden-auger-lettering-ams-coupons.3mf
print/garden-auger-single-color.3mf
print-parts/direct-drive/press-fit-d-5.90.stl
print/garden-auger.3mf
print-parts/direct-drive/press-fit-b-5.70.stl
garden-auger-upper-rounded-housing-sparse-test.3mf
garden-auger-lower-rounded-housing-sparse-test.3mf
garden-auger-upper-servo-sparse-test.3mf
garden-auger-lower-fit-test.3mf
garden-auger-lower-servo-snug-test.3mf
garden-auger-lower-servo-sparse-test.3mf
garden-auger-lower-servo-27mm-test.3mf
garden-auger-direct-adapter.3mf
garden-auger-pla-bushing.3mf
garden-auger-petg.3mf
print-parts/petg-housing-lower.stl
print-parts/petg-housing-upper.stl
source/auger.SLDPRT
source/coupler.SLDPRT
