jeffglousher/garden-auger-technic/renders/bambu-print-layout.png

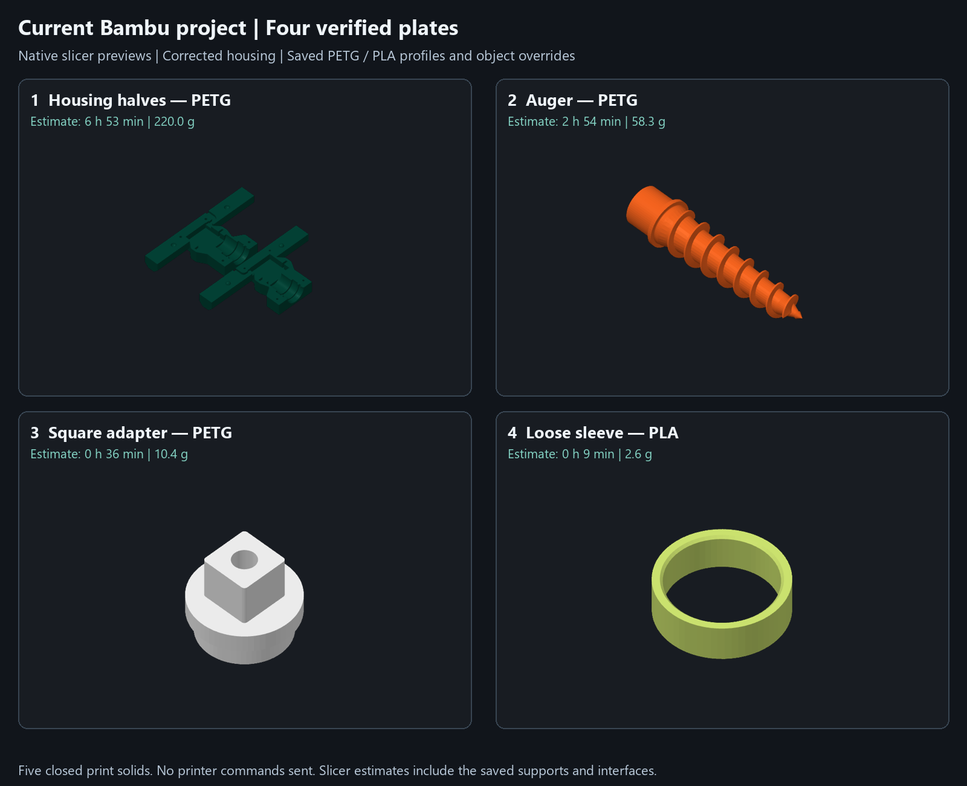
renders/bambu-print-layout.png
