jeffglousher/garden-auger-technic/renders/cad-assembly-animation.gif

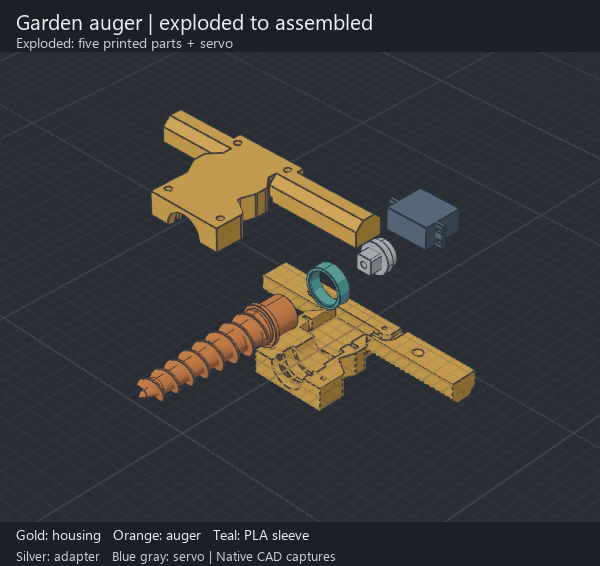
renders/cad-assembly-animation.gif
