jeffglousher/garden-auger-technic/renders/cad-assembly-assembled.png

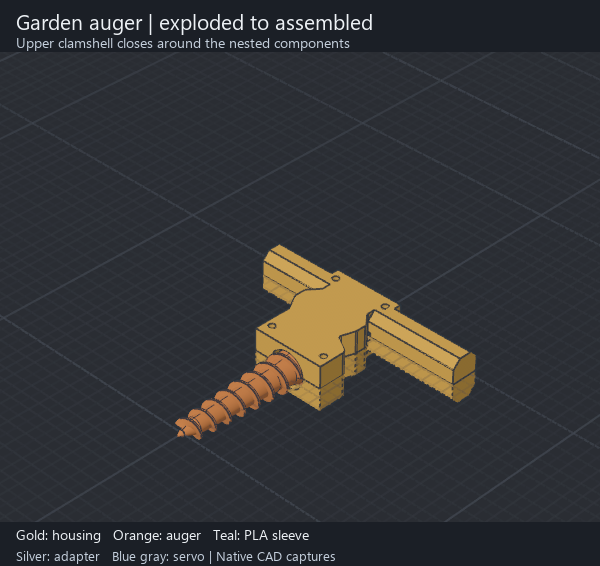
renders/cad-assembly-assembled.png
