jeffglousher/garden-auger-technic/renders/cad-fit-assembled.png

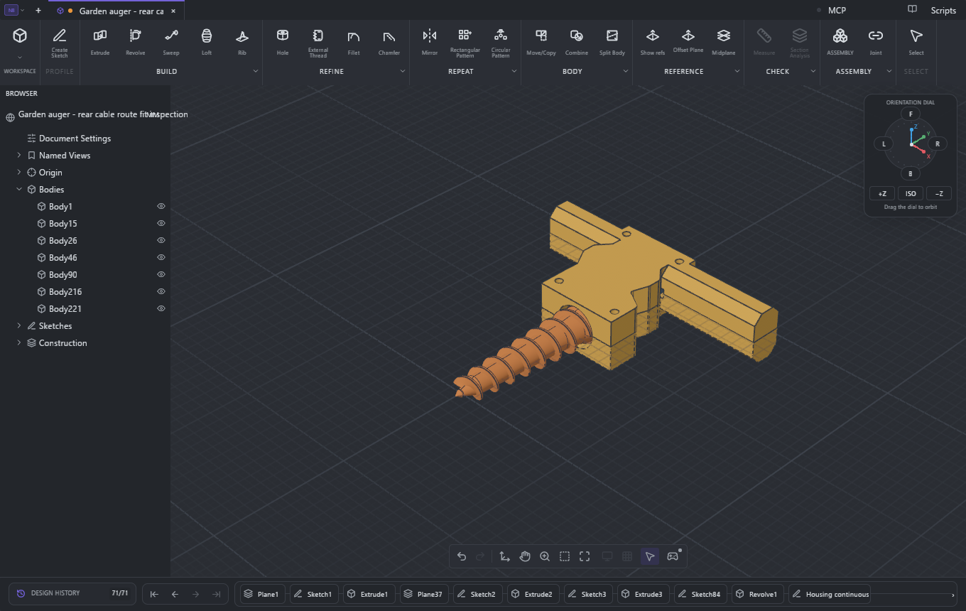
renders/cad-fit-assembled.png
