jeffglousher/garden-auger-technic/renders/captured-assembly.png

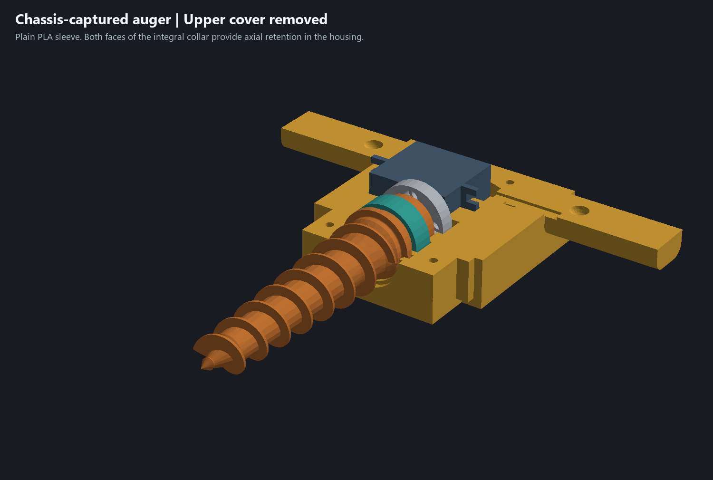
renders/captured-assembly.png
