jeffglousher/garden-auger-technic/renders/relieved-assembly/assembled.png

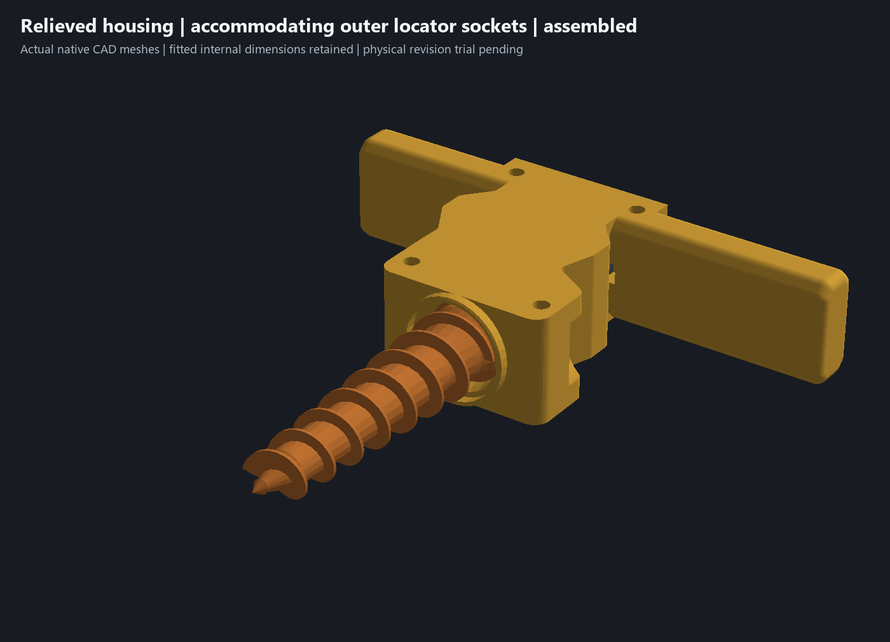
renders/relieved-assembly/assembled.png
