jeffglousher/garden-auger-technic/renders/relieved-assembly/auger-entry.png

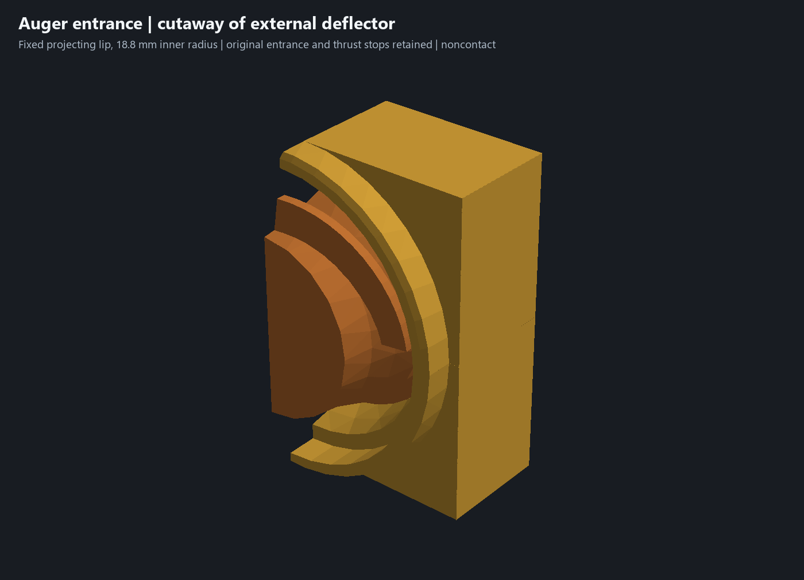
renders/relieved-assembly/auger-entry.png
