jeffglousher/garden-auger-technic/renders/relieved-assembly/plate-1.png

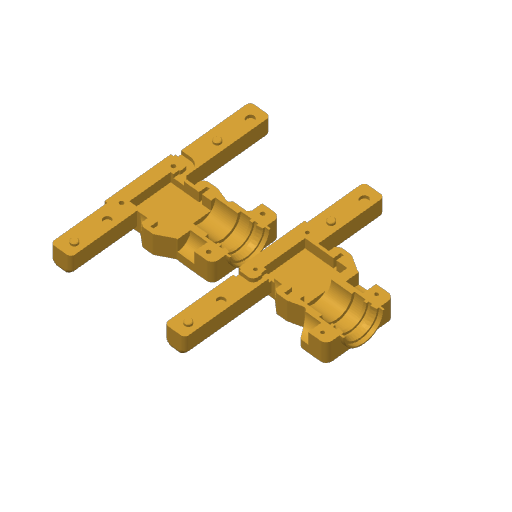
renders/relieved-assembly/plate-1.png
