jeffglousher/garden-auger-technic/renders/relieved-assembly/sculpted-shoulders.png

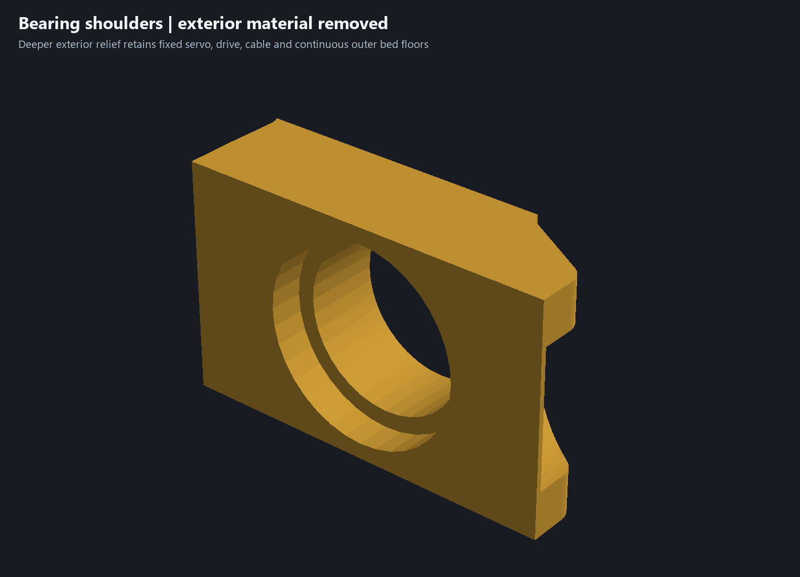
renders/relieved-assembly/sculpted-shoulders.png
