jeffglousher/garden-auger-technic/renders/simple-print/entrance-closeup.png

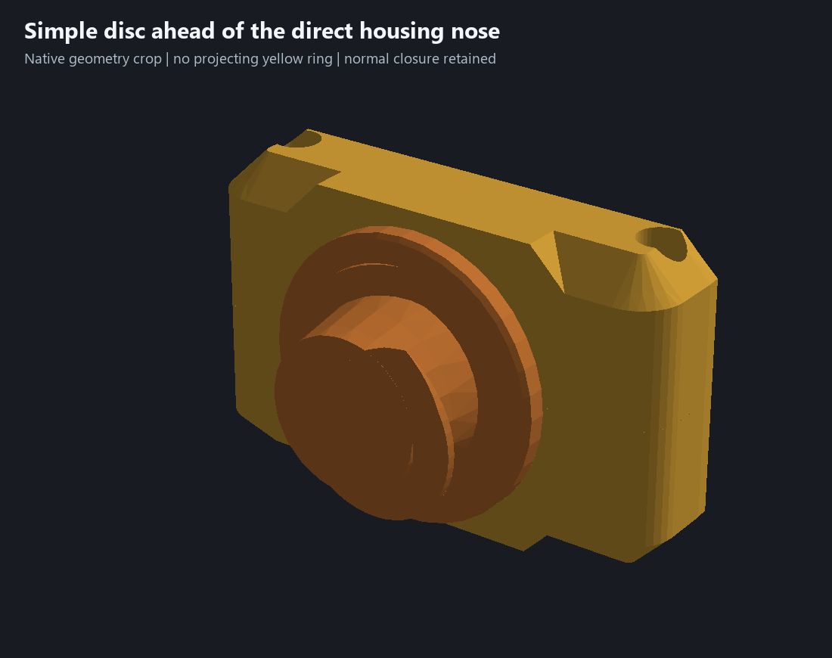
renders/simple-print/entrance-closeup.png
