jeffglousher/garden-auger-technic/renders/simple-print/lower-print-face.png

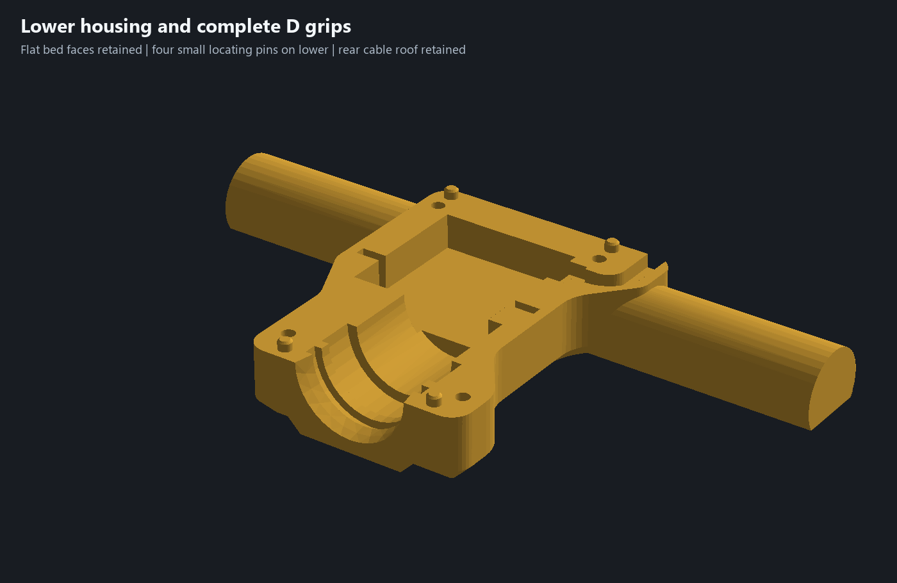
renders/simple-print/lower-print-face.png
