jeffglousher/garden-auger-technic/renders/simple-print/plate-2.png

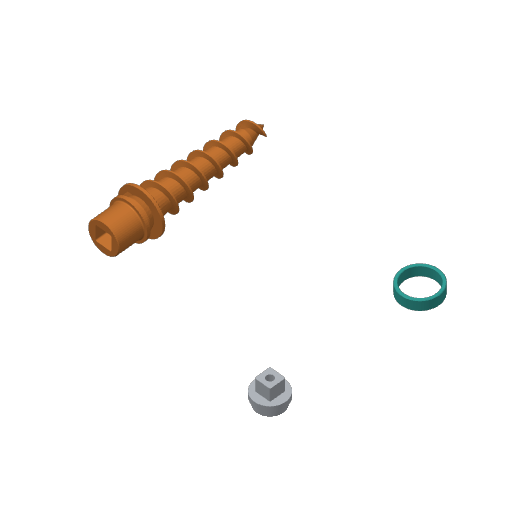
renders/simple-print/plate-2.png
