jeffglousher/garden-auger-technic/(commit log)

2026-09-26 Import the gardening auger and coupler for a Technic drive.
    The originals stay in source. The coupler is the part to change.
2026-10-04 Save direct-drive auger CAD and complete Bambu print project
2026-10-04 Deepen H25T adapter socket and strengthen servo boss
2026-10-04 Simplify printed housing to collar and sleeve nesting seats
2026-10-04 Purge superseded print files and save current Bambu setup
2026-10-04 Fix clamshell flight clearance and servo ear capture before printing
2026-10-05 Correct servo ear datums and verify housing fit from drawing
    Move the ear pockets 2.7 mm forward, clear the larger case envelope, and extend the adapter chamber for the conservative axial stack. Reproduce the old false clearance pass with an independent native servo probe, preserve non-housing print geometry, and refresh verified CAD views and all four Bambu plates.
2026-10-05 Record direct live CAD validation and associative fit measurements
    Open the corrected assembly through the Limo CAD tool, retain exact interference and native checker warnings, and save a schema-10 inspection copy with topology-linked drawing dimensions. Document the tool's GD&T, hole recognition, print-layout and absent-hardware limits while preserving every print artifact.
2026-10-06 Thin servo housing floor and walls with native CAD and slicer validation
2026-10-06 Flatten housing print faces and smooth servo ear transitions
2026-10-06 Route servo cable away from handles and add native envelope checks
2026-10-06 Move the servo cable outlet to the rear face
2026-10-07 Add native CAD exploded and reassembly presentation
2026-10-07 Record failed physical servo fit and native dimension audit
2026-10-07 Add measured servo rear-clearance test and native failure regression
2026-10-07 Tighten servo locating nest and review native mating dimensions
2026-10-08 Prepare sparse single-half servo fit print and validate Bambu loading
2026-10-08 Record successful assembly fit and retire obsolete artifacts
2026-10-09 Refine clamshell registration, common screw stacks and auger entry guard
2026-10-14 Record owner reconfirmation that CAD development hold is lifted
2026-10-14 Round housing sides and audit sleeve clearances against print geometry
2026-10-15 Fit replacement PLA bushing to fixed assembly constraints
2026-10-16 Package and validate the complete current auger assembly
2026-10-18 Combine auger plates and refine housing relief and locators
2026-10-18 Lower and round housing grips with sequential two-plate layout
2026-10-19 Remove cosmetic seam recesses from closed housing frame
2026-10-20 Slim and round both housing face pairs with blended side profile
2026-10-30 Use consistent 45-degree housing chamfers and flat nose lands
2026-10-30 Simplify the printed nose and reduce flange height and support work
2026-10-30 Trim rotating shield to 38mm with verified opening coverage
2026-11-01 Add current assembly center sections and individual part review
2026-11-03 Tighten and enlarge locators away from insert screw stacks
2026-11-03 Set locator pins and sockets to zero nominal clearance
2026-11-04 Engrave part IDs and assembly dimensions inside housing
2026-11-04 Report remaining engraving floor from actual bed datum
2026-11-04 Record fresh interference checks and single-plate clearance trial
2026-11-05 Publish a minimal named Limo CAD auger example
2026-11-06 Show the auger in motion, exploded, labeled and ready to print
2026-11-07 Use Limo CAD identity in model and print metadata
2026-11-07 Fix housing lettering and confine reinforcement to infill
2026-11-07 Keep smaller reinforcement rings entirely inside printed parts
2026-11-07 Remove automatic housing support feet and disable brims
2026-11-07 Shorten and relocate housing alignment features
2026-11-08 Add locating-fit and flush-lettering print coupons
2026-11-09 Add top-skin flow and ironing coupon trials
